hflocki/camper-mqtt/firmware/display/README.md

> [!WARNING]
> **IN ENTWICKLUNG – kein fertiges Projekt.** Am echten LIN-Bus (Truma) noch nicht getestet. Nutzung auf eigenes Risiko.

# Display Node – Guition 4" Wandpanel + Webseite per MQTT

Firmware für das **Guition ESP32-4848S040** (4", 480×480 Touch, ESP32-S3, 16 MB Flash, 8 MB PSRAM). Das Display hängt fest an der Wand und zeigt alle Camper-Werte gesammelt an; dieselben Seiten gibt es zusätzlich als **Webseite** direkt vom Display – z. B. auf Handy oder Tablet im Bett. Beide werden live über **MQTT** versorgt und können steuern. Reines **Arduino**, ohne ESPHome und ohne Home Assistant als Voraussetzung.

Passt zu den anderen Projekten:

| Gerät | Repo | Standard-Topic |
| --- | --- | --- |
| Frischwasser, Grauwasser, Gas | [tanklevel-node](../tanklevel) | `camper/tanklevel` |
| Ausrichtung (BNO085) | [level-node](../level) | `camper/level` ¹ |
| Truma Combi Heizung | [heater-node](../heater) oder CampMatic-Box, siehe [Heizung über CampMatic](#heizung-über-campmatic) | `camper/heater` ² |
| MaxxFan (VanTurtle) | [maxxfan-node](../maxxfan) | `camper/maxxfan` |
| Temperaturen (DS18B20) | [temp-node](../temp) | `camper/temp` |
| Batterien (Daly, Ective, BM2) | [battery-node](../battery) | `camper/battery` |
| Router (GPS, Mobilfunk) | Teltonika RUT956, siehe [Router-Daten](#router-daten-rut956) | frei |
| Zigbee2MQTT & alles andere | eigene Seiten und Kacheln | frei |

¹ Wer noch die Original-Firmware von klehnst nutzt (ab Werk `wowa/level`): dort den MQTT-Prefix auf `camper/level` stellen oder hier unter *Topics der Geräte* `wowa/level` eintragen.
² Bis heater-node 1.0 war der Standard `service/truma`. Ältere Geräte behalten ihre Einstellung; dann hier oder im Heizungs-Web-UI angleichen.

<p>
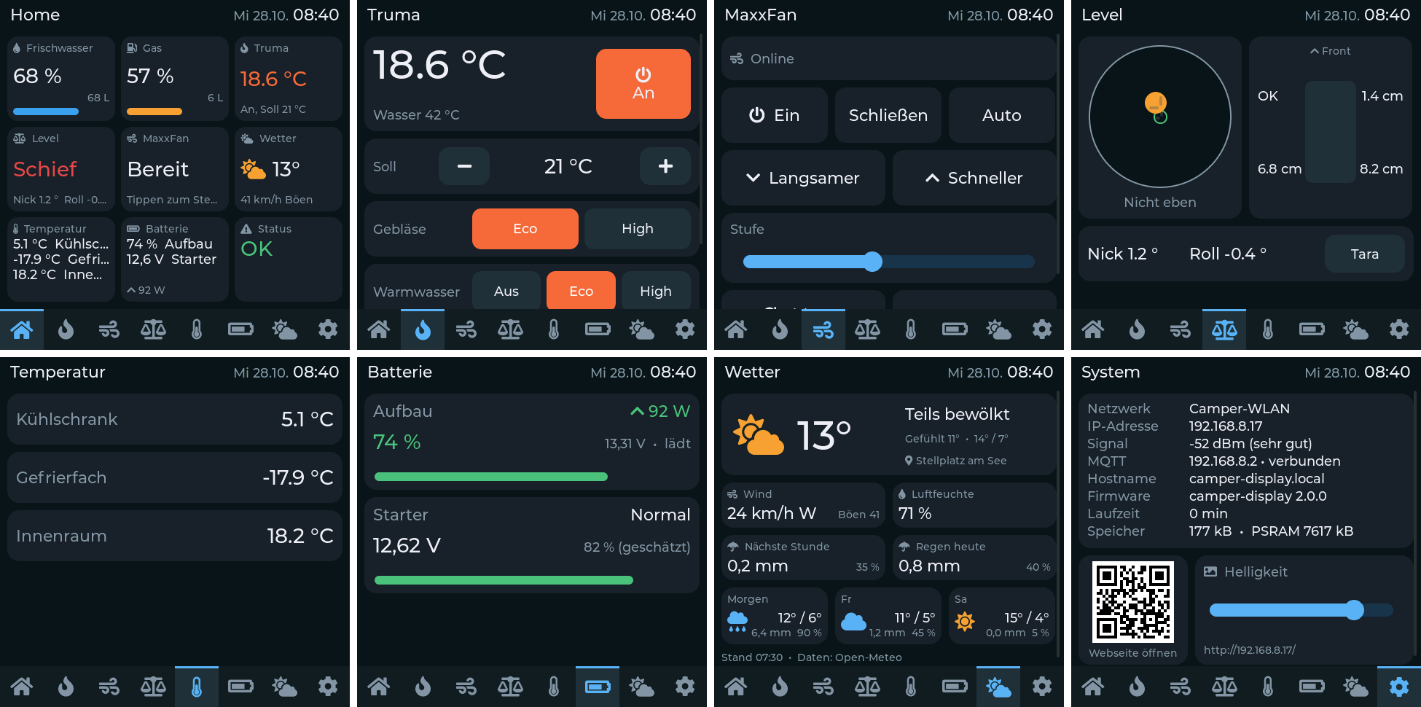
[picture p3: firmware/display/docs/display-seiten.png]

</p>
<p>

</p>
<p>
  
</p>

## Funktionen

- **Wandpanel** mit LVGL-Oberfläche: Icon-Leiste unten zum Wechseln der Seiten (oder wischen), deutsche Umlaute und Icons
- **Webseite** mit denselben Seiten, Werte in Echtzeit per WebSocket, für Handy optimiert, hell/dunkel automatisch. Unten eine Icon-Leiste wie am Display: Home und System immer, dazwischen so viele der gewählten Seiten, wie in die Breite passen (am Handy hochkant meist 3). Die Seite **System** zeigt Verbindung, Firmware, Helligkeit und alle **📡 Geräte im Netz** (aus `camper/+/status` und `camper/+/info`: online/offline, Version, Signal, Laufzeit; am Display ebenfalls auf der Systemseite, dort ganz oben; darunter QR-Code und Helligkeit, dann die Angaben zum Display selbst). Alte Einträge, die nach einem Topic-Wechsel am Broker liegen geblieben sind (offline oder „online“ ohne Info, gelber bzw. grauer Punkt), lassen sich auf der Webseite mit ✕ vom Broker löschen; tragen zwei Geräte denselben Namen, steht das Topic dahinter, z. B. „Heizung (truma)“ und führt zu ⚙ Einstellungen, ⚡ Automationen, 🔗 Geräte und allen Seiten, die keinen Knopf in der Leiste haben
- **📡 Eigene Sensoren:** Zigbee-Kontakte und -Klimasensoren direkt vom Gateway (Cluster-Topics, z. B. SMLIGHT) und Bluetooth-Thermometer über OpenMQTTGateway (Govee, Ruuvi, Xiaomi …), siehe [Sensoren](#sensoren-zigbee--bluetooth)
- **⚡ Automationen:** Regeln wie „Tür auf → Eingangslicht an, Tür zu → nach 10 s aus, nur wenn dunkel“, siehe [Automationen](#automationen)
- **Display aufwecken:** Ist der Bildschirm gedimmt oder aus, zeigt die Webseite oben den Knopf **💡 Display an**.
- **Feste IP abgesichert:** Eine feste IP, die nicht funktionieren kann (Gateway außerhalb des Netzes, falsches Subnetz), wird beim Speichern abgelehnt. Verbindet sich das Display mit fester IP zwar mit dem WLAN, erreicht aber 3 Minuten lang den MQTT-Broker nicht, schaltet es bis zum nächsten Neustart auf DHCP (Hinweis auf der Systemseite). Auf der Systemseite gibt es außerdem den Knopf *Feste IP aus (DHCP)* – lange drücken, das Display startet mit DHCP neu
- **Geräte-Links (nur Webseite):** Unter *Einstellungen → 🔗 Geräte-Links* Name und Adresse der anderen Geräte eintragen (oder „VanNode-Geräte vorschlagen“ für die `.local`-Namen). Die Seite **🔗 Geräte** (über *System*) zeigt sie als Buttons, die die jeweilige Konfigurationsseite in einem neuen Tab öffnen
- **Anzeigename:** Unter *Einstellungen → Display & Seiten* lässt sich ein Name eintragen (z. B. „Wohnraum“), der oben in der Mitte neben dem Seitentitel steht – am Display und auf der Webseite. Leer = kein Name
- **Übersicht ohne Scrollen:** 3 × 3 Kacheln, Standard: Frischwasser, Grauwasser, Gas, Truma, Level, MaxxFan, Temperatur (bis 3 Sensoren), Batterie (bis 3), jeweils mit Symbol statt Name (siehe *Symbole* unten) und Status (grün „OK“ oder die Warnungen auf dunklem Gelb). Antippen öffnet die jeweilige Seite. **Welche Kachel wo steht, ist frei wählbar** (*Einstellungen → Display & Seiten → Kacheln der Übersicht*): zusätzlich einzelne Batterien (Batterie 1–3 groß), **Dachhaube**, Uhr/Datum, eigene MQTT-Kacheln aus *Seiten & Kacheln* oder leer. Die Webseite übernimmt dieselbe Reihenfolge
- **Feste Seiten:** Home · Truma · MaxxFan · Level · Temperatur · Batterie · **Wetter** · **Sensoren** (Fenster, Türen und weitere Sensoren) · **Warnungen** · **Licht** · **Schalter** · **Energie** und **Extra** (zwei freie Seiten für später, ab Werk aus) · **Dachhaube** (Heki über die toolbox-node, ab Werk aus) – einzeln abschaltbar und **System** (Netzwerk, IP, Signal, MQTT, Firmware, Laufzeit, Speicher als Liste, dazu QR-Code und Helligkeit). **Name und Symbol** jeder festen Seite (auch System) lassen sich unter *Einstellungen → 🖥 Anzeige → Seiten & Symbolleiste* ändern; sie erscheinen in der Kopfzeile, auf den Kacheln der Übersicht und auf der Webseite
- **Kopfzeile:** Seitenname · Anzeigename · Datum · Uhr. Antippen springt zur Übersicht. Bei Verbindungsproblemen steht dort „WLAN“ bzw. „MQTT“
- **Icon-Leiste unten:** 8 Knöpfe: **Home** und **System** sind immer da, dazu bis zu 6 frei wählbare Seiten (*Einstellungen → Display & Seiten → Symbolleiste*, leer = die ersten 6). Seiten ohne Knopf erreicht man über ihre Kachel auf Home oder durch Wischen, auf der Webseite über *System → Weitere Seiten*. Die aktive Seite ist hervorgehoben. Die Webseite nutzt dieselbe Auswahl
- **Wetter** von [Open-Meteo](https://open-meteo.com) (kostenlos, ohne Konto): aktuelles Wetter, nächste Stunde, heute und 3 Tage Vorschau. Fester Ort oder GPS per MQTT (z. B. vom Router), siehe [Wetter](#wetter)
- **Warnungen:** Temperatur-Alarme von temp-node, Heizungsfehler, Batterie- (mit dem Fehler des BMS im Klartext) und Wetter-Warnungen erscheinen in der Status-Kachel der Übersicht (dunkelgelb) (antippen öffnet die Seite **Warnungen** mit dem vollen Text; auf der Webseite ebenso) und als **dunkelgelbes Band mit Lauftext** in der Kopfzeile. Wer möchte, dass eine neue Warnung das Display einschaltet, setzt unter *Einstellungen → Display & Seiten* den Haken **Neue Warnung schaltet das Display ein** (Standard aus); war es dunkel, springt es dann auf die Übersicht. Optional zusätzlich als **Push-Nachricht** per Pushover
- **Temperatur- und Batterie-Kachel frei belegbar:** unter *Einstellungen → Display & Seiten* für die Temperatur-Kachel bis zu 6 Sensoren (auch eigene Zigbee-/Bluetooth-Sensoren; mehr als 3 wechseln alle 4 s, unten steht „1 / 2“), für die Batterie-Kachel bis zu 3 Batterien aus einer Liste wählen und dahinter das Symbol (Batterie, Starterbatterie, Wohnraum, Sonne, Solarpanel, Fahrzeug, Landstrom, Strom, Thermometer, Kühlschrank, Gefrierfach, Innenraum, Außen, Schlafen, Wasser, Heizung, Bad, Stauraum). Die Kachel zeigt dann Symbol und Wert in dieser Reihenfolge. Leer = alle Temperatursensoren bzw. die ersten 3 Batterien, „Symbol automatisch“ wählt nach dem Namen (z. B. Kühlschrank 🧊, Gefrierfach ❄️, Außen 🌳, Aufbau 🏠, Solar ☀️, Starter 🚗). Meldet ein gewählter Sensor nichts, steht dort „--“
- **Eigene Seiten und Kacheln** für beliebige MQTT-Topics: *Wert*, *Schalter*, *Taster*, *Regler* – erscheinen automatisch auf Display **und** Webseite
- **Topic-Finder:** lauscht z. B. auf `zigbee2mqtt/#`, zeigt alle Geräte mit ihren JSON-Werten; ein Klick legt eine Kachel an (Temperatur, Luftfeuchte, Licht an/aus, Helligkeit …)
- **Setup-WLAN** wie bei den anderen Projekten: ohne WLAN-Daten oder nach 1 Minute ohne Verbindung öffnet sich `Display-Node-XXXXXX`, Captive Portal unter `http://192.168.4.1`. Das Display zeigt dazu einen QR-Code zum Verbinden.
- **Stromausfallsicher:** keine SD-Karte, kein Dateisystem. Webseite und Oberfläche stecken in der Firmware, Einstellungen im NVS. Strom an → nach ca. 1–2 s läuft alles wieder.
- Bildschirm dimmt bzw. schaltet nach einstellbarer Zeit ab (Helligkeit gedimmt 0 = ganz aus), Berühren weckt (die erste Berührung löst nichts aus). Sofort ausschalten: **Kopfzeile lange drücken**, Knopf **Aus** auf der Systemseite oder **💤** oben auf der Webseite
- Uhrzeit per NTP, Firmware-Update über die Webseite (`.bin`-Datei, mit Fortschrittsbalken) oder Arduino-IDE-Netzwerkport
- **Einstellungen sichern und wiederherstellen** als JSON-Datei (ohne Passwörter)
- **Verlauf der letzten 24 h** als Kurven auf der Webseite: Temperaturen, Ladestand bzw. Spannung der Batterien
- **Warnungen für eigene Kacheln**, z. B. Landstrom über eine Zigbee-Messzange: Wert unter/über einer Grenze oder keine Daten mehr
- Eigene MQTT-Topics für Helligkeit, Bildschirm an/aus und Seitenwechsel (z. B. aus Home Assistant)

## Ordner

```
camper_display/            Sketch für die Arduino IDE
lv_conf.h                  LVGL-Konfiguration (muss in den libraries-Ordner, siehe unten)
tools/embed_web.py         packt web/index.html in web_ui.h
tools/make_fonts.py        erzeugt die Schriften font_de_*.c neu
docs/                      Screenshots
```

| Datei | Inhalt |
| --- | --- |
| `config.h` | Pins, Panel-Variante, Drehung, Standardwerte, `FW_VERSION` |
| `display_hw.*` | ST7701-RGB-Panel, GT911-Touch (ohne Library), Hintergrundlicht, LVGL-Treiber |
| `ui.*` | Display-Oberfläche (alle Seiten) |
| `datastore.*` | zentrale Werte aller Geräte und Kacheln, Topic-Zuordnung |
| `mqtt_client.*` | MQTT, Befehle an die Geräte, Topic-Finder |
| `web.*`, `web_ui.h`, `web/index.html` | Webserver, WebSocket, Einstellungs-API, Firmware-Update |
| `wifi_manager.*` | WLAN, feste IP, Setup-AP, mDNS, NTP |
| `settings.*` | Einstellungen, Seiten und Kacheln im NVS |
| `notify.*` | Push-Nachrichten per Pushover (eigener Task, HTTPS mit Zertifikatsprüfung) |
| `otaprog.*` | Fortschritt des Firmware-Uploads für den Update-Bildschirm |
| `history.*` | 24-h-Verlauf der Temperaturen und Batterien im RAM |
| `rules.*` | Automationen (Regeln, eigener NVS-Bereich) |
| `sensors.*` | Eigene Zigbee- und Bluetooth-Sensoren (eigener NVS-Bereich) |
| `icons.*` | Symbole und Auswahl für die Temperatur- und Batterie-Kachel |
| `weather.*` | Wetter von Open-Meteo (eigener Task), GPS-Position per MQTT, Wetter-Warnungen |
| `depart.*` | Abfahrtscheck: Fahrt aus dem GPS des Routers, Tür, Markise, Kontakte |
| `font_de_*.c` | Montserrat mit Umlauten + Font-Awesome-Icons, erzeugt mit `tools/make_fonts.py` |
| `logo_img.c` | VanNode-Symbol für Kopfzeile und QR-Code, erzeugt mit `tools/logo/make_logo.py` im Repo |

## Hardware

**Guition ESP32-4848S040** (4"-86-Box-Panel, ST7701S über 16-Bit-RGB, GT911-Touch). Belegung wie in der Arduino_GFX-Vorlage `ESP32_4848S040_86BOX_GUITION`:

| Funktion | GPIO |
| --- | --- |
| Hintergrundlicht | 38 |
| ST7701 SPI (Init) | CS 39, SCK 48, MOSI 47 |
| RGB | DE 18, VSYNC 17, HSYNC 16, PCLK 21 |
| Touch GT911 (I2C) | SDA 19, SCL 45 |

- Bleibt das Bild schwarz oder sind die Farben falsch, in `config.h` `LCD_INIT_TYPE` von `9` auf `1` stellen (ältere Panel-Chargen).
- Hochkant/quer montiert: `LCD_ROTATION` (0–3). Touch dreht mit; falls Tipps trotzdem daneben liegen: `TOUCH_SWAP_XY` / `TOUCH_INVERT_X` / `TOUCH_INVERT_Y`.
- Versorgung im Camper über einen 12→5-V-Wandler auf den 5-V-Eingang des Boards (bzw. die 86-Box-Netzteilvariante nicht an 12 V hängen).

## Arduino IDE

> **Eigene Passwörter, WLAN und Broker:** `config_local.h.example` im Sketch-Ordner nach `config_local.h` kopieren und anpassen. Die Datei geht nicht nach GitHub. Details in der [Haupt-README](../../README.md#eigene-einstellungen-config_localh).

**Board-Paket:** esp32 von Espressif **3.3.x** (getestet mit 3.3.2)

| Einstellung | Wert |
| --- | --- |
| Board | ESP32S3 Dev Module |
| USB CDC On Boot | Enabled |
| Flash Size | 16MB (128Mb) |
| PSRAM | **OPI PSRAM** |
| Partition Scheme | 16M Flash (3MB APP/9.9MB FATFS) |
| Upload Speed | 921600 |

**Bibliotheken** (Bibliotheksverwalter):

| Bibliothek | Version |
| --- | --- |
| GFX Library for Arduino (moononournation) | 1.6.x |
| lvgl | **9.2.x** |
| ESP Async WebServer (ESP32Async) | 3.8.x |
| Async TCP (ESP32Async) | 3.4.x |
| PubSubClient (knolleary) | 2.8 |
| ArduinoJson (bblanchon) | 7.x |

**LVGL-Konfiguration:** `lv_conf.h` in den Arduino-Bibliotheksordner kopieren, **neben** den Ordner `lvgl` (nicht hinein):

```
~/Documents/Arduino/libraries/lv_conf.h
~/Documents/Arduino/libraries/lvgl/
```

Dann `camper_display/camper_display.ino` öffnen, kompilieren, hochladen. Die Firmware belegt ca. 1,9 MB von 3 MB.

Die Webseite liegt als lesbare Datei in `web/index.html`. Nach Änderungen daran `python3 tools/embed_web.py` ausführen (nur Python-Standardbibliothek, keine venv nötig) – das schreibt `web_ui.h` neu.

**Schriften:** Wer weitere Zeichen oder Icons braucht, trägt sie in `tools/make_fonts.py` ein und führt `python3 tools/make_fonts.py` aus. Das Skript braucht Node.js (`npx` lädt `lv_font_conv` 1.5.3) und die Schriftdateien aus `lvgl/scripts/built_in_font` der LVGL-Bibliothek; sonst nur die Python-Standardbibliothek.

## Einrichtung

1. Nach dem ersten Flashen zeigt das Display die Seite **System** mit einem QR-Code. Scannen (oder WLAN `Display-Node-XXXXXX`, Passwort `display1234` – in `config.h` ändern) → die Einstellungsseite öffnet sich.
2. **WLAN** eintragen (Suchen-Knopf listet Netze), **MQTT-Broker** = IP des RUT956 → *Einstellungen speichern*. Das Display startet neu und verbindet sich.
3. Danach ist die Webseite unter `http://display-node.local` bzw. der IP erreichbar; die System-Seite am Display zeigt die Adresse auch als QR-Code.
4. Unter **Topics der Geräte** prüfen, ob die Basis-Topics zu deinen Geräten passen (Standard: `camper/tanklevel`, `camper/level`, `camper/heater`, `camper/maxxfan`, `camper/temp`, `camper/battery`; MaxxFan-Port 0/1). Leeres Feld = Gerät nicht vorhanden.
5. Optional unter **System** ein Web-Passwort setzen – dann sind Einstellungen und Firmware-Update geschützt. Die Bedienseiten bleiben im eigenen WLAN offen.

## Seiten und Kacheln

Unter *Einstellungen → Seiten & Kacheln* beliebig viele eigene Seiten (max. 8) mit Kacheln (max. 40) anlegen. Jede Kachel erscheint auf dem Display und auf der Webseite.

| Typ | Anzeige | sendet |
| --- | --- | --- |
| Wert | Wert + Einheit | – |
| Schalter | An/Aus + Schalter | `Payload EIN` / `Payload AUS` an das Befehls-Topic |
| Taster | Knopf | `Payload` |
| Regler | Schieberegler (Min/Max/Schritt) | `Payload` mit `{v}` als Platzhalter, leer = nur die Zahl |

- **Status-Topic** ist das Topic, das gelesen wird; Wildcards sind hier nicht erlaubt.
- **JSON-Schlüssel** holt einen Wert aus JSON, auch verschachtelt (`update.state`). Leer = ganzer Payload.
- **Befehls-Topic** leer = Status-Topic + `/set` (Zigbee2MQTT-Konvention).

**Beispiel Zigbee2MQTT:**

| Kachel | Typ | Status-Topic | Schlüssel | Befehl |
| --- | --- | --- | --- | --- |
| Innentemperatur | Wert | `zigbee2mqtt/Sensor Wohnraum` | `temperature` | – |
| Licht Küche | Schalter | `zigbee2mqtt/Licht Küche` | `state` | `{"state":"ON"}` / `{"state":"OFF"}` |
| Dimmer | Regler 0–254 | `zigbee2mqtt/Licht Küche` | `brightness` | `{"brightness":{v}}` |

Am schnellsten geht es mit dem **Topic-Finder**: Filter `zigbee2mqtt/#` starten, kurz warten (retained Werte kommen sofort, andere bei der nächsten Änderung), dann beim gewünschten Gerät auf einen Schlüssel klicken. Für `state` und `brightness` werden Schalter bzw. Regler mit den passenden Befehlen vorbelegt. Danach *Seiten speichern*. Der Finder hört höchstens 15 Minuten mit und ignoriert `zigbee2mqtt/bridge/…`.

### Warnung an einer Kachel (z. B. Landstrom)

Kacheln vom Typ *Wert* und *Schalter* können eine Warnung auslösen. Sie erscheint wie die anderen Warnungen in der Status-Kachel, im gelben Band und per Pushover.

| Feld | Wirkung |
| --- | --- |
| Anzeige umbenennen | nur Typ *Wert*: empfangene Texte anders anzeigen, z. B. `close=Zu, open=Offen` (Groß-/Kleinschreibung egal) |
| Warnung | keine, *wenn Wert unter …* / *über …* den Grenzwert, oder *wenn Wert gleich …* einem Text (empfangen oder angezeigt, z. B. `open`) |
| Warnen, wenn keine Daten seit | Minuten ohne Nachricht auf dem Status-Topic, 0 = aus |
| Warntext | erscheint statt „<Name> zu niedrig/hoch“, z. B. „Landstrom weg“ |

**Türkontakt am RUT956** (Eingang als MQTT, z. B. Topic `camper/door` mit `{"Door":{"name":"din2","type":"Digital In","state":"close",…}}`): Kachel *Wert*, Status-Topic `camper/door`, Schlüssel `Door.state`, Anzeige umbenennen `close=Zu, open=Offen`, Warnung *wenn Wert gleich* `open`, Warntext `Tür offen`. Den genauen Text für „offen“ zeigt der Topic-Finder, sobald die Tür einmal offen war.

**Landstrom mit einer Tuya-Zigbee-Messzange** (über Zigbee2MQTT): Kachel *Wert* mit Status-Topic `zigbee2mqtt/<Name der Zange>`, Schlüssel `voltage`, Einheit `V`. Warnung *wenn Wert unter* `180`, Warntext `Landstrom weg`. Viele dieser Zangen hängen selbst am 230-V-Netz und schweigen, wenn der Landstrom fehlt. Deshalb zusätzlich *Warnen, wenn keine Daten seit* `10` Minuten eintragen; im Topic-Finder sieht man, wie oft die Zange sendet. Wer nur die Leistung hat, nimmt den Schlüssel `power` und warnt z. B. unter `1` W.

### Sensorseiten (Sensoren, Energie, Extra)

Lichter und Schalter stehen oben als große Karten zum Bedienen. Kontakte und Klimasensoren folgen als kleine Kacheln, 4 pro Reihe (16 ohne Scrollen): Symbol links oben in der Zustandsfarbe (grün zu, gelb offen, grau keine Daten), rechts oben „zu“/„offen“ bzw. die Temperatur, darunter der Name in bis zu zwei Zeilen. Ein offener Kontakt färbt die ganze Kachel dunkelgelb. 5 pro Reihe: `#define DEV_TILE_COLS 5` in `config_local.h` (Namen brechen dann früher um).

### Farben in der Übersicht

Panel, Webseite und Road Buddy nutzen dieselbe Palette (ab 2.12.0): dunkle Flächen, Grün = OK, Gelb = bitte ansehen, Rot = Fehler, Blau = Bedienung. Die Werte stehen als `C_*` in `ui.cpp`, in `firmware/_common/web/camper-theme.css` und als `COL_*` im Road Buddy.

Alle Kacheln folgen demselben Aufbau: oben ein farbiger Kreis mit Symbol und der Titel, links groß der Wert, unten eine Zeile mit Details, rechts eine Grafik – ein Farbkreis mit Symbol (Heizung, MaxxFan, Status), die Libelle (Level), ein großes Wettersymbol oder die Tank-/Gasflaschen-Zeichnung. Ist ein Gerät offline oder aus (Heizung), wird sein Kreis grau. Temperaturen auf Kacheln stehen kurz als „19,7°“.

**Home auf der Webseite:** Die Webseite hat eine eigene Kachel-Auswahl unter *Einstellungen → Home auf der Webseite*, unabhängig von den 3 × 3 Kacheln am Display. Feste Plätze je Gruppe: Tanks 4, Klima 4, Temperatur 2, Energie 2, Fahrzeug 4. Jeder Platz kann jede Kachel zeigen (auch MQTT-Kacheln); „(leer)“ lässt den Platz frei, eine Gruppe ohne Kacheln fällt weg. MQTT-Kacheln ohne Platz stehen darunter unter „Eigene Kacheln“. Am PC stehen 4 Kacheln nebeneinander, am Handy 2.

**Batterie- und Temperatur-Kachel:** Unter *Einstellungen → Home am Display* bestimmt die erste Zeile („groß“), welche Batterie bzw. welcher Sensor groß angezeigt wird; die weiteren erscheinen klein mit ihrem Symbol darunter (Batterie: 2, Temperatur: 4). Alle stehen auf den Seiten Batterie und Temperatur. Die Batterie zeigt eine Segmentanzeige aus 13 Feldern von Rot nach Grün – nach Ladezustand, bei Batterien ohne Ladezustand (z. B. BM2 an der Starterbatterie) nach Spannung von 11,8 V (leer) bis 12,8 V (voll). Die Segmentanzeige steht auch auf der Seite Batterie. Die Restlaufzeit steht mit Uhr-Symbol (statt „noch …“) auf Kachel und Batterieseite. Die Symbolfarbe richtet sich nach dem gewählten Symbol (z. B. Schneeflocke hellblau, Auto grau, Haus grün, Sonne gelb).

Gas wird als Gasflasche, Frisch- und Grauwasser als Tank mit Skala (25/50/75 %) gezeichnet, die sich von unten füllen. Die Füllung färbt sich nach Zustand: Frischwasser gelb unter 25 %, rot unter 10 %; Gas rot unter 15 %; Grauwasser gelb ab 70 %, rot ab 85 %. Die Prozentzahl wird nur im kritischen Bereich rot. Die Level-Kachel zeigt neben „Eben“/„Schief“ eine kleine Libelle, deren Punkt mit Nick und Roll wandert (Rand = 5°); darunter stehen P (Pitch/Nick) und R (Roll). Zahlen stehen überall mit Dezimalkomma. Ist ein Gerät offline, erscheinen seine Werte grau.

**Level-Seite** (Display und Webseite gleich, ebenso der Road Buddy): das Fahrzeug von oben, „vorne“ oben. An jedem Rad steht die Keilhöhe in cm vom Levelsensor (`wedge_fl/fr/rl/rr`). Räder, die einen Keil brauchen, und ihre Zahl sind orange. In der Mitte ein Zielring, der Punkt wandert zur tiefen Seite (Rand = 3°) und ist grün, wenn das Fahrzeug eben steht. Rechts „Eben“ / „Nicht eben“, darunter *Quer* („0,9° rechts tief“) und *Längs* („eben“, innerhalb der Toleranz). Unten der Satz zum Unterlegen, z. B. „Rechts vorne 3 cm, links hinten 1 cm, rechts hinten 4 cm unterlegen“. Tara am Display lange drücken.

## MQTT

Das Display abonniert `<Basis-Topic>/#` jedes Geräts und die Topics der Kacheln. Befehle werden nicht retained gesendet.

**Gelesene Werte**

| Seite | Topics |
| --- | --- |
| Tanks | `water/percent`, `water/liters`, `grey/percent`, `grey/liters`, `gas/level`, `gas/content`, `status` |
| Ausrichtung | `pitch`, `roll`, `is_level`, `tolerance`, `wedge_fl/fr/rl/rr`, `status` |
| Heizung | `control_status/current_temp_room`, `room_setpoint`, `hvac_mode`, `fan_mode`, `water_mode`, `current_temp_water`, `operating_status_text`, `error_code`, `heater_error`, `decoke`, `decoke_remaining`, `alive`; `status` |
| MaxxFan | `p<n>/auto_hold`, `p<n>/led`, `status` |
| Dachhaube (Toolbox) | `rvtech/cover`, `rvtech/cover_position`, `rvtech/reported` (102 = Lüften), `rvtech/connected`, `status` |
| Temperaturen | `sensors` (JSON-Liste aller Sensoren mit Name, Wert und Alarm), `alarm_text`, `status` |
| Batterien | `batteries` (JSON-Liste aller Batterien mit Ladestand, Spannung, Leistung, Restlaufzeit, BM2-Zustand), `status`. Seite *Batterien*: je Batterie eine Karte mit Ladestand-Balken, Leistung (▲ lädt / ▼ entlädt), Restlaufzeit; beim BM2 Spannung und Zustand |

**Gesendete Befehle**

| Bedienung | Topic | Payload |
| --- | --- | --- |
| Heizung an/aus | `<heizung>/set/hvac_mode` | `heat` / `off` |
| Solltemperatur | `<heizung>/set/room_setpoint` | `5` … `30` (1 s nach dem letzten Tippen) |
| Gebläse | `<heizung>/set/fan_mode` | `eco` / `high` |
| Warmwasser | `<heizung>/set/water_mode` | `off` / `eco` / `high` |
| Freibrennen | `<heizung>/set/decoke` | `ON` / `OFF` (am Display lange drücken) |
| Lüfter-Tasten | `<maxxfan>/cmd/p<n>/<taste>` | `PRESS` (`on_off`, `auto`, `faster`, `slower`, `direction`, `close` = Haube schließen, ab maxxfan-node 1.4.0) |
| Lüfter-Stufe | `<maxxfan>/cmd/p<n>/speed/set` | `1` … `10` |
| Sync AUS | `<maxxfan>/cmd/sync_off` | `PRESS` |
| Tara | `<level>/cmd/tare/set` | `PRESS` (am Display lange drücken) |
| Dachhaube Auf / Zu / Regen / Lüften | `<toolbox>/cmd/rvtech/<auf\|zu\|regen\|lueften>/set` | `PRESS` |
| Dachhaube Position | `<toolbox>/cmd/rvtech/cover_position/set` | `0` … `100` (beim Loslassen des Reglers) |

**Eigene Topics** (Basis `camper/display`)

| Topic | Inhalt |
| --- | --- |
| `camper/display/status` | `online` / `offline` (Last Will) |
| `camper/display/info` | Diagnose (retained, beim Verbinden und jede Minute): JSON mit `version`, `ip`, `mac`, `rssi`, `uptime` (s), `reset` (Grund des letzten Neustarts), `heap` |
| `camper/display/ip`, `/rssi`, `/brightness`, `/screen` | Zustand (retained) |
| `camper/display/cmd/brightness` | `5` … `100` |
| `camper/display/cmd/screen` | `ON` / `OFF` |
| `camper/display/cmd/page` | Seitenname (`Heizung`) oder Nummer (`0` = erste) |
| `camper/display/awning` | Markise `ON` (ausgefahren) / `OFF` / `unknown` (retained) |
| `camper/display/cmd/awning` | `ON` / `OFF` / `TOGGLE` (nur ohne Kontakt-Sensor) |
| `camper/display/driving` | Abfahrtscheck: `ON` während der Fahrt, sonst `OFF` (retained) |
| `camper/display/depart` | Abfahrtscheck: `OK` oder die offenen Teile, z. B. `Tür offen, Markise ausgefahren` (retained) |
| `camper/display/cmd/reboot` | beliebig |

Beispiel: `mosquitto_pub -h <broker> -t camper/display/cmd/screen -m OFF`

### Dachhaube (Heki über die toolbox-node)

Die Seite **Dachhaube** zeigt den Zustand („Zu“, „Offen 40 %“, „Regen“, „Lüften“, „Öffnet …“) und die Bluetooth-Verbindung der Toolbox zur Haube. Darunter die vier Voreinstellungen der Toolbox (**Auf** 100 %, **Zu**, **Regen** 12 %, **Lüften**), die aktive ist hervorgehoben, und ein Regler für die Position. Der Regler folgt der Haube, während sie fährt, aber nicht, solange man ihn anfasst.

Einschalten: *Einstellungen → 🖥 Anzeige → Seiten & Symbolleiste*, Haken bei **Dachhaube** (ab Werk aus). Die kleine Kachel für die Übersicht gibt es unter *Kacheln der Übersicht* → **Dachhaube**; sie zeigt den Zustand bzw. die Öffnung in %, gelb, solange die Haube offen ist. Antippen öffnet die Seite, das geht nur, wenn die Seite eingeschaltet ist. Basis-Topic unter *Topics der Geräte → Toolbox* (Standard `camper/toolbox`, leer = keine Toolbox). Eine zweite Haube (`rvtech2`) zeigt das Display noch nicht.

## Warnungen

Die Status-Kachel der Übersicht wird rot und zeigt die Warnungen, solange etwas nicht stimmt:

| Quelle | Wann |
| --- | --- |
| temp-node | `alarm_text` ist nicht leer (Grenzwert eines Sensors länger als die eingestellte Verzögerung verletzt) |
| heater-node | `control_status/heater_error` = `ON`, mit Fehlercode |
| Wetter | Böen ab dem eingestellten Wert (Standard 60 km/h) oder Gewitter, siehe [Wetter](#wetter) |
| tanklevel-node | Frischwasser unter 10 %, Gas unter 15 % (einstellbar) |
| Frost | Außentemperatur unter 3 °C (ab Werk aus): gewählter Außensensor, sonst das Wetter |
| Markise | Markise ausgefahren und Böen ab 40 km/h (einstellbar, eigene Grenze unter der normalen Wind-Warnung) |
| Abfahrtscheck | Während der Fahrt: Tür offen, Markise ausgefahren oder ein eigener Kontakt (Fenster, Dachhaube) offen – je Teil eine Warnung, siehe unten |
| Eigene Klimasensoren | Temperatur über „Warnung über °C“ des Sensors, z. B. Zigbee-Sensor im Kühlschrank |
| battery-node | Ladestand unter 20 % (einstellbar, Vorgabe `BAT_WARN_SOC` in `config.h`, mit Restlaufzeit), BM2-Zustand „Schwach“ oder „Kritisch“ (Starterbatterie), BMS meldet einen Fehler – ab battery-node 1.3.1 mit Text, z. B. „Bordbatterie BMS: Zellspannung zu hoch (Stufe 1)“, auch auf der Batterieseite. Batterien ohne Verbindung lösen keine Warnung aus |

Warnungen von Geräten, die `offline` sind, werden nicht gezeigt (alte retained Werte sollen keinen Fehlalarm auslösen). Grenzwerte und Verzögerung der temp-node-Sensoren stellt man direkt in temp-node ein, nicht am Display.

**Grenzwerte und Hysterese** stehen unter *Einstellungen → 🌦 Dienste → ⚠️ Warnungen*: Frischwasser, Gas, Batterie (0 = aus), Frost (an/aus, Grenze in °C), dazu die Hysterese für Füllstände/Batterie (Standard 3 %), Temperaturen (1,0 °C) und Böen (10 km/h). Eine Warnung endet erst, wenn der Wert die Grenze um die Hysterese überschritten hat – so kommt und geht sie nicht bei jedem Messwert knapp an der Grenze.

**Außentemperatur:** Im selben Abschnitt wählst du den Sensor für die Außentemperatur – einen eigenen Zigbee-/Bluetooth-Klimasensor oder einen Sensor von temp-node. Er gilt für die Wetter-Seite, die Wetter-Kachel und die Frostwarnung. „automatisch“ nimmt wie bisher den ersten eigenen Sensor mit dem Haken „Wetter“.

**Markise:** Ohne Kontakt an der Markise setzt du den Zustand von Hand – Knopf auf der Wetter-Seite (Display und Webseite) oder per MQTT `camper/display/cmd/awning` = `ON`/`OFF`/`TOGGLE`. Der Zustand bleibt über einen Neustart erhalten. Gibt es später einen Kontakt (Zigbee-Tür-/Fensterkontakt an der Markise, offen = ausgefahren), wählst du ihn unter „Zustand kommt von“, dann verschwindet der Knopf. Die Böen kommen von Open-Meteo, also so aktuell wie das eingestellte Abrufintervall des Wetters.

**Abfahrtscheck:** Das Display erkennt die Fahrt am GPS des Routers: Der RUT956 sendet per „Data to Server“ auf `camper/rut` ein JSON mit `GPS.speed` (km/h) und `GPS.fix_status`. Fährt der Camper länger als 10 s schneller als 5 km/h (beides einstellbar) mit GPS-Fix, gilt das als Fahrt. Sie endet nach 2 Minuten Stillstand oder wenn 3 Minuten keine GPS-Daten kommen. Geprüft werden:

- **Tür** vom Topic `camper/door` (Digitaleingang des RUT956 `{"Door":{"state":"open"|"close",…}}` oder einfach `open`/`closed`/`ON`/`OFF`/`1`/`0`); meldet der Eingang verkehrt herum, Haken „umkehren“ setzen
- **Markise** (Schalter oder Kontakt, siehe oben)
- **eigene Kontakte** aus 📡 Sensoren, die auf einer Geräteseite stehen (Fenster, Dachhauben), abschaltbar

Ist während der Fahrt etwas offen, kommt je Teil eine Warnung („Tür offen während der Fahrt“) – im Display, im gelben Band und per Pushover. Die Liste mit allen Punkten steht auf der Seite **Warnungen** (Display und Webseite), auch im Stand. Einstellungen unter *Einstellungen → 🌦 Dienste → ⚠️ Warnungen → Abfahrtscheck*. Die Einheit von `speed` beim RUT956 ist km/h; bitte bei der ersten Fahrt gegenprüfen (Seite Warnungen zeigt die Geschwindigkeit). Zum Testen ohne Fahrt: `python3 tools/mqtt/sim.py --host <broker> depart`.

### Push-Nachrichten (Pushover)

Das Display kann jede Warnung zusätzlich aufs Handy schicken, auch wenn niemand im Camper ist. Es läuft ohnehin immer und sieht alle Warnungen, deshalb sitzt das hier und nicht in den einzelnen Geräten.

1. Bei [pushover.net](https://pushover.net) anmelden, App aufs Handy. Der **User-Key** steht auf der Startseite.
2. Unter *Your Applications → Create an Application* eine Anwendung anlegen (Name z. B. „Camper“). Deren **API-Token** brauchst du.
3. Am Display unter *Einstellungen → 📲 Pushover*: Token und User-Key eintragen, **Warnungen senden** anhaken, *Einstellungen speichern*, dann **Testnachricht**.

| Einstellung | Wirkung |
| --- | --- |
| Warnungen senden | Eine Warnung wird gesendet, sobald sie 30 s ununterbrochen besteht (`PUSHOVER_STABLE_MS`) |
| Nachricht, wenn eine Warnung vorbei ist | „✅ Kühlschrank zu warm – Wieder in Ordnung“, leise (Priorität −1) |
| Priorität (Standard) | Leise, Normal, Hoch (klingelt auch in den Pushover-Ruhezeiten) oder Notfall – gilt für alle Arten auf „wie Standard“ |
| Dringlichkeit je Warnungsart | Eigene Priorität für Kühlschrank/Temperatur, Heizung, Batterie, Frischwasser, Gas, Frost, Wetter/Markise, Abfahrtscheck, eigene Kacheln, Regeln und Kontakte. Zusätzlich **Aus (nur Display)**: Die Warnung erscheint am Display, geht aber nicht aufs Handy |
| Notfall: wiederholen alle / höchstens für | Ein Notfall (Priorität 2) klingelt alle 300 s erneut, bis er in der App bestätigt ist, höchstens 3600 s lang (Grenzen von Pushover: ab 30 s, bis 3 h). Ist die Warnung vorbei, stoppt das Display die Wiederholung (`cancel_by_tag`) |
| Ruhezeit (unter ⚠️ Warnungen) | Kommt eine Warnung innerhalb dieser Zeit wieder (Standard 30 min), wird sie nicht noch einmal gesendet – auch kein „Erledigt“ |

**Aufbau einer Nachricht** (wie bei Home Assistant): Die Überschrift ist die Warnung selbst mit einem Symbol je Art (🌡️ Temperatur, 🔥 Heizung, 🔋 Batterie, 💧 Wasser, ⛽ Gas, ❄️ Frost, ⛈️ Wetter, 💨 Wind/Markise, 🚐 Abfahrtscheck, 🔔 eigene Kacheln, ⚙️ Regeln, 🚪 Kontakte), der Text der aktuelle Wert oder ein kurzer Hinweis. Beispiel: „💧 Frischwasser niedrig“ / „Aktuell 8 %“. Der Absender („Camper“) und das Symbol links kommen von der Pushover-Anwendung (Name und Icon unter *Your Applications*).

Eine Warnung wird pro Ereignis nur einmal gesendet. Ändert sich nur der Wert („9,2 °C“ → „9,8 °C“), kommt keine neue Nachricht. Geht ein Gerät offline, gilt seine Warnung nicht als erledigt. Ohne WLAN oder bei einem Serverfehler versucht das Display es bis zu 5-mal im Minutenabstand. Token und User-Key lassen sich auch in `config_local.h` vorbelegen (`DEFAULT_PUSHOVER_TOKEN`, `DEFAULT_PUSHOVER_USER`).

## Wetter

Die Wetterseite zeigt unter dem aktuellen Wetter Sonnenaufgang, Sonnenuntergang und die Tageslichtdauer für heute (aus derselben Open-Meteo-Abfrage).

Unter *Einstellungen → 🌦 Wetter*:

| Einstellung | Wirkung |
| --- | --- |
| Wetter abrufen | schaltet die Abfrage ein. Das Display braucht dafür Internet über den Router |
| Ort suchen | Ortsname eingeben, *Suchen*, Treffer antippen. Das füllt Breiten-, Längengrad und Ortsnamen aus (die Suche läuft im Browser über Open-Meteo) |
| Breitengrad / Längengrad | fester Standort, z. B. `47.66` / `9.175`. Komma statt Punkt geht auch |
| Ortsname | steht auf der Wetterseite, nur zur Anzeige |
| GPS per MQTT | optional ein Topic mit der aktuellen Position, z. B. vom Router. Dann folgt das Wetter dem Fahrzeug; ohne Position gilt der feste Ort |
| Warnung ab Böen | km/h, 0 = keine Wind-Warnung |
| Aktualisieren | alle 15/30/60/120 Minuten, Standard stündlich. Fährt das Fahrzeug mehr als 5 km weiter, wird sofort neu abgefragt |

Das GPS-Topic darf JSON mit `lat`/`lon` (auch `latitude`/`longitude`, `lng`, Groß- und Kleinschreibung egal, Zahl oder Text) oder einfach `52.52,13.40` enthalten. Die Werte dürfen auch verschachtelt sein, wie beim RUT956 (`{"TIME":{…},"GPS":{"latitude":…,"longitude":…,"fix_status":1}}`). Meldet der Router `fix_status` 0 (kein GPS-Empfang), wird die Position ignoriert und der feste Ort bzw. die letzte Position bleibt.

Gespeicherte Änderungen (Ort, Ein/Aus) lösen sofort eine neue Abfrage aus, nicht erst nach dem Intervall. Klappt die Abfrage nicht, steht der Grund unten auf der Wetterseite (z. B. „Wetter: Fehler -1“) und im seriellen Log mit `[wx]`. Die Abfrage läuft per HTTPS mit Zertifikatsprüfung.

Bei GPS-Position sucht das Display den Ortsnamen über [OpenStreetMap Nominatim](https://nominatim.org) (kostenlos, ohne Konto und ohne Schlüssel) und zeigt ihn mit „(GPS)“ an. Abgefragt wird nur beim ersten Empfang und nach mehr als 5 km Fahrt, damit die Nutzungsregeln von Nominatim (höchstens eine Anfrage pro Sekunde, Anwendungsname im User-Agent) sicher eingehalten werden. Ohne GPS gilt der eingetragene Ortsname. Die Webseite zeigt zusätzlich die Kachel **📍 Standort** mit Ortsname, Koordinaten (Link zur Karte) und Quelle (GPS oder fester Ort).

Die Wetterseite zeigt das aktuelle Wetter mit gefühlter Temperatur, Höchst- und Tiefstwert, Wind mit Richtung und Böen, Luftfeuchte, Regen in der nächsten Stunde und heute sowie die nächsten 3 Tage. Für die Übersicht gibt es die Kachel **Wetter**. Bei Böen über dem Grenzwert und bei Gewitter erscheint eine Warnung (Kopfzeile, Status-Kachel, Pushover). Daten älter als 3 Stunden lösen keine Warnung aus.

Vorbelegen in `config_local.h`: `DEFAULT_WX_LAT`, `DEFAULT_WX_LON`, `DEFAULT_WX_NAME`, `DEFAULT_WX_TOPIC`, `DEFAULT_WX_GUST`.

## Einstellungen (Webseite)

**Aussehen der Webseite (ab 2.11.0):** dunkel und ruhig, Farbe nur für Zustände (grün OK, gelb Hinweis, rot Fehler) und Blau für Bedienung, Symbole als SVG statt Emojis. Am Handy unten die Symbolleiste wie am Panel, ab 1000 px Breite links eine Seitenleiste mit allen Seiten. Home gruppiert die Kacheln der Übersicht nach Tanks, Klima, Energie, Fahrzeug und eigene Kacheln; Warnungen stehen als gelbes Band oben. Die Einstellungen haben links eine Liste aller Bereiche mit Suchfeld und unten eine Leiste „Änderungen nicht gespeichert · Speichern“.

Die Einstellungen sind in Gruppen geteilt, oben umschaltbar (die letzte Wahl merkt sich der Browser):

| Gruppe | Inhalt |
| --- | --- |
| 🖥 Anzeige | Display (Helligkeit, Dimmen, Anzeigename) · Seiten & Symbolleiste · Home am Display · Home auf der Webseite · eigene Seiten & MQTT-Kacheln |
| 📡 Sensoren & Geräte | Sensoren (Zigbee/Bluetooth) · Topics der Geräte (inkl. Heizung/CampMatic) · Geräte-Links · Topic-Finder |
| ⚡ Automationen | Regeln mit eigenem Speichern-Knopf, siehe [Automationen](#automationen) |
| 🔌 Verbindung | WLAN · MQTT-Broker |
| 🌦 Dienste | Wetter · Pushover |
| 🔧 System | Gerätename, Login, Zeit, Firmware-Update, Sichern/Wiederherstellen, Neustart (immer aufgeklappt) |

**Einstellungen speichern** steht immer unten am Bildschirmrand. Sensoren, eigene Seiten & Kacheln und Automationen haben jeweils einen eigenen Speichern-Knopf. In der Sensorliste ist jeder Sensor eine Zeile mit Typ, Name und aktuellem Wert; Antippen klappt ihn zum Bearbeiten auf.

Neue Geräte starten ohne Beispielseite. Die frühere Beispielseite „Zigbee“ (Kacheln auf `zigbee2mqtt/…`) bleibt bei bestehenden Geräten erhalten und kann unter *Eigene Seiten & MQTT-Kacheln* gelöscht werden.

## Sensoren (Zigbee & Bluetooth)

*Einstellungen → 📡 Sensoren & Geräte → Sensoren*. Jeder Sensor hat Name, Funk und Typ (Zigbee-Kontakt, Zigbee-Klima, Bluetooth-Klima) und die Adresse.

**Zigbee** (Gateway, das ZCL-Attribute einzeln sendet, Topic `<Basis>/<Adresse>/1/<Cluster>/<Attribut>`, Basis Standard `camper/zigbee/data`). Der SMLIGHT-Hub sendet `{"data":{"val":…,"type_sm":"report","status":"SUCCESS"}}`; Werte mit `"type_sm":"report"` hat der Hub schon umgerechnet (°C, %, kPa) und werden so übernommen. Nur Rohwerte (`report_raw` oder eine nackte Zahl) laufen über die Teiler:

| Cluster/Attribut | Wert | Anzeige |
| --- | --- | --- |
| `0006/0000` | 0 = zu, 1 = offen (mit „umgekehrt“ andersherum) | Kontakt: zu/offen |
| `0001/0021` | % (report) bzw. 0…200 roh | Batterie in % |
| `0402/0000` | °C (report) bzw. roh | roh ÷ 10 (einstellbar; der ZCL-Standard wäre ÷ 100) |
| `0405/0000` | % (report) bzw. roh | roh ÷ 1 (einstellbar) |
| `0403/0000` | kPa (report) bzw. roh in hPa | hPa |
| `0008/0000` | 1…254 | Licht: Helligkeit |

Textwerte wie `"ON"`/`"OFF"` (so meldet z. B. eine LED-Leiste ihren Zustand) gelten als 1/0.

**Schalter / Steckdosen** (Typ *Zigbee · Schalter / Steckdose*): nur An/Aus über `…/cmd/<IEEE>/1/0006`, Zustand aus `0006/0000`. Ebenfalls volle IEEE-Adresse eintragen.

**Lichter / LED-Leisten** (Typ *Zigbee · Licht*): Auf der Seite *Licht* (und überall, wo angehakt) gibt es je Licht eine Karte mit Schalter, Helligkeit und Farbknöpfen (Warmweiß, Kaltweiß, Rot, Orange, Grün, Blau, Lila), auf der Webseite zusätzlich einen freien Farbwähler. Geschaltet wird über die Befehls-Topics des SMLIGHT-Hubs, Basis = Zigbee-Basis ohne `/data` (also `camper/zigbee/cmd/<IEEE>/1/…`). Dafür muss beim Licht die **16-stellige IEEE-Adresse** eingetragen sein (Short-ID reicht hier nicht):

| Aktion | Topic | Payload |
| --- | --- | --- |
| An/Aus | `…/cmd/<IEEE>/1/0006` | `ON` / `OFF` |
| Helligkeit | `…/cmd/<IEEE>/1/0008/0000` | `1`…`254` |
| Farbe | `…/cmd/<IEEE>/1/0300/0007` | `#rrggbb` |
| Farbtemperatur | `…/cmd/<IEEE>/1/0300/000a` | Mired, z. B. `370` warm, `153` kalt |

Die Farbe meldet der Hub nicht zurück; angezeigt wird die zuletzt hier gewählte. **IN ENTWICKLUNG:** Helligkeit und Farbe sind nach der [SMLIGHT-MQTT-API](https://smlight.tech/support/manuals/books/slzb-os/page/mqtt-api) umgesetzt und noch nicht an der Leiste getestet; An/Aus-Rückmeldung ist aus dem Mitschnitt bestätigt.

Die Adresse darf die IEEE-Adresse (`0x00158d…`) oder die Short-ID (`9c68`) sein, mit oder ohne `0x`, Groß-/Kleinschreibung egal. Wer nicht weiß, welche das Gateway ins Topic schreibt, trägt beide ein (*Zweite Adresse*).

**Bluetooth** über [OpenMQTTGateway](../omg): Topic `<Basis>/<MAC>` (Standard `camper/OMG/BTtoMQTT`), ausgewertet werden `tempc`, `hum`, `pres`, `batt`. Das funktioniert mit allen Thermometern, die OMG entschlüsselt (Govee H5075/H5179, Ruuvi-Tag, Xiaomi LYWSD03MMC, Inkbird …).

- **Gefunden, aber noch nicht eingetragen:** Unten in der Liste stehen Adressen, die gesendet haben, aber unbekannt sind; *+ übernehmen* legt sie an.
- **device.json einlesen:** Liste im Format `{"zigbee_devices":[{"name":"Kueche","shortId":"9c68","ieeeAddr":"0x00158d…","isWeatherSensor":true}],"ble_devices":[{"name":"Govee Wohnen","mac":"A4C138…"}]}` übernimmt alle Geräte auf einmal (danach *Sensoren speichern*).
- **Anzeigen auf:** je Sensor Haken für die Seiten, auf denen er erscheint:
  - **🌡️ Temperatur** (Klima-Sensoren, Standard): Temperaturseite mit Luftfeuchte und Batterie, in der Temperatur-Kachel wählbar, 24-h-Verlauf
  - **💡 Licht** (Lichter, Standard): Seite *Licht* mit einer Karte je Licht, die Home-Kachel *Licht* zeigt, welche an sind
  - **🔌 Schalter** (Typ *Zigbee · Schalter / Steckdose*, Standard; Lichter auf Wunsch): Seite *Schalter* mit An/Aus je Gerät, Home-Kachel *Schalter*
  - **🚪 Sensoren** (Kontakte, Standard; Klima-Sensoren auf Wunsch): Seite *Sensoren* mit allen Fenstern und Türen (offen/zu, Batterie) bzw. Temperatur und Luftfeuchte. Die Home-Kachel *Offene Fenster/Türen* listet die offenen mit Namen, die Status-Kachel zählt sie, z. B. „2 🚪“
  - **🔋 Batterie:** der Ladestand des Sensors steht auf der Batterieseite unter *Sensor-Batterien*
  - **⚡ Energie / 📦 Extra:** die beiden freien Seiten; jeder Sensortyp kann dort erscheinen
  - **🌦 Wetter (Außen):** der Sensor ist das Außenthermometer (z. B. ein Ruuvi-Tag draußen). Die gemessene Temperatur und Luftfeuchte stehen auf der Wetterseite unter der Vorhersage-Temperatur und unten in der Wetter-Kachel
- Die Haken heißen so, wie du die Seiten benannt hast, und tragen ihr Symbol. Ist eine Seite ausgeschaltet, steht „(Seite aus)“ dahinter.
- Seiten wie Sensoren, Licht, Schalter, Energie und Extra sind gleich aufgebaut: Lichter und Schalter oben als Karten zum Bedienen, Kontakte und Klima-Sensoren darunter als Zeilen mit Wert.
- Kontakte, die auf keiner dieser Seiten stehen, erscheinen nur als Symbol in der Status-Kachel, solange sie offen sind.
- Für Automationen mit einem Zigbee-Kontakt (SMLIGHT): *Wenn* Topic `camper/zigbee/data/<Adresse>/1/0006/0000`, Schlüssel `data.val`, = `1`.
- Licht per Automation schalten (z. B. Eingangslicht): *Dann senden* an `camper/zigbee/cmd/<IEEE>/1/0006`, Payload `ON` bzw. `OFF`. Die Vorlage *Eingangslicht* trägt die IEEE des ersten angelegten Lichts schon ein, sofern die Sensorliste in dieser Sitzung geöffnet war.

## Heizung über CampMatic

Statt der eigenen Firmware ([heater-node](../heater)) kann das Display auch eine **CampMatic-Box** steuern: *Einstellungen → Topics der Geräte → Heizung: Steuerung über* auf **CampMatic-Box** stellen und als Basis-Topic `campmatic/<Gerätenummer>` eintragen (dreistellige Nummer aus der CampMatic-App, z. B. `campmatic/003`).

Die Box redet mit dem Broker von CampMatic (`campmatic.de:8883`). Damit ihre Werte beim Display ankommen, braucht der Broker, an dem das Display hängt, eine **MQTT-Bridge** dorthin – beim Mosquitto-Add-on von Home Assistant mit der Vorlage von CampMatic, sinngemäß:

```
connection campmatic-<GERAETE_ID>
address campmatic.de:8883
bridge_capath /etc/ssl/certs
remote_username <MQTT_USER>
remote_password <MQTT_PASSWORT>
remote_clientid display-bridge-<GERAETE_ID>
topic # both 0 campmatic/<GERAETE_ID>/ campmatic/<GERAETE_ID>/
```

Zugangsdaten stehen in der CampMatic-App auf der Status-Seite; sie gehören nur auf den Broker, nie ins Repo. Die Client-ID muss sich von der der Box und einer Home-Assistant-Bridge unterscheiden.

| Display | CampMatic-Topic (unter `campmatic/<Nr>/`) |
| --- | --- |
| online/offline | `status` |
| Heizung an/aus | `climate/truma_heizung/mode/state` · Befehl: aus = `mode/command` `off`, an = Solltemperatur senden |
| Solltemperatur | `climate/truma_heizung/target_temperature/state` / `…/command` (`nan` = aus) |
| Warmwasser Aus/Eco/High | `climate/truma_wasser/mode/state` + `target_temperature` (Eco = 40 °C, High = 60 °C) |
| Raumtemperatur, Wassertemperatur | `climate/truma_heizung/current_temperature/state`, `climate/truma_wasser/current_temperature/state` |
| Gebläse | `climate/truma_heizung/fan_mode/state` / `…/command` |

Einschalten schickt nur die Solltemperatur (die zuletzt gesehene, sonst 20 °C): ein zusätzlicher Einschaltbefehl würde den Sollwert der Box auf den Mindestwert zurücksetzen. Freibrennen und Timer gibt es über die Box nicht. **IN ENTWICKLUNG:** Die Topics für Modus, Solltemperatur und Warmwasser stammen aus dem Home-Assistant-Paket von CampMatic; Raum-/Wassertemperatur und Gebläse folgen dem üblichen ESPHome-Schema und sind noch nicht an einer echten Box geprüft.

## Automationen

Webseite → *Einstellungen* → **⚡ Automationen**. Jede Regel hat:

| Teil | Felder | Beispiel Eingangslicht |
| --- | --- | --- |
| Wenn | Topic, JSON-Schlüssel, Bedingung (= ≠ < >), Wert | `camper/door`, `Door.state`, =, `open` |
| Dann senden | Befehls-Topic und Payload, sofort | `camper/zigbee/led_eingang/set`, `{"state":"ON"}` |
| Wenn nicht mehr erfüllt | Payload und Verzögerung in Sekunden | `{"state":"OFF"}` nach 10 s |
| Zeitraum | immer, von–bis (auch über Mitternacht) oder nur wenn dunkel | nur wenn dunkel |
| Anzeige | Symbol in der Status-Kachel solange erfüllt, optional als Warnung (Pushover) | 🚪 |

- Eine Regel reagiert nur auf **Wechsel**. Der erste empfangene Wert nach dem Start (z. B. retained) löst nichts aus.
- **Von Hand schalten geht immer.** Mit *Nur ausschalten, was diese Regel eingeschaltet hat* (Standard) bleibt ein Licht, das schon an war, an. Das Display liest dazu den Zustand der Lampe auf dem Befehls-Topic ohne `/set` mit (Zigbee2MQTT: `state`).
- Der Zeitraum gilt nur fürs Einschalten; ausgeschaltet wird immer.
- „Nur wenn dunkel“ nutzt Sonnenauf- und -untergang aus dem Wetter (Open-Meteo); ohne Wetterdaten gilt 18 bis 7 Uhr.
- Mehrere Lampen: Regel mit ⧉ kopieren und nur das Befehls-Topic ändern (z. B. später die Markisenbeleuchtung).
- Bis zu 16 Regeln, gespeichert im Display (auch in der Sicherung enthalten). Der Kasten über jeder Regel zeigt live, ob sie erfüllt ist und was sie zuletzt getan hat.
- Nur ein Symbol ohne Aktion (z. B. 🚪 für einen Fensterkontakt): Befehls-Topic leer lassen.

## Router-Daten (RUT956)

Der RUT956 kann GPS und Mobilfunkwerte selbst per MQTT senden, ganz ohne zusätzliche Firmware. Im Router unter **Services → Data to Server**:

1. Neue Instanz, **Server type: MQTT**, Server `127.0.0.1` (der Broker läuft auf dem Router), Port `1883`, ggf. Benutzer/Passwort.
2. Topic `camper/rut`, Format **Json**, Timer **Period** z. B. 10–60 s (kürzer = Abfahrtscheck reagiert schneller).
3. Datensammlung **Type: GPS** (Breite, Länge, Höhe, Geschwindigkeit in km/h, Genauigkeit, Satelliten, `fix_status`). Der Router packt es als `{"TIME":…,"GPS":{…}}`. Eine zweite Instanz mit **Type: GSM** und Topic `camper/router/mobile` liefert Signal (RSSI, RSRP, SINR), Netzbetreiber und Modemtemperatur.
4. Für die Tür eine Instanz mit dem Digitaleingang (z. B. `din2`, eigener Name „Door“) und Topic `camper/door`: `{"Door":{"name":"din2","type":"Digital In","state":"open"|"close","custom_name":"Door"}}`.

`camper/rut` und `camper/door` nutzt der [Abfahrtscheck](#warnungen) ab Werk. Das GPS-Topic kann man zusätzlich unter *Einstellungen → 🌦 Wetter → GPS per MQTT* eintragen, dann folgt das Wetter dem Fahrzeug. Alle Topics: [docs/TOPICS.md](../../docs/TOPICS.md).

Das GSM-Topic ist am Display unter *Einstellungen → 🌦 Wetter → Mobilfunk-Signal per MQTT* eingetragen (Vorgabe `camper/router/mobile`). Daraus zeigt die Kopfzeile links neben dem Datum fünf Signalbalken mit dem Netz („LTE“, „5G“ …). Gezählt wird nach RSRP (≥ −80 dBm = 5 Balken, je 10 dB weniger einer weniger), ohne RSRP nach RSSI; die Schlüssel werden automatisch gesucht (`rsrp`, `rssi`, `signal`, `conntype`, `network_type` …). Kommt 5 Minuten nichts vom Router oder ist das Feld leer, zeigen die Balken die WLAN-Stärke des Displays mit WLAN-Symbol.

Am Display dann im **Topic-Finder** `camper/router/#` starten und die gewünschten Werte per Klick als Kacheln anlegen. Die genauen JSON-Schlüssel hängen von der Router-Firmware ab; der Finder zeigt sie an.

## Sichern, Update, Verlauf

**Einstellungen sichern:** *Einstellungen → 🔧 System → ⬇ Sichern* lädt eine JSON-Datei mit allen Einstellungen, Seiten und Kacheln herunter. Passwörter und Tokens (WLAN, MQTT, Web, Setup-WLAN, Pushover) sind nicht enthalten. *⬆ Einspielen* übernimmt die Datei; vorhandene Passwörter bleiben. WLAN, feste IP und Gerätename werden nur übernommen, wenn der Haken dafür gesetzt ist, damit ein zweites Display nicht dieselbe Adresse bekommt.

**Firmware-Update:** *🔧 System → Firmware-Update (.bin)*, Datei wählen, *Hochladen*. Die Webseite zeigt einen Fortschrittsbalken, das Display einen eigenen Update-Bildschirm mit Prozentanzeige. Während in den Flash geschrieben wird, kann das Bild flackern oder kurz verrutschen: Der Bildspeicher liegt im PSRAM, und der ist beim Schreiben in den Flash kurz blockiert. Das ist harmlos und nach dem Neustart vorbei.

**Sicheres Update, Ereignisse und Rückfall:** Seit 2.10.0 hat jede Firmware eine Kennung (`CAMPER-FW:display:<version>:<chip>;`) und dieselbe Absicherung wie alle VanNode-Geräte (`fwcheck.*`, `evlog.*`, `safeguard.*` aus `firmware/_common`):

- **Prüfung beim Update** (Webseite unter *Einstellungen → 🔧 System → Firmware-Update*): Die installierte Version steht dabei. Eine gewählte Datei wird schon im Browser und beim Hochladen im Gerät noch einmal geprüft, bevor etwas aktiviert wird. Abgelehnt werden eine `.merged.bin` (komplettes Flash-Abbild für USB), Firmware für ein anderes Gerät oder einen anderen Chip und zu große Dateien. Eine Datei ohne Kennung (Version vor 2.10.0) geht nur mit „Ohne Kennung hochladen“. Fehler stehen im Klartext da statt „Update failed“.
- **Ereignisse:** Die letzten Ereignisse (Start mit Grund, WLAN und MQTT verbunden/getrennt, Uploads mit Ergebnis, Rückfall, gespeicherte Einstellungen) stehen in der Web-Oberfläche. Sie bleiben bei Neustart, Absturz und Update erhalten, nach einem Stromausfall ist das Log leer.
- **Rückfall nach Update:** Hat eine neue Firmware nach 5 Minuten kein WLAN oder startet sie mehr als dreimal neu, startet wieder die vorherige. Kam das Update über den Setup-AP (ohne WLAN), wird nur auf Neustart-Schleifen geachtet.
- **WLAN-Änderung mit Rückweg:** Werden die WLAN-Daten geändert, während das Gerät verbunden ist, merkt es sich die funktionierenden. Klappt die Verbindung mit den neuen nach dem Neustart etwa 1 Minute lang nicht, kommen die alten zurück.
- Die Ereignisse stehen auf der Webseite unter *System* unter der Geräteliste.

**Verlauf:** Alle 5 Minuten merkt sich das Display jeden Temperatursensor und jede Batterie (Ladestand, beim BM2 die Spannung), 24 Stunden lang. Die Seiten *Temperatur* und *Batterie* der Webseite zeigen daraus Kurven. Der Verlauf liegt nur im Arbeitsspeicher: Nach einem Neustart oder Stromausfall beginnt er neu. Schrittweite und Länge: `HISTORY_STEP_S`, `HISTORY_POINTS` in `config.h`.

## Fertige Firmware

Wird im Haupt-Repo per GitHub Actions gebaut, siehe [Fertige Firmware](../../README.md#fertige-firmware).

## Hinweise

- **Speicher:** LVGL legt alle Bildschirm-Objekte im PSRAM an (`lv_mem_psram.cpp`, in `lv_conf.h` `LV_USE_STDLIB_MALLOC = LV_STDLIB_CUSTOM`). Der interne RAM bleibt so für WLAN und verschlüsselte Verbindungen (Wetter, Pushover) frei; diese brauchen rund 40–50 kB am Stück. Die Zeile *Speicher* auf der Systemseite zeigt den freien internen RAM zuerst – liegt er unter etwa 50 kB, schlagen Wetterabfragen mit „Fehler -1“ fehl.

- Der MaxxFan meldet keine Drehzahl zurück. Die Lüfterseite zeigt deshalb nur Online-Status und Auto-Hold; die Stufe wird gesetzt, nicht gelesen.
- PubSubClient verwirft Nachrichten über 4 KB (`MQTT_BUFFER_SIZE`). Große Zigbee-Geräte-JSONs bitte in Zigbee2MQTT nicht unnötig aufblähen.
- Bubble-Richtung: Neigt sich der Punkt falsch herum, im Levelsensor die Montagerichtung prüfen.
- Lizenz: MIT. Schriften: Montserrat (OFL) und Font Awesome 5 Free (OFL), wie in LVGL enthalten.
