hflocki/camper-mqtt/firmware/tanklevel/README.md

# Tanklevel Node – Frischwasser, Grauwasser + Gas auf einem ESP32

Eine Firmware für **einen** ESP32-C3 (oder klassischen ESP32), die zwei Projekte zusammenfasst und um Grauwasser erweitert:

- **Frischwasser** aus [camper-waterlevel](https://github.com/hflocki/camper-waterlevel): Votronic-Tankgeber am analogen Eingang, Volt-zu-Füllstand-Matrix, Glättungsfilter
- **Grauwasser** (optional): zweiter Votronic-Geber, wahlweise Tankelektrode (wie Frischwasser) oder kapazitiver Tank-Sensor FL, mit eigener Tankgröße, Matrix und Filter
- **Gas** aus [camper-gaslevel](https://github.com/hflocki/camper-gaslevel): BLE-Gassensor (Standard: Rotarex DIMES / SRG WAVE), passiv über Bluetooth-Advertising, Füllstopp-Berechnung. Alternativ **Mopeka Pro** (Pro Check, Pro Check Universal, Pro Plus …) oder **Mopeka Standard** (Std Check), umschaltbar im Tab Gas

Alle Werte gehen per **MQTT** (mit Home-Assistant-Discovery) raus und sind in einer gemeinsamen **Web-Oberfläche** zu sehen und einzustellen. Jeder Sensor lässt sich einzeln ein- und ausschalten.

## Web-Oberfläche

**Live**

| Wasser + Gas (Standard) | Wasser + Grau + Gas |
| --- | --- |
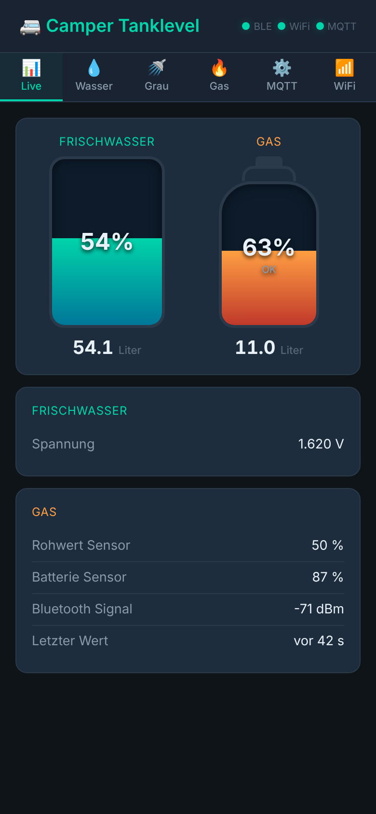
[picture p7: firmware/tanklevel/images/tab-live.png]
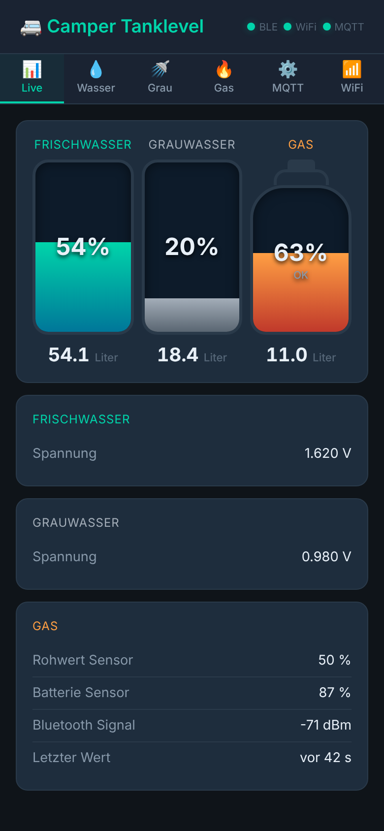
[picture p8: firmware/tanklevel/images/tab-live-all.png]
|  |  |

| Nur Wasser | Nur Gas |
| --- | --- |
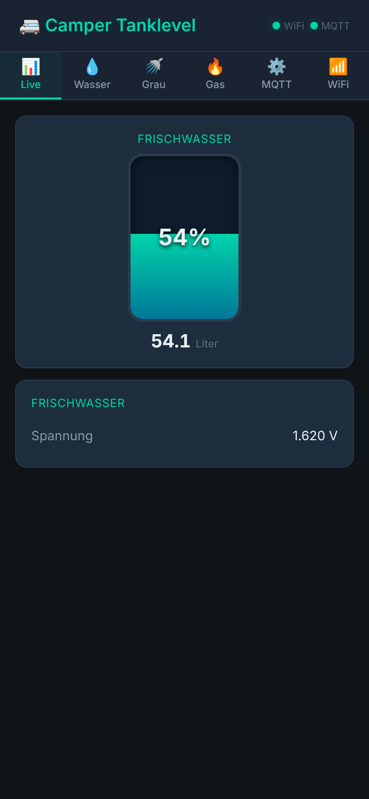
[picture p9: firmware/tanklevel/images/tab-live-water-only.png]
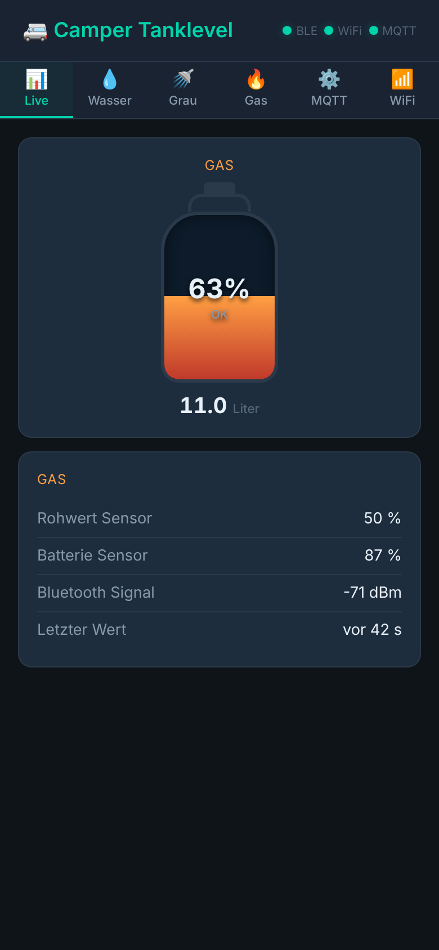
[picture p10: firmware/tanklevel/images/tab-live-gas-only.png]
|  |  |

**Einstellungen**

| Wasser | Gas |
| --- | --- |
|  |  |

| Grau: Tankelektrode | Grau: Tank-Sensor FL |
| --- | --- |
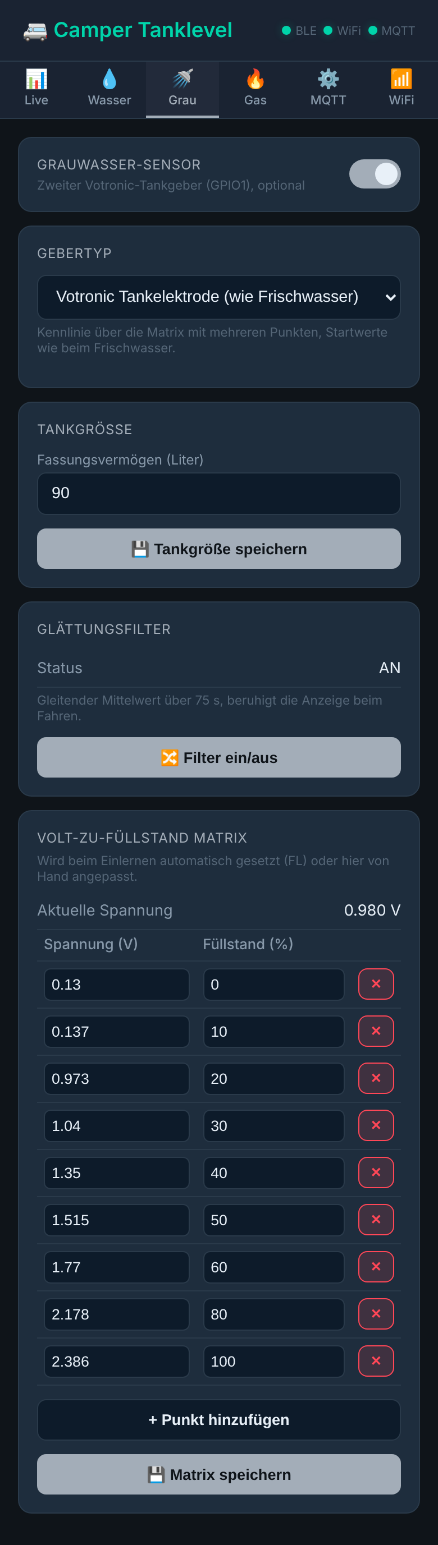
[picture p11: firmware/tanklevel/images/tab-grey.png]
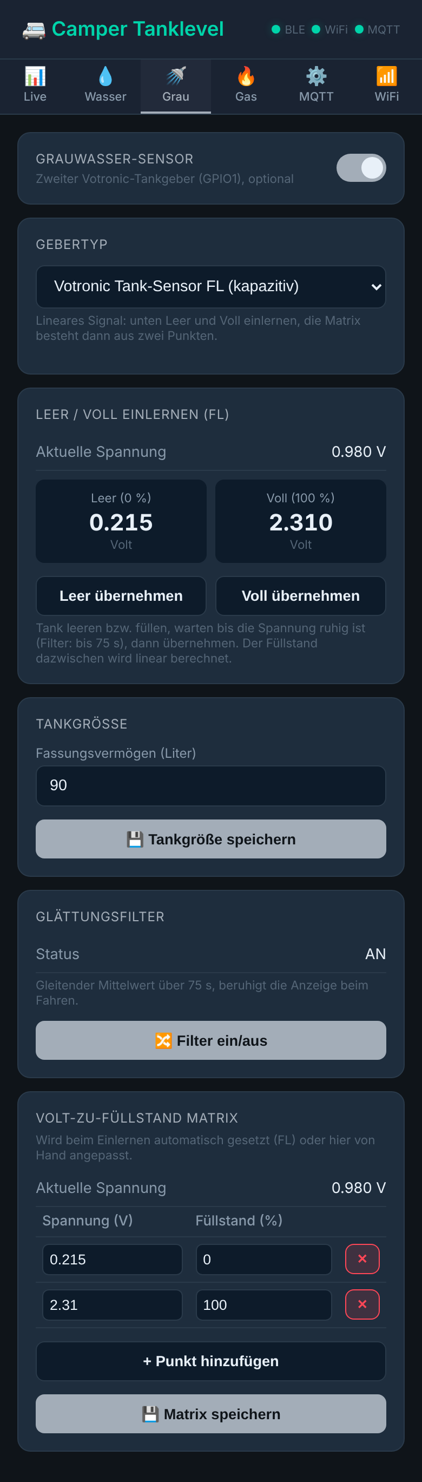
[picture p12: firmware/tanklevel/images/tab-grey-fl.png]
|  |  |

| MQTT | WiFi |
| --- | --- |
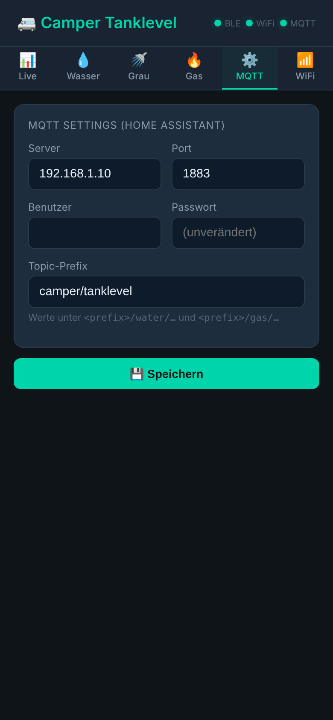
[picture p13: firmware/tanklevel/images/tab-mqtt.png]
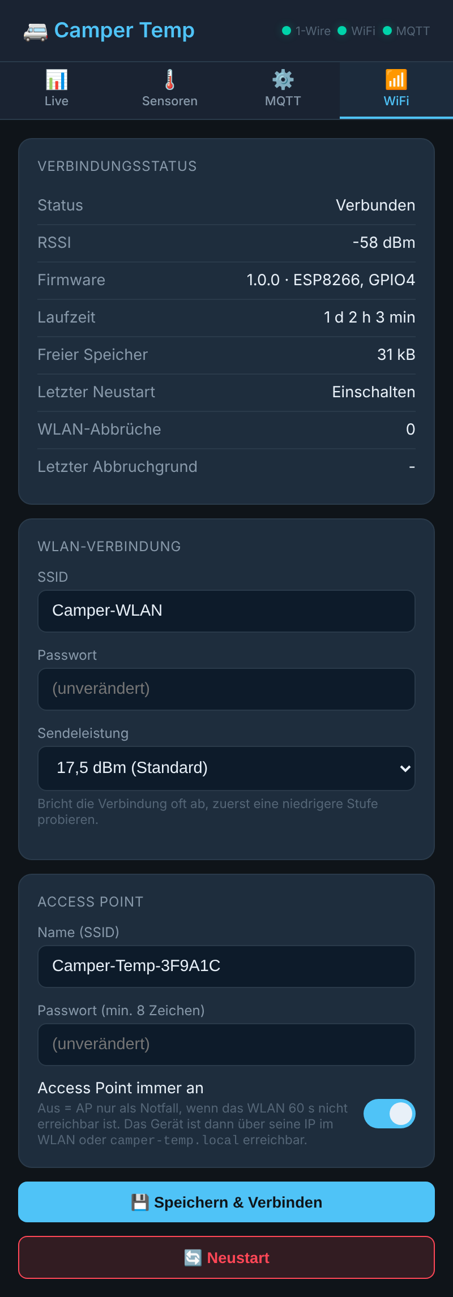
[picture p14: firmware/temp/images/tab-wifi.png]
|  |  |

Die Bilder zeigen Beispieldaten.

## Ordner

```
camper_tanklevel/        Sketch für die Arduino IDE (.ino + .cpp/.h)
camper_tanklevel/web/    Quelle der Web-Oberfläche (index.html)
camper_tanklevel/data/   LittleFS-Inhalt: index.html.gz (komprimiert, wird hochgeladen)
```

| Datei | Inhalt |
| --- | --- |
| `config.h` | Pins, Standardwerte, **GAS SENSOR DEFINITION** (Byte-Zuordnung) |
| `water_sensor.cpp` | ADC für Frisch- und Grauwasser, gleitender Mittelwert, Interpolation über die Matrix |
| `gas_sensor.cpp` | NimBLE-Scan, Dekodierung, Geräteliste, Füllstopp |
| `mqtt_ha.cpp` | MQTT, HA-Discovery, Filter-Schalter |
| `webserver.cpp` | Web-UI (gzip), REST-API, Konfiguration in LittleFS |
| `wifi_manager.cpp` | WLAN mit AP-Fallback (Modem-Sleep für WiFi/BLE-Koexistenz) |
| `fwcheck.*`, `evlog.*` | Prüfung beim Firmware-Upload, Ereignis-Log (Kopien aus `firmware/_common`) |
| `safeguard.*` | Rückfall nach Update, WLAN-Änderung mit Rückweg (Kopie aus `firmware/_common`) |

## Hardware

- ESP32-C3 Super Mini (Standard), ESP32-S3 oder klassischer ESP32 – die Pins werden je nach Chip automatisch gewählt

| Sensor | ESP32-C3 | ESP32-S3 | Klassischer ESP32 | `config.h` |
| --- | --- | --- | --- | --- |
| Frischwasser (Votronic-Tankgeber) | **GPIO0** | **GPIO1** | GPIO34 | `ADC_PIN` |
| Grauwasser (Votronic-Tankgeber, optional) | **GPIO1** | **GPIO2** | GPIO35 | `GREY_ADC_PIN` |
| Gas (BLE) | keine Verkabelung, eingebautes Bluetooth | | | |

Beide Tankeingänge müssen ADC1-Pins sein (ADC2 funktioniert nicht, solange WLAN aktiv ist). GPIO2 beim C3 nicht verwenden, das ist ein Boot-Pin. Beim S3 ist GPIO0 ein Boot-Pin ohne ADC, deshalb dort GPIO1/GPIO2. Verkabelung der Tankgeber wie im [camper-waterlevel](https://github.com/hflocki/camper-waterlevel#verkabelung) beschrieben, der Grauwasser-Geber bekommt eine eigene, gleich aufgebaute Messschaltung.

**Grauwasser-Geber** – im Tab **Grau** unter „Gebertyp“ wählbar (Werkseinstellung in `config.h`: `GREY_SENSOR_TYPE`):

| Gebertyp | Kalibrierung |
| --- | --- |
| Votronic Tankelektrode (wie Frischwasser) | Matrix mit mehreren Punkten, Startwerte wie beim Frischwasser |
| Votronic Tank-Sensor FL (kapazitiv) | Lineares Signal: bei leerem Tank „Leer übernehmen“, bei vollem Tank „Voll übernehmen“ |

Für Abwasser ist der kapazitive FL die robustere Wahl, weil sich Ablagerungen kaum auf den Messwert auswirken. Beim Wechsel des Gebertyps wird die Grauwasser-Matrix auf die Startwerte des Typs zurückgesetzt. Vor dem Anschluss mit dem Multimeter die Signalspannung bei leerem und vollem Tank prüfen: Liegt sie über ca. 2,5 V, ist ein Spannungsteiler nötig. Bei langer Leitung zum Tank hilft ein abgeschirmtes Kabel, der Glättungsfilter beruhigt den Wert zusätzlich.

## Arduino IDE

> **Eigene Passwörter, WLAN und Broker:** `config_local.h.example` im Sketch-Ordner nach `config_local.h` kopieren und anpassen. Die Datei geht nicht nach GitHub. Details in der [Haupt-README](../../README.md#eigene-einstellungen-config_localh).

**Board-Einstellungen**

| Einstellung | Wert |
| --- | --- |
| Board | ESP32C3 Dev Module |
| USB CDC On Boot | Enabled |
| Flash Size | 4MB |
| Partition Scheme | ⚠️ **Minimal SPIFFS (1.9MB APP with OTA/190KB SPIFFS)** |

WiFi + Bluetooth ergeben ca. 1,43 MB Firmware und passen nicht in die Standard-Partition (1,2 MB).

**ESP32-S3:** Board „ESP32S3 Dev Module“, Partition Scheme ebenfalls Minimal SPIFFS (oder eine größere Variante mit SPIFFS). **PSRAM** passend zum Board einstellen (z. B. N16R8 → „OPI PSRAM“), eine falsche Einstellung führt zu Abstürzen. „USB CDC On Boot“ nur aktivieren, wenn der Serial Monitor über den nativen USB-Port läuft.

**Libraries** (Bibliotheksverwalter)

| Library | Autor | getestet |
| --- | --- | --- |
| PubSubClient | Nick O'Leary | 2.8 |
| ArduinoJson | Benoit Blanchon | 7.4.2 |
| ESP Async WebServer | ESP32Async | 3.12.1 |
| Async TCP | ESP32Async | 3.5.0 |
| NimBLE-Arduino | h2zero | 2.5.1 |

Board-Paket: esp32 von Espressif, 3.x (getestet 3.3.9).

**LittleFS-Plugin installieren (einmalig)**

Die Arduino IDE 2.x kann von sich aus kein Dateisystem hochladen. Dafür braucht es das Plugin [arduino-littlefs-upload](https://github.com/earlephilhower/arduino-littlefs-upload) (Arduino IDE **2.2.1 oder neuer**, für die alte IDE 1.8 funktioniert es nicht).

1. Unter [Releases](https://github.com/earlephilhower/arduino-littlefs-upload/releases/tag/1.6.3) die Datei `arduino-littlefs-upload-x.y.z.vsix` herunterladen. **Nicht entpacken**, die `.vsix` bleibt so, wie sie ist.
2. In den Plugin-Ordner kopieren (Ordner vorher anlegen, falls es ihn nicht gibt):

   | System | Ordner |
   | --- | --- |
   | macOS / Linux | `~/.arduinoIDE/plugins/` |
   | Windows | `C:\Users\<Benutzername>\.arduinoIDE\plugins\` |

   Auf dem Mac im Terminal:
   ```bash
   mkdir -p ~/.arduinoIDE/plugins
   mv ~/Downloads/arduino-littlefs-upload-*.vsix ~/.arduinoIDE/plugins/
   ```
   Der Ordner beginnt mit einem Punkt und ist im Finder versteckt (`Cmd+Shift+.` blendet ihn ein).
3. Arduino IDE **komplett beenden** und neu starten. Danach taucht unter `Cmd+Shift+P` (Windows/Linux `Strg+Shift+P`) der Befehl **Upload LittleFS to Pico/ESP8266/ESP32** auf.

**Flashen**

1. In `config.h` `DEFAULT_OTA_PASSWORD` und `DEFAULT_AP_PASSWORD` ändern.
2. `camper_tanklevel.ino` öffnen. Der Ordner muss `camper_tanklevel` heißen, sonst will die IDE den Sketch verschieben.
3. Board-Einstellungen prüfen, vor allem **Partition Scheme: Minimal SPIFFS**. Port wählen.
4. Sketch hochladen.
5. **Serial Monitor schließen** (sonst ist der Port belegt).
6. `Cmd+Shift+P` → **Upload LittleFS to Pico/ESP8266/ESP32**.
7. ESP neu starten, Access Point `Tanklevel-Node-XXXXXX` erscheint.

Der LittleFS-Upload überschreibt die gespeicherte Konfiguration (WLAN, MQTT, Matrix). Nach einem reinen Firmware-Update ist er nicht nötig, nur wenn sich die Web-Oberfläche geändert hat.

**Web-Oberfläche ändern:** Die Quelle ist `web/index.html`. Hochgeladen wird die komprimierte `data/index.html.gz` (ca. ein Viertel der Größe, lädt auf dem Handy deutlich schneller). Nach einer Änderung neu packen, dann LittleFS hochladen:

```
python3 tools/web/pack_web.py tanklevel      # im Repo-Hauptordner
```

Ohne das Repo-Werkzeug geht es auch so (im Sketch-Ordner `camper_tanklevel`): `gzip -9 -n -c web/index.html > data/index.html.gz`. Die GitHub Action prüft bei jedem Push, ob die gepackte Seite zur `index.html` passt.

Spätere Firmware-Updates gehen auch per OTA (`tanklevel-node` unter Netzwerk-Ports) oder über die Web-Oberfläche.

## Erstbenutzung

1. Beim ersten Start läuft nur der Access Point **`Tanklevel-Node-XXXXXX`** (Passwort aus `config.h`). `XXXXXX` sind die letzten 6 Stellen der WLAN-MAC des ESP, so lassen sich mehrere Geräte auseinanderhalten. Der Name ist im Tab WiFi änderbar.
2. Verbinden und `http://192.168.4.1` öffnen.
3. Tab **WiFi**: WLAN eintragen → Neustart.
4. Tab **MQTT**: Broker eintragen → Neustart.
5. Tab **Gas**: Sensor aus der Liste „Bluetooth-Geräte in der Nähe“ übernehmen, Flaschengröße und Füllstopp einstellen.
6. Tab **Wasser**: Tankgröße und ggf. Matrix anpassen (Standard: Votronic-Referenzwerte).
7. Optional Tab **Grau**: Grauwasser-Sensor einschalten (Neustart), Gebertyp wählen, Tankgröße einstellen und kalibrieren (Matrix bzw. Leer/Voll einlernen).

## Probleme beim Hochladen

**Firmware-Upload**

| Problem | Lösung |
| --- | --- |
| `Failed to connect to ESP32-C3` / `No serial data received` | ESP in den Flash-Modus bringen: **BOOT** gedrückt halten, kurz **RESET** drücken, BOOT loslassen, nochmal hochladen. |
| Kein Port in der IDE | Anderes USB-Kabel probieren, viele Kabel laden nur und übertragen keine Daten. Der C3 Super Mini braucht keinen Treiber, er meldet sich direkt per USB (Mac: `/dev/cu.usbmodem…`). |
| Port verschwindet nach dem Upload / anderer Port | Normal beim C3: der ESP startet neu und meldet sich neu am USB an. Port unter *Werkzeuge → Port* neu wählen. |
| `Sketch too big` / `text section exceeds available space` | Partition Scheme steht noch auf Default. **Minimal SPIFFS (1.9MB APP with OTA/190KB SPIFFS)** wählen. |
| Keine Ausgabe im Serial Monitor | *USB CDC On Boot* auf **Enabled**, 115200 Baud. Nach dem Ändern neu hochladen. |
| Kompilierfehler in `AsyncWebServer`/`AsyncTCP` | Falsche Library. Es muss die Version von **ESP32Async** sein (nicht die alte von me-no-dev). Alte Version im Bibliotheksverwalter entfernen. |
| Kompilierfehler mit `NimBLE`, z. B. `setScanCallbacks` | NimBLE-Arduino **1.x** installiert, nötig ist **2.x**. |
| Kompilierfehler mit `JsonDocument` | ArduinoJson **6.x** installiert, nötig ist **7.x**. |
| Viele Fehler in WiFi/ESP-Funktionen | Board-Paket esp32 **2.x** installiert, nötig ist **3.x**. |

**LittleFS-Upload (Web-Oberfläche)**

| Problem | Lösung |
| --- | --- |
| Befehl „Upload LittleFS…“ fehlt | Plugin liegt im falschen Ordner, ist entpackt, oder die IDE wurde nicht komplett neu gestartet. Siehe Installation oben. Arduino IDE 1.8 wird nicht unterstützt. |
| `Could not open <port>, the port doesn't exist` | Serial Monitor ist noch offen, schließen. Oder der Port hat sich nach dem Sketch-Upload geändert, neu wählen. |
| Upload läuft, bricht aber ab / falsches Board | Bekannter Fehler der IDE beim zuerst geöffneten Sketch: Board einmal auf irgendetwas anderes umstellen und wieder zurück, dann erneut versuchen. |
| Web-Seite zeigt nur „Please upload the LittleFS image“ | LittleFS wurde nicht hochgeladen, oder das Partition Scheme wurde nach dem LittleFS-Upload geändert. Mit **Minimal SPIFFS** Sketch und LittleFS beide nochmal hochladen. |
| Alte Web-Oberfläche nach Änderung | `web/index.html` geändert, aber nicht neu gepackt. `gzip`-Befehl oben ausführen, dann LittleFS hochladen. |

**Ohne Plugin:** Im Plugin gibt es auch **Build LittleFS image in sketch directory**, das erzeugt `mklittlefs.bin`. Die Datei lässt sich mit [esptool](https://github.com/espressif/esptool) direkt schreiben (`pip install esptool`):

```bash
esptool --chip esp32c3 --port /dev/cu.usbmodemXXXX write-flash 0x3D0000 mklittlefs.bin
```

`0x3D0000` ist die Startadresse des Dateisystems im Partition Scheme *Minimal SPIFFS*.

**Update per WLAN (OTA)**

| Problem | Lösung |
| --- | --- |
| Netzwerk-Port `tanklevel-node` erscheint nicht | Rechner und ESP müssen im selben Netz sein. mDNS wird manchmal von Routern oder Gastnetzen blockiert. Unter macOS beim ersten Mal die Firewall-Abfrage für die Arduino IDE erlauben. |
| Passwortabfrage schlägt fehl | Es gilt `DEFAULT_OTA_PASSWORD` aus `config.h` in der Firmware, die **gerade auf dem ESP läuft**. |
| LittleFS per WLAN | Geht mit dem Arduino-Plugin nicht. Die Web-Oberfläche (`data/index.html.gz`) lässt sich aber im Web-UI unter **WiFi → Firmware- & Web-Update** hochladen. |

## MQTT / Home Assistant

Prefix (Web-UI) Standard `camper/tanklevel`:

| Topic | Wert |
| --- | --- |
| `<prefix>/status` | `online` / `offline` (Last Will) |
| `<prefix>/info` | Diagnose (retained, beim Verbinden und jede Minute): JSON mit `version`, `ip`, `mac`, `rssi`, `uptime` (s), `reset` (Grund des letzten Neustarts), `heap` |
| `<prefix>/rssi` | WLAN-Signal |
| `<prefix>/water/liters`, `percent`, `voltage` | Frischwasser |
| `<prefix>/water/filter_active` | `ON` / `OFF` |
| `<prefix>/cmd/water/filter/set` | `ON` / `OFF` / `TOGGLE` |
| `<prefix>/grey/liters`, `percent`, `voltage` | Grauwasser (nur wenn eingeschaltet) |
| `<prefix>/grey/filter_active` | `ON` / `OFF` |
| `<prefix>/cmd/grey/filter/set` | `ON` / `OFF` / `TOGGLE` |
| `<prefix>/gas/level`, `raw_level`, `content` | Gas (nur nach erstem gültigen Wert) |
| `<prefix>/gas/battery`, `ble_rssi`, `ble_state` | Gassensor |
| `<prefix>/gas/distance`, `temperature`, `quality` | nur Mopeka: Füllhöhe in mm, Sensortemperatur in °C, Messqualität 0–3 |

In Home Assistant erscheint **ein** Gerät „Tanklevel Node“ mit allen Entitäten.

**Umstieg von den Einzelprojekten:** Die alten Geräte „Camper Wasserlevel Sensor“ und „Camper Gaslevel Sensor“ bleiben in HA stehen, weil ihre Discovery-Nachrichten retained sind. Zum Entfernen in HA unter *Einstellungen → Geräte* löschen oder die Topics `homeassistant/sensor/camper_water/#`, `homeassistant/switch/camper_water/#` und `homeassistant/sensor/camper_gaslevel/#` mit leerer Nachricht (retained) überschreiben.

## WLAN-Probleme

Im Tab **WiFi** stehen Laufzeit, Grund des letzten Neustarts und die Zahl der WLAN-Abbrüche mit dem letzten Abbruchgrund. Damit lässt sich unterscheiden:

| Anzeige | Bedeutung | Abhilfe |
| --- | --- | --- |
| Laufzeit springt zurück, Neustart „Brownout“ | Spannung bricht beim Senden ein | Besseres Netzteil, kürzere Leitung, Kondensator an 3,3 V |
| Neustart „Absturz“ / „Watchdog“ | Firmware stürzt ab | Serial Monitor mitlaufen lassen; beim S3 PSRAM-Einstellung prüfen |
| Abbrüche mit `BEACON_TIMEOUT` | Signal zu schwach oder gestört | Sendeleistung senken (8,5 dBm), Abstand zum Router, AP nur als Notfall |
| Abbrüche mit `NO_AP_FOUND` | Router nicht sichtbar / Kanal gewechselt | Router-Kanal fest einstellen, Mesh/Band-Steering prüfen |
| Abbrüche mit `AUTH_EXPIRE`, `4WAY_HANDSHAKE_TIMEOUT` | Anmeldung scheitert | Passwort prüfen, WPA2 statt WPA3 |

**Sendeleistung** (Standard 17,5 dBm) und **Access Point immer an** (Standard an) sind im Tab WiFi einstellbar. Mit „AP nur als Notfall“ bleibt der eigene Access Point aus, solange das WLAN steht. Erst nach 60 s ohne WLAN geht er an. Das Gerät ist dann über seine IP oder `http://tanklevel-node.local` erreichbar.

## Sensoren ein- und ausschalten

Frischwasser und Gas sind standardmäßig an, Grauwasser ist aus. Jede Kombination ist möglich:

- **In `config.h`** (Werkseinstellung beim ersten Start):
  ```cpp
  #define WATER_ENABLED         1      // 1 = on, 0 = off
  #define GREY_ENABLED          0      // 1 = on, 0 = off
  #define GAS_ENABLED           1      // 1 = on, 0 = off
  ```
- **In der Web-UI:** oben im Tab **Wasser**, **Grau** bzw. **Gas** gibt es einen Schalter. Danach startet das Gerät neu.

Ein ausgeschalteter Sensor verschwindet von der Live-Seite und aus Home Assistant (die Entitäten werden per MQTT entfernt). Ist Gas aus, wird Bluetooth gar nicht gestartet.

## Mopeka-Sensoren

Im Tab **Gas** unter **Sensortyp** das passende Modell wählen und speichern:

| Sensortyp | Modelle | Hersteller-ID in der Geräteliste |
|---|---|---|
| Mopeka Pro | Pro Check (auch Lippert BottleCheck), Pro Check Universal, Pro Plus, Pro-200, TD40/TD200 | `0059` |
| Mopeka Standard | Std Check (älteres Modell, auch XL und baugleiche Varianten) | `000D` |

Beim **Standard** rechnet der ESP die Füllhöhe selbst aus den Ultraschall-Echos. Die Schallgeschwindigkeit hängt vom Gas ab, deshalb gibt es dort zusätzlich das Feld **Propan-Anteil**: Deutsche Flaschen sind reines Propan (100 %), Mischgas z. B. 60 %, der Rest wird als Butan gerechnet.

Mopeka misst per Ultraschall die **Füllhöhe in mm** von unten durch die Flaschenwand. Der Füllstand ergibt sich aus „Leer bei“ und „Voll bei“:

| Flaschentyp | Leer | Voll |
|---|---|---|
| Europa 6 kg | 38 mm | 336 mm |
| Europa 11 kg | 38 mm | 366 mm |
| Europa 14 kg | 38 mm | 467 mm |
| USA 20 lb | 38 mm | 254 mm |

Für andere Flaschen „Eigene Werte“ wählen und die angezeigte Füllhöhe einmal mit voller und einmal mit fast leerer Flasche ablesen. Messungen mit schlechter Qualität (z. B. Sensor verrutscht, Flasche fast leer) werden ignoriert, der letzte gute Wert bleibt stehen; die Qualität ist im Tab **Live** und per MQTT sichtbar. Der Inhalt in Litern wird aus Füllstand × Flaschenvolumen × Füllstopp berechnet.

Die Dekodierung der Pro-Sensoren folgt der MIT-lizenzierten Bibliothek [mopeka-iot-ble](https://github.com/Bluetooth-Devices/mopeka-iot-ble), die auch Home Assistant verwendet. Für den Standard ist die Dekodierung eine eigene Umsetzung; das Datenformat ist in der ESPHome-Komponente [mopeka_std_check](https://esphome.io/components/sensor/mopeka_std_check/) dokumentiert.

## Anderer Gassensor

Block **GAS SENSOR DEFINITION** in `config.h` anpassen (Datenquelle, Hersteller-ID/UUID, Byte-Offsets). Der Tab **Gas** zeigt die empfangenen Rohbytes mit Offsets, damit sich die Zuordnung leicht finden lässt.

## Batterie des Gassensors

Der ESP scannt **passiv**: Er hört nur die Advertising-Pakete mit, die der Sensor ohnehin regelmäßig sendet. Es gibt keine Scan-Anfragen, keine Verbindung und kein Pairing. Die Batterielaufzeit des Sensors ändert sich dadurch nicht.

## Web-Login

Im Tab **MQTT** unter „Web-Oberfläche Login“ Benutzer und Passwort setzen. Dann fragt der Browser beim Öffnen danach (HTTP Basic Auth, gilt auch für die Live-Daten). Leerer Benutzer = kein Login. Login vergessen: im seriellen Monitor `noauth` senden.

## Serieller Monitor

115200 Baud. Befehle: `read`, `scan` (BLE-Geräte), `filter` (Frischwasser-Filter umschalten), `noauth` (Web-Login entfernen), `help`.

## Updates ohne USB

| Was | Wie |
|---|---|
| Firmware | Arduino IDE → *Sketch → Kompilierte Binärdatei exportieren*, die `.bin` im Web-UI unter **WiFi → Firmware- & Web-Update** hochladen (Neustart), oder per Netzwerkport in der IDE (OTA-Passwort) |
| Web-Oberfläche | `data/index.html.gz` im Web-UI hochladen – ersetzt nur die Seite, ohne Neustart, Einstellungen bleiben |
| Komplettes LittleFS-Image | Nur per USB oder IDE-Netzwerkport; löscht dabei auch die Einstellungen (`config.json`) |

## Sicheres Firmware-Update und Ereignisse

Seit 1.8.0 trägt jede Firmware eine Kennung (`CAMPER-FW:tanklevel:<version>:<chip>;`, `fwcheck.*` aus `firmware/_common`). Im Web-UI unter **WiFi → Firmware- & Web-Update** steht die installierte Version. Eine gewählte Datei wird schon im Browser geprüft und beim Hochladen im Gerät noch einmal, bevor etwas aktiviert wird:

| Datei | Ergebnis |
| --- | --- |
| `.bin` dieses Geräts | Gerät, Version und Vergleich mit der installierten (neuer / gleich / älter, bei gleich oder älter mit Rückfrage) |
| `.merged.bin` aus der Arduino IDE | abgelehnt: das ist das komplette Flash-Abbild für USB, fürs Web-Update die `.bin` ohne „merged“ nehmen |
| `.bin` eines anderen Geräts oder Chips | abgelehnt, z. B. „Firmware für „tanklevel“, dieses Gerät ist „tanklevel““ |
| `.bin` ohne Kennung (ältere Firmware, fremde Datei) | gesperrt, mit „Ohne Kennung hochladen“ trotzdem möglich (für ein Downgrade auf eine Version vor 1.8.0) |
| `data/index.html.gz` | Web-Oberfläche, ohne Neustart |

Schlägt etwas fehl, nennt die Meldung den Grund statt nur „Update failed“. Die Karte **Ereignisse** darunter zeigt die letzten 24 Ereignisse: Start mit Grund (Einschalten, Absturz, Watchdog …), WLAN und MQTT verbunden/getrennt, Uploads mit Ergebnis, Rückfall und gespeicherte Einstellungen (`evlog.*`). Das Log bleibt bei Neustart, Absturz und Update erhalten, bei Stromausfall ist es leer. Updates über den Netzwerkport der Arduino IDE werden nicht geprüft, aber ebenfalls protokolliert.

## Absicherung gegen Aussperren

Damit das Gerät erreichbar bleibt, ohne dass jemand hinmuss (`safeguard.*` aus `firmware/_common`):

- **Rückfall nach Update:** Nach einem Firmware-Update über das Web-UI oder den IDE-Netzwerkport läuft die neue Version auf Probe. Hat sie nach 5 Minuten kein WLAN oder startet sie mehr als dreimal neu, startet der ESP wieder die vorherige Firmware (sie liegt noch im zweiten App-Bereich). Ab 1 Minute stabilem WLAN gilt die neue Version als gut. Flashen per USB wird nie zurückgerollt.
- **WLAN-Änderung mit Rückweg:** Werden SSID, Passwort geändert, während das Gerät verbunden ist, merkt es sich die funktionierenden Werte. Klappt die Verbindung mit den neuen nach dem Neustart nicht (etwa 1 Minute), setzt es die alten wieder ein und startet neu. Ist das Gerät beim Ändern gar nicht verbunden (Einrichtung über den Setup-AP), gelten die neuen Werte sofort.
- Was zuletzt passiert ist, steht im Web-UI unter **WiFi → Verbindungsstatus** in der Zeile **Absicherung**.

Der Schutz greift erst bei Updates, die von dieser Version **aus** gemacht werden. Das Update auf diese Version selbst ist noch nicht abgesichert.

## Versionen

Die laufende Version steht in der Web-UI im Tab **WiFi** und in Home Assistant in der Geräteinfo. Bei Änderungen `FW_VERSION` in `config.h` hochzählen.

| Version | Änderungen |
| --- | --- |
| 1.9.1 | VanNode-Symbol links neben der Überschrift der Webseite und als Favicon |
| 1.9.0 | Neue Namen: Hostname `tanklevel-node`, Setup-WLAN, Gerätename und Release-Datei `tanklevel-node-….bin`. Topics `camper/…` und Home-Assistant-IDs bleiben |
| 1.8.1 | Update-Prüfung vergleicht auch den Chip in der Kennung (gleich wie im Browser); ein Update über den Setup-AP löst keinen WLAN-Rückfall mehr aus |
| 1.8.0 | Sichere Updates: Firmware-Kennung, Prüfung der Datei im Browser und im Gerät (falsches Gerät, falscher Chip, .merged.bin, zu groß), Fehlergrund im Klartext, installierte Version und Ereignis-Log im Web-UI |
| 1.7.0 | Absicherung gegen Aussperren: Rückfall auf die vorherige Firmware, wenn ein Update kein WLAN bekommt; geänderte WLAN-Daten werden zurückgesetzt, wenn sie nicht funktionieren |
| 1.6.0 | Firmware (.bin) und Web-Oberfläche (index.html.gz) im Web-UI unter WiFi hochladbar, ohne USB; Arduino-OTA-Dateisystem-Upload hängt LittleFS vorher aus |
| 1.5.0 | Mopeka Standard (Std Check) als weiterer Sensortyp, Propan-Anteil einstellbar |
| 1.4.0 | Mopeka-Pro-Sensoren als Gassensor (Sensortyp im Tab Gas), Füllhöhe, Temperatur und Messqualität per MQTT |
| 1.3.0 | Optionaler Login für die Web-Oberfläche (Tab MQTT), Last Will mit QoS 1 |
| 1.2.2 | ESP32-S3-Unterstützung (Pins automatisch), Sendeleistung und „AP nur als Notfall“ im Tab WiFi, Neustartgrund, Laufzeit und WLAN-Abbruchgrund in der Web-UI |
| 1.2.1 | Web-UI gzip-komprimiert (Quelle jetzt in `web/`), kompakte Tab-Leiste (Symbol über Text, passt bis 320 px) |
| 1.2.0 | Optionaler Grauwasser-Sensor an GPIO1: Votronic Tankelektrode oder Tank-Sensor FL (mit Leer/Voll-Einlernen), eigene Tankgröße, Matrix und Filter |
| 1.1.0 | Sensoren einzeln abschaltbar (`config.h` und Web-UI), AP-Name mit MAC-Endung, Live-Seite nur mit Anzeigen, Filter im Tab Wasser |
| 1.0.0 | Erste kombinierte Version aus camper-waterlevel und camper-gaslevel |

## Fertige Firmware

Wird im Haupt-Repo per GitHub Actions gebaut, siehe [Fertige Firmware](../../README.md#fertige-firmware).

## Lizenz

MIT
