hflocki/camper-mqtt/firmware/temp/README.md

# Temp Node – DS18B20-Temperaturen per MQTT und Web-Oberfläche

Firmware für einen ESP8266 (ESP-12E, NodeMCU, Wemos D1 mini) oder ESP32-C3, die bis zu **8 DS18B20-Temperatursensoren** an einem 1-Wire-Bus ausliest – z. B. Kühlschrank, Gefrierfach, Innenraum und außen.

- Sensoren werden am Bus **automatisch gefunden** und in der Web-UI benannt, keine Adressen im Code
- Werte per **MQTT** mit Home-Assistant-Discovery
- Web-Oberfläche mit Live-Werten, Min/Max seit Start, Offset-Korrektur je Sensor
- **Alarm-Grenzwerte** je Sensor (z. B. „Kühlschrank über 8 °C seit 15 min“), per MQTT auch ohne Home Assistant nutzbar, das [display-node](../display) zeigt sie als Warnung
- Optionaler Login für die Web-Oberfläche
- Access Point beim ersten Start, WLAN/MQTT im Browser einstellen, OTA-Updates

## Web-Oberfläche

| Live | Sensoren |
|---|---|
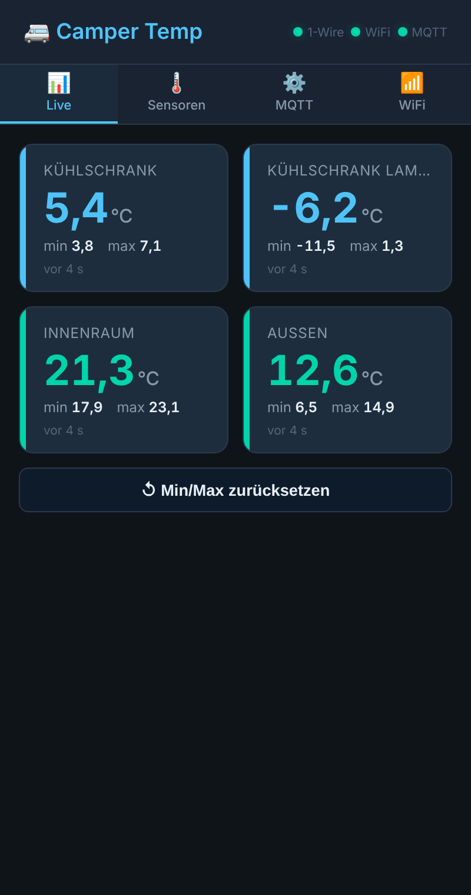
[picture p15: firmware/temp/images/tab-live.png]
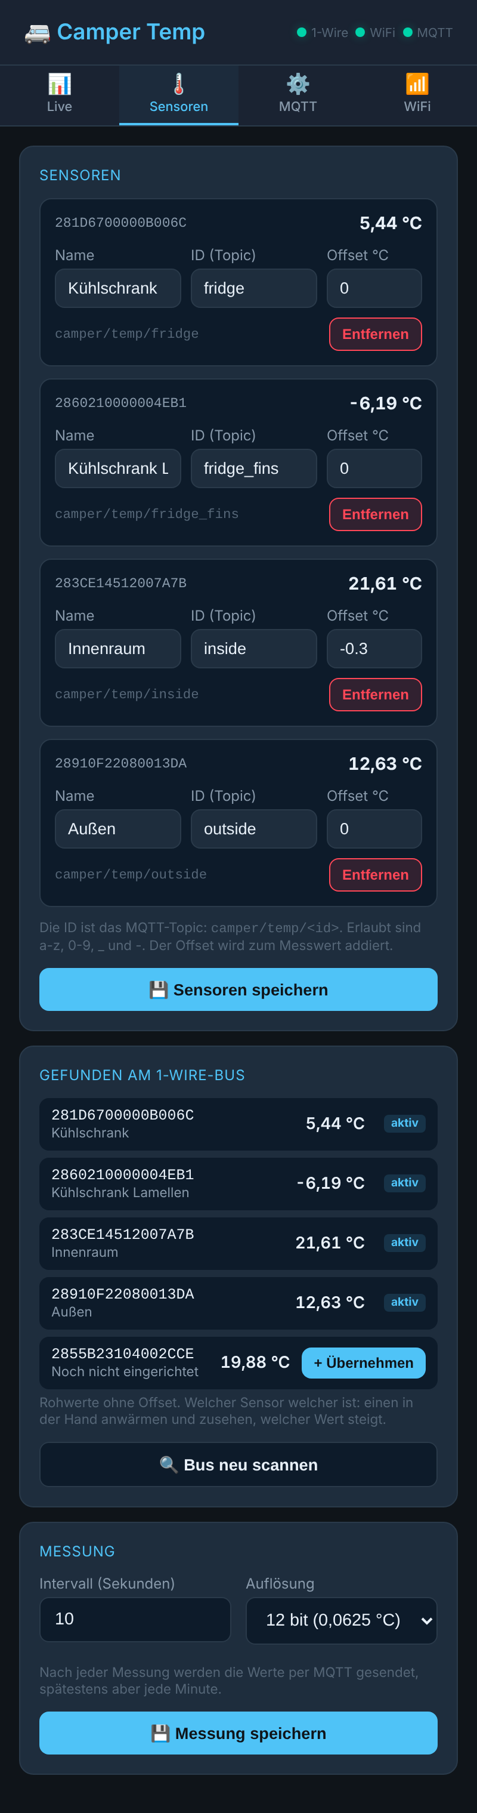
[picture p16: firmware/temp/images/tab-sensors.png]
|  |  |

| MQTT | WiFi |
|---|---|
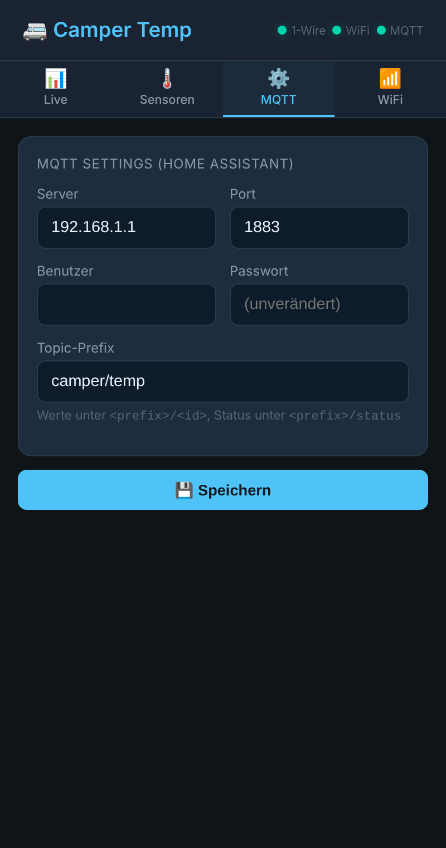
[picture p17: firmware/temp/images/tab-mqtt.png]
|  |  |

Die Bilder zeigen Beispieldaten.

## Ordner

```
camper_temp/        Sketch für die Arduino IDE (.ino + .cpp/.h)
camper_temp/web/    Quelle der Web-Oberfläche (index.html)
camper_temp/data/   LittleFS-Inhalt: index.html.gz (komprimiert, wird hochgeladen)
```

| Datei | Inhalt |
|---|---|
| `config.h` | Pin, Standardwerte, Anzahl Sensoren |
| `temp_sensor.cpp` | 1-Wire-Busscan, nicht blockierende Messung, Plausibilitätsprüfung, Min/Max |
| `mqtt_ha.cpp` | MQTT, HA-Discovery, Aufräumen gelöschter/umbenannter Sensoren |
| `webserver.cpp` | Web-UI (gzip), REST-API, Konfiguration in LittleFS |
| `wifi_manager.cpp` | WLAN mit AP-Fallback (ESP8266 und ESP32) |

## Hardware

| | ESP8266 (NodeMCU / D1 mini) | ESP32-C3 |
|---|---|---|
| DS18B20 DATA | **GPIO4** (D2) | GPIO4 |
| DS18B20 VDD | 3,3 V | 3,3 V |
| DS18B20 GND | GND | GND |

Zwischen DATA und 3,3 V gehört **ein 4,7-kΩ-Pull-up** (einmal pro Bus, nicht pro Sensor). Alle Sensoren hängen parallel an denselben drei Leitungen. Bei langen Leitungen (> 5 m) oder vielen Sensoren ggf. 2,2 kΩ verwenden. Beim ESP8266 GPIO0, GPIO2 und GPIO15 meiden (Boot-Pins). Anderer Pin: `ONEWIRE_PIN` in `config.h`.

## Arduino IDE

> **Eigene Passwörter, WLAN und Broker:** `config_local.h.example` im Sketch-Ordner nach `config_local.h` kopieren und anpassen. Die Datei geht nicht nach GitHub. Details in der [Haupt-README](../../README.md#eigene-einstellungen-config_localh).

**Board-Einstellungen (ESP8266)**

| Einstellung | Wert |
|---|---|
| Board | NodeMCU 1.0 (ESP-12E Module) bzw. LOLIN(WEMOS) D1 R2 & mini |
| Flash Size | **4MB (FS:1MB OTA:~1019KB)** |

Board-Paket: esp8266 von ESP8266 Community, 3.1.x (getestet 3.1.2).
Für ESP32-C3: Board „ESP32C3 Dev Module“, USB CDC On Boot „Enabled“, Standard-Partition reicht (ca. 1,2 MB Firmware).

**Libraries** (Bibliotheksverwalter)

| Library | Autor | getestet |
|---|---|---|
| OneWire | Paul Stoffregen | 2.3.8 |
| DallasTemperature | Miles Burton | 4.0.6 |
| PubSubClient | Nick O'Leary | 2.8 |
| ArduinoJson | Benoit Blanchon | 7.4.2 |
| ESP Async WebServer | ESP32Async | 3.12.1 |
| ESP Async TCP (nur ESP8266) | ESP32Async | 2.0.0 |
| Async TCP (nur ESP32) | ESP32Async | 3.5.0 |

**Flashen**

1. In `config.h` `DEFAULT_OTA_PASSWORD` und `DEFAULT_AP_PASSWORD` ändern.
2. `camper_temp.ino` öffnen, Flash Size prüfen, hochladen.
3. Serial Monitor schließen, `Cmd+Shift+P` → **Upload LittleFS to Pico/ESP8266/ESP32** (Plugin [arduino-littlefs-upload](https://github.com/earlephilhower/arduino-littlefs-upload)).

Der LittleFS-Upload überschreibt die gespeicherte Konfiguration.

**Web-Oberfläche ändern:** Quelle ist `web/index.html`, hochgeladen wird `data/index.html.gz`. Nach einer Änderung neu packen, dann LittleFS hochladen:

```
python3 tools/web/pack_web.py temp      # im Repo-Hauptordner
```

Ohne das Repo-Werkzeug geht es auch so (im Sketch-Ordner `camper_temp`): `gzip -9 -n -c web/index.html > data/index.html.gz`. Die GitHub Action prüft bei jedem Push, ob die gepackte Seite zur `index.html` passt.

Spätere Firmware-Updates gehen auch per OTA (`temp-node` unter Netzwerk-Ports) oder über die Web-Oberfläche.

## Erstbenutzung

1. Beim ersten Start läuft nur der Access Point **`Temp-Node-XXXXXX`** (Passwort aus `config.h`). `XXXXXX` sind die letzten 6 Stellen der WLAN-MAC.
2. Verbinden und `http://192.168.4.1` öffnen.
3. Tab **WiFi**: WLAN eintragen → Neustart.
4. Tab **MQTT**: Broker eintragen → Neustart.
5. Tab **Sensoren**: Unter „Gefunden am 1-Wire-Bus“ jeden Sensor mit **+ Übernehmen** hinzufügen, Name und ID vergeben, **Sensoren speichern**. Welcher Sensor welcher ist: einen in der Hand anwärmen und zusehen, welcher Wert steigt.

Eine feste IP vergibt man am einfachsten als DHCP-Reservierung im Router; im Netz ist das Gerät auch als `temp-node.local` erreichbar.

## MQTT / Home Assistant

Prefix (Web-UI) Standard `camper/temp`:

| Topic | Wert |
|---|---|
| `<prefix>/status` | `online` / `offline` (Last Will) |
| `<prefix>/info` | Diagnose (retained, beim Verbinden und jede Minute): JSON mit `version`, `ip`, `mac`, `rssi`, `uptime` (s), `reset` (Grund des letzten Neustarts), `heap` |
| `<prefix>/rssi` | WLAN-Signal |
| `<prefix>/<id>` | Temperatur in °C (2 Nachkommastellen), retained |
| `<prefix>/<id>/available` | `online` / `offline` – Sensor antwortet am Bus |
| `<prefix>/<id>/alarm` | `ON` / `OFF` – Grenzwert dieses Sensors verletzt |
| `<prefix>/alarm` | `ON`, solange irgendein Sensor im Alarm ist |
| `<prefix>/alarm_text` | Lesbarer Text aller Alarme, z. B. `Kühlschrank zu warm: 9,2 °C (Grenze 8,0 °C)`; leer = kein Alarm |
| `<prefix>/sensors` | Alle Sensoren als eine JSON-Liste für Displays: `[{"id":"fridge","name":"Kühlschrank","t":4.31,"alarm":0}, …]` (`t` = `null` ohne gültigen Wert, `alarm` 0 = keiner, 1 = zu kalt, 2 = zu warm) |

Gesendet wird nach jeder Messung (Intervall in der Web-UI, Standard 10 s), spätestens jede Minute. Liefert ein Sensor keinen gültigen Wert (abgezogen, Kabelbruch, 85-°C-Startwert), wird kein Wert gesendet und die Entität in HA als nicht verfügbar markiert.

In Home Assistant erscheint **ein** Gerät „Temp Node“ mit einer Temperatur-Entität pro Sensor, einem Alarm-Binärsensor pro Sensor mit Grenzwerten, dem Gesamtalarm „Temperatur-Alarm“ und dem Alarmtext. Die `unique_id` basiert auf der Sensoradresse: Umbenennen oder eine neue ID behält die Historie. Wird ein Sensor entfernt, verschwindet auch seine Entität.

**Umstieg von ESPHome:** Das alte ESPHome-Gerät in HA unter *Einstellungen → Geräte & Dienste → ESPHome* löschen. Die Sensoradressen aus dem ESPHome-Log tauchen in der Web-UI unter „Gefunden am 1-Wire-Bus“ wieder auf (ESPHome schreibt sie in umgekehrter Byte-Reihenfolge: `0x0b000000671daa28` entspricht `28AA1D670000000B`).

## Alarm-Grenzwerte

Im Tab **Sensoren** hat jeder Sensor drei Felder:

| Feld | Bedeutung |
|---|---|
| Alarm unter °C | Alarm, wenn der Wert darunter liegt (leer = aus) |
| Alarm über °C | Alarm, wenn der Wert darüber liegt (leer = aus) |
| Verzögerung min | So lange muss die Grenze ununterbrochen verletzt sein (0–240, 0 = sofort) |

Beispiele: Kühlschrank „über 8 °C, 15 min“ (Türöffnen löst nichts aus), Gefrierfach „über −12 °C, 30 min“, Innenraum „unter 5 °C, 0 min“ als Frostwarnung.

Der Alarm geht weg, sobald der Wert 0,5 °C zurück im erlaubten Bereich ist, ohne Verzögerung. So flackert er nicht, wenn der Wert genau an der Grenze liegt. Liefert ein Sensor keine Messung mehr, bleibt sein Alarmzustand stehen; der Ausfall selbst ist über `<id>/available` sichtbar. Nach dem Speichern der Sensorliste beginnt die Verzögerung neu.

Live-Seite: Kacheln im Alarm haben einen roten Rahmen, darüber steht der Alarmtext.

## Web-Login

Im Tab **MQTT** unter „Web-Oberfläche Login“ Benutzer und Passwort setzen. Dann fragt der Browser beim Öffnen danach (HTTP Basic Auth, gilt auch für die Live-Daten). Leerer Benutzer = kein Login. Login vergessen: im seriellen Monitor `noauth` senden.

## Serieller Monitor

115200 Baud. Befehle: `read` (Werte), `scan` (Bus neu durchsuchen), `bus` (gefundene Adressen), `noauth` (Web-Login entfernen), `help`.

## Updates ohne USB

| Was | Wie |
|---|---|
| Firmware | Arduino IDE → *Sketch → Kompilierte Binärdatei exportieren*, die `.bin` im Web-UI unter **WiFi → Firmware- & Web-Update** hochladen (Neustart), oder per Netzwerkport in der IDE (OTA-Passwort) |
| Web-Oberfläche | `data/index.html.gz` im Web-UI hochladen – ersetzt nur die Seite, ohne Neustart, Einstellungen bleiben |
| Komplettes LittleFS-Image | Nur per USB oder IDE-Netzwerkport; löscht dabei auch die Einstellungen (`config.json`) |

## Sicheres Update, Ereignisse und Rückfall

Seit 1.3.0 hat jede Firmware eine Kennung (`CAMPER-FW:temp:<version>:<chip>;`) und dieselbe Absicherung wie alle VanNode-Geräte (`fwcheck.*`, `evlog.*`, `safeguard.*` aus `firmware/_common`):

- **Prüfung beim Update** (Web-UI unter **WiFi → Firmware- & Web-Update**): Die installierte Version steht dabei. Eine gewählte Datei wird schon im Browser und beim Hochladen im Gerät noch einmal geprüft, bevor etwas aktiviert wird. Abgelehnt werden eine `.merged.bin` (komplettes Flash-Abbild für USB), Firmware für ein anderes Gerät oder einen anderen Chip und zu große Dateien. Eine Datei ohne Kennung (Version vor 1.3.0) geht nur mit „Ohne Kennung hochladen“. Fehler stehen im Klartext da statt „Update failed“.
- **Ereignisse:** Die letzten Ereignisse (Start mit Grund, WLAN und MQTT verbunden/getrennt, Uploads mit Ergebnis, Rückfall, gespeicherte Einstellungen) stehen in der Web-Oberfläche. Sie bleiben bei Neustart, Absturz und Update erhalten, nach einem Stromausfall ist das Log leer.
- **Rückfall nach Update:** Hat eine neue Firmware nach 5 Minuten kein WLAN oder startet sie mehr als dreimal neu, startet wieder die vorherige. Kam das Update über den Setup-AP (ohne WLAN), wird nur auf Neustart-Schleifen geachtet.
- **WLAN-Änderung mit Rückweg:** Werden die WLAN-Daten geändert, während das Gerät verbunden ist, merkt es sich die funktionierenden. Klappt die Verbindung mit den neuen nach dem Neustart etwa 1 Minute lang nicht, kommen die alten zurück.
- **ESP8266:** Prüfung über die Kennung (Gerät und Chip), das Log liegt nur im RAM (nach jedem Neustart leer), den Rückfall gibt es nur auf dem ESP32-C3 (der ESP8266 hat dafür keine zwei App-Bereiche mit Umschaltung wie der ESP32).

## Versionen

Die laufende Version steht in der Web-UI im Tab **WiFi** und in Home Assistant in der Geräteinfo. Bei Änderungen `FW_VERSION` in `config.h` hochzählen.

| Version | Änderungen |
|---|---|
| 1.4.1 | VanNode-Symbol links neben der Überschrift der Webseite und als Favicon |
| 1.4.0 | Neue Namen: Hostname `temp-node`, Setup-WLAN, Gerätename und Release-Datei `temp-node-….bin`. Topics `camper/…` und Home-Assistant-IDs bleiben |
| 1.3.0 | Sicheres Update (Kennung, Prüfung im Browser und im Gerät, Fehler im Klartext), Ereignis-Log, Rückfall auf die vorherige Firmware und WLAN-Änderung mit Rückweg; auf dem ESP8266 nur Prüfung und Log |
| 1.2.0 | Firmware (.bin) und Web-Oberfläche (index.html.gz) im Web-UI unter WiFi hochladbar, ohne USB (ESP32-C3 und ESP8266); Arduino-OTA-Dateisystem-Upload hängt LittleFS vorher aus |
| 1.0.0 | Erste Version: bis zu 8 DS18B20, automatische Erkennung, Web-UI, MQTT mit HA-Discovery |
| 1.1.0 | Alarm-Grenzwerte je Sensor mit Verzögerung (`<id>/alarm`, `alarm`, `alarm_text`, HA-Binärsensoren), JSON-Liste `<prefix>/sensors` für Displays, Web-Login, Last Will mit QoS 1 |

## Fertige Firmware

Wird im Haupt-Repo per GitHub Actions gebaut, siehe [Fertige Firmware](../../README.md#fertige-firmware).

## Lizenz

MIT
