hflocki/camper-mqtt/firmware/roadbuddy/README.md

# RoadBuddy – M5Stack Core2 Camper-Display

Kleines Touch-Display für das Wohnmobil auf Basis des **M5Stack Core2**. Es ist für den schnellen Blick beim Ankommen gedacht: Stehe ich gerade, reichen Wasser und Gas? Dazu zeigt es per MQTT Neigung (Wasserwaage), Frischwassertank, Gasflasche, Temperaturen und Batterien. Zum Akku-Sparen schaltet sich das Display automatisch aus, danach geht das Gerät in den Deep Sleep, WLAN und MQTT sind dann komplett aus.

Optik und Farben entsprechen dem großen Wandpanel [display-node](../display): dunkle Karten mit dünnem Rand, farbiger Kreis mit Symbol, Dezimalkomma, gleiche Zustandsfarben und dieselbe Segmentanzeige für Batterien.

---

## Flashen

Gebaut wird mit der Arduino IDE (1.x und 2.x). Der Quellcode liegt in `roadbuddy/`. Du brauchst eine eigene `roadbuddy/config.h` mit WLAN- und MQTT-Zugangsdaten. Als Vorlage liegt `config.example.h` bei, deine `config.h` ist per `.gitignore` vom Git ausgeschlossen.

### Voraussetzungen

1. **Board-Paket** „M5Stack“ von M5Stack über den Boardverwalter installieren (Board-Manager-URL: `https://static-cdn.m5stack.com/resource/arduino/package_m5stack_index.json`).
2. **Bibliotheken** über den Bibliotheksverwalter:
   - **M5Unified** (zieht **M5GFX** automatisch mit)
   - **PubSubClient** von Nick O'Leary
   - **ArduinoJson** von Benoit Blanchon (für die Temperaturliste)
3. Falls vorhanden, die alte Bibliothek **M5Core2** entfernen (Ordner `Documents/Arduino/libraries/M5Core2` löschen oder verschieben). Sie ist mit neuen ESP32-Cores nicht mehr kompatibel und führt zum Fehler `rom/miniz.h: No such file or directory`.

### Schritte

1. Den Ordner [`roadbuddy/`](roadbuddy/) in der Arduino IDE öffnen (`roadbuddy.ino`). Der Ordner muss genauso heißen wie die Hauptdatei, sonst findet die IDE den Sketch nicht.
2. In diesem Ordner `config.example.h` nach `config.h` kopieren und die eigenen Zugangsdaten eintragen:

   ```cpp
   const char* ssid = "YOUR_WIFI_SSID";
   const char* password = "YOUR_WIFI_PASSWORD";

   const char* mqtt_server = "192.168.1.10";
   const int mqtt_port = 1883;
   const char* mqtt_user = "YOUR_MQTT_USER";
   const char* mqtt_pass = "YOUR_MQTT_PASSWORD";

   const char* mqtt_topic = "camper/level/#";
   ```

3. Unter *Werkzeuge → Board* **M5Core2** wählen (Eintrag unter „M5Stack“).
4. Den Core2 per USB-C verbinden, unter *Werkzeuge → Port* den Anschluss wählen (auf dem Mac z. B. `/dev/cu.usbserial-…`).
5. Hochladen.

Der Serial Monitor (115200 Baud) gibt jedes eingehende MQTT-Topic mit Wert aus, das hilft bei der Fehlersuche.

### Fehlersuche

- **`rom/miniz.h: No such file or directory`:** Die alte `M5Core2`-Bibliothek ist noch installiert, siehe Voraussetzungen Punkt 3.
- **`config.h: No such file or directory`:** `config.example.h` wurde noch nicht nach `config.h` kopiert.
- **„Multiple libraries were found for WiFi.h“:** Nur eine Warnung. Die WiFi-Bibliothek aus dem ESP32-Core wird verwendet. Eine zusätzliche `WiFi`-Bibliothek in `Documents/Arduino/libraries` kann gelöscht werden.
- **Display zeigt falsche Pitch-/Roll-Werte:** Im Serial Monitor prüfen, welche Topics wirklich ankommen.
- **Upload bricht ab oder Port fehlt:** Anderes USB-Kabel (Datenkabel) testen, bei Bedarf den Treiber für den USB-Seriell-Chip installieren.
- **Gerät wacht nicht auf:** Display kurz antippen. Hilft das nicht, den Power-Knopf links am Gehäuse drücken, um das Gerät neu zu starten.
- **Seite zeigt `--`:** Es wurde noch kein Wert empfangen. Prüfen, ob der Sensor mit `retain` sendet, sonst erscheint der Wert erst bei der nächsten Meldung.

---

## Seiten

Die Seiten werden mit den beiden äußeren Touch-Tasten (links/rechts) umgeschaltet. Die mittlere Taste schaltet das Display aus.

| Seite | Inhalt |
| ----- | --- |
| Start | VanNode-Logo (Symbol über dem Schriftzug). Erste Seite nach dem Einschalten, rechts davon folgen Level und die übrigen Seiten |
| Level | Fahrzeug von oben mit „vorne“ oben: an jedem Rad die Keilhöhe in cm, Räder mit Keil orange. In der Mitte ein Zielring, der Punkt wandert zur tiefen Seite (grün, wenn eben). Rechts „Eben“ oder „Nicht eben“, darunter Li/Re („0,9° rechts tief“) und Vo/Hi („eben“) und der größte Keil. Gleiche Darstellung wie am Wandpanel |
| Wassertank | Füllstand groß in %, Liter darunter, Sensor-Status; rechts ein Tank mit animierter Oberfläche. Unter 25 % gelb, unter 10 % rot (Tank und Zahl) |
| Gas | Füllstand groß in %, Restmenge darunter, Status und Akku des Gassensors; rechts die Gasflasche. Unter 15 % rot |
| Temperaturen | Sensoren von temp-node mit Namen und Wert. 1–2 Sensoren als große Zeilen, 3–4 als 2×2-Kacheln. Bei 5–8 Sensoren kommt automatisch eine zweite Temperaturseite dazu. Alarm (zu warm/zu kalt) = roter Rahmen. Farbe: blau unter 10 °C, grün bis 28 °C, gelb bis 45 °C, rot darüber |
| Batterien | Bis zu 3 Batterien von battery-node: Name, Ladestand (rot unter 20 %, gelb unter 40 %), Spannung, Leistung (+ = lädt, z. B. Solar), Restlaufzeit beim Entladen mit Uhr-Symbol („3,2 Tage“, „5 h 20 min“). Darunter eine Segmentanzeige mit 13 Feldern von Rot nach Grün nach dem Ladezustand, ohne Ladezustand (z. B. BM2) nach der Spannung von 11,8 bis 12,8 V. Der BM2 an der Starterbatterie zeigt statt Leistung seinen Zustand (Normal, Schwach, Kritisch, Lädt, Erhaltungsladung). Fehler oder schwache Starterbatterie = roter Rahmen |
| System | WLAN, Mobilfunk des Routers, MQTT-Broker, Akku, Firmware-Version und Laufzeit, IP-Adresse für die Update-Seite. Solange diese Seite offen ist, bleibt der RoadBuddy bis zu 15 Minuten wach (Update-Modus) |

Welche Seiten es gibt, steht in `config.h` (`USE_LEVEL`, `USE_WATER`, `USE_GAS`, `USE_TEMP`, `USE_BATTERY`). Start- und System-Seite gibt es immer. Das Logo kommt aus `logo_img.h`, erzeugt mit `tools/logo/make_logo.py`.

In der Kopfzeile stehen links Signalbalken: mit Router-Daten die Mobilfunkstärke (5 Balken nach RSRP bzw. RSSI, dazu das Netz, z. B. „LTE“), sonst die WLAN-Stärke des RoadBuddy (4 Balken). Grün = WLAN und MQTT ok, gelb = MQTT fehlt, rotes Kreuz = kein WLAN. In der Mitte die Seitenanzeige (aktive Seite als Pille), rechts der Akku des Core2 (blau mit „+“ beim Laden).

Level-Werte, die länger als 30 Sekunden nicht aktualisiert wurden, behalten ihre Farben; rechts unten steht dann „Werte alt“. Meldet ein Sensor `offline`, wird seine Seite ausgegraut.

---

## Stromsparen

| Zeit ohne Berührung | Verhalten |
| --- | --- |
| 60 s | Display aus (WLAN und MQTT laufen weiter, ein Antippen zeigt sofort aktuelle Werte) |
| 5 min nach Display-aus | Deep Sleep: WLAN und MQTT aus, minimaler Verbrauch |

- **Aufwecken:** Berührung irgendwo auf dem Display. Das Gerät startet neu, verbindet WLAN und MQTT und zeigt die zuletzt geöffnete Seite. Die weckende Berührung löst keinen Seitenwechsel aus.
- Das Display kann auch manuell mit der mittleren Taste ausgeschaltet werden, der Schlaf-Timer läuft dann ab diesem Moment.
- Zusätzlich weckt ein Timer das Gerät alle 24 Stunden, es schläft sofort wieder ein (Sicherheitsnetz, kostet praktisch keinen Strom).

---

## MQTT-Topics

Das Display ist reiner Empfänger und fragt nichts ab, die Aktualisierungsrate bestimmen die Sensoren. Bei `retain`-Meldungen erscheinen die Werte direkt nach dem Aufwachen.

| Topic | Bedeutung |
| ----- | --- |
| `camper/level/pitch` | Neigung vorne/hinten in Grad |
| `camper/level/roll` | Neigung links/rechts in Grad |
| `camper/level/wedge_fl`, `_fr`, `_rl`, `_rr` | Keilhöhe in cm unter jedem Rad (vorne links, vorne rechts, hinten links, hinten rechts) |
| `camper/level/is_level` | `ON` / `OFF`: steht das Fahrzeug innerhalb der Toleranz |
| `camper/level/tolerance` | Toleranz in Grad (Größe des Zielrings) |
| `camper/level/status` | `online` / `offline` von level-node |
| `camper/tanklevel/water/percent` | Füllstand Frischwasser in % |
| `camper/tanklevel/water/liters` | Tankinhalt in Litern |
| `camper/tanklevel/gas/level` | Füllstand Gasflasche in % |
| `camper/tanklevel/gas/content` | Restmenge der Gasflasche (kg) |
| `camper/tanklevel/gas/battery` | Akku des Gassensors in % |
| `camper/tanklevel/gas/ble_state` | `OK`, sonst wird „BLE“ als Warnung gezeigt |
| `camper/tanklevel/status` | `online` / `offline` (Last Will, gilt für Wasser und Gas) |
| `camper/temp/sensors` | Alle Temperatursensoren als JSON-Liste: `[{"id":"fridge","name":"Kühlschrank","t":4.31,"alarm":0}, …]` |
| `camper/temp/status` | `online` / `offline` von temp-node |
| `camper/battery/batteries` | Alle Batterien als JSON-Liste: `[{"name":"Bordbatterie","ok":true,"soc":78,"v":13.31,"w":-56,"rt":2830}, …]` (ab battery-node 1.2.2 mit Restlaufzeit) |
| `camper/battery/status` | `online` / `offline` von battery-node |
| `camper/router/mobile` | Mobilfunkdaten des Routers als JSON (`rsrp`, `rssi`, Netztyp), für die Signalbalken. Einstellbar mit `ROUTER_TOPIC` in `config.h`, `""` schaltet es ab |

Eigene Topics (sendet der Road Buddy selbst, Präfix änderbar mit `#define SELF_TOPIC` in `config.h`):

| Topic | Bedeutung |
| ----- | --- |
| `camper/roadbuddy/status` | `online` / `offline` (Last Will) |
| `camper/roadbuddy/info` | Diagnose (retained, beim Verbinden und jede Minute): JSON mit `version`, `ip`, `mac`, `rssi`, `uptime` (s), `reset`, `heap` |

Weitere Topics unter diesen Präfixen (z. B. `rssi`, `voltage`, `raw_level`, `tare_*`, Grauwasser) werden ignoriert. Die Topics für Wasser und Gas stehen als Konstanten am Anfang des Sketches, das Level-Topic in `config.h`. Die früheren getrennten Geräte (`camper/waterlevel`, `camper/gaslevel`) werden nicht mehr unterstützt.

Die Sensoren dazu:

- Level: [level-node](../level) (ESP32 + Adafruit BNO085, Fork des Levelsensors von klehnst)
- Wasser und Gas: [tanklevel-node](../tanklevel) (ein ESP32-C3 für Frischwasser, Grauwasser und Gas)
- Temperaturen: [temp-node](../temp) (bis zu 8 DS18B20 mit Alarm-Grenzwerten)
- Batterien: [battery-node](../battery) (Daly, Ective BM X, BM2 über Bluetooth)

Mehr zeigt der RoadBuddy bewusst nicht: Heizung, Lüfter und Warnungen laufen auf dem großen Wandpanel [display-node](../display).

---

## Update über WLAN

Der RoadBuddy hat eine kleine Webseite für Firmware-Updates. Sie ist nur erreichbar, solange er wach ist.

1. Display antippen und zur **System-Seite** blättern. Dort stehen IP-Adresse und Version. Solange die Seite offen ist, bleibt der RoadBuddy bis zu 15 Minuten wach.
2. Im Browser `http://roadbuddy.local` oder die angezeigte IP öffnen.
3. Die `.bin` aus den GitHub Actions bzw. dem Release (`roadbuddy-node-core2.bin`) auswählen und hochladen.
4. Während des Uploads zeigt das Display den Fortschritt, danach startet er neu.

### Sicheres Update, Ereignisse und Rückfall

Seit 1.3.0 hat jede Firmware eine Kennung (`CAMPER-FW:roadbuddy:<version>:<chip>;`) und dieselbe Absicherung wie alle VanNode-Geräte (`fwcheck.*`, `evlog.*`, `safeguard.*` aus `firmware/_common`):

- **Prüfung beim Update** (Update-Webseite): Die installierte Version steht dabei. Eine gewählte Datei wird schon im Browser und beim Hochladen im Gerät noch einmal geprüft, bevor etwas aktiviert wird. Abgelehnt werden eine `.merged.bin` (komplettes Flash-Abbild für USB), Firmware für ein anderes Gerät oder einen anderen Chip und zu große Dateien. Eine Datei ohne Kennung (Version vor 1.3.0) geht nur mit „Ohne Kennung hochladen“. Fehler stehen im Klartext da statt „Update failed“.
- **Ereignisse:** Die letzten Ereignisse (Start mit Grund, WLAN und MQTT verbunden/getrennt, Uploads mit Ergebnis, Rückfall, gespeicherte Einstellungen) stehen in der Web-Oberfläche. Sie bleiben bei Neustart, Absturz und Update erhalten, nach einem Stromausfall ist das Log leer.
- **Rückfall nach Update:** Hat eine neue Firmware nach 5 Minuten kein WLAN oder startet sie mehr als dreimal neu, startet wieder die vorherige. Kam das Update über den Setup-AP (ohne WLAN), wird nur auf Neustart-Schleifen geachtet.
- Aufwachen aus dem Deep Sleep zählt nicht als Neustart und wird nicht eingetragen. Eine neue Firmware gilt nach 15 s mit WLAN als gut. WLAN-Daten kommen nur über USB (`config.h`), deshalb gibt es keinen WLAN-Rückweg.

**Einmal per USB mit eigener `config.h` flashen:** Der Build aus GitHub Actions enthält keine Zugangsdaten (er nutzt `config.example.h`). Ab Version 1.1.0 speichert eine Firmware mit echter `config.h` WLAN, MQTT und den Web-Login im Flash, die Actions-Firmware liest sie von dort. Deshalb das erste Mal (und nach einem Löschen des Flash) per USB mit eigener `config.h` flashen, danach reichen die Updates über die Webseite.

Ein Login für die Seite lässt sich mit `WEB_USER` / `WEB_PASS` in `config.h` setzen (leer = ohne Login).

---

## Anpassungen

Alle Einstellungen stehen am Anfang von `roadbuddy.ino`:

| Konstante | Wirkung |
| --- | --- |
| `DISPLAY_TIMEOUT_MS` | Zeit bis das Display ausgeht (Standard 60 s) |
| `SLEEP_DELAY_MS` | Zeit von Display-aus bis Deep Sleep (Standard 5 min) |
| `STALE_MS` | Ab wann Level-Werte als veraltet gelten (Standard 30 s) |
| `BUBBLE_SIGN_X` / `BUBBLE_SIGN_Y` | Auf `-1.0f` setzen, wenn der Punkt nicht zur tiefen Seite wandert |
| `BUBBLE_FULL_SCALE_DEG` | Neigung, bei der der Punkt den Rand des Fahrzeugs erreicht (Standard 3°) |
| `TOPIC_TANK_*` | MQTT-Topics für Wasser und Gas |
| `TOPIC_TEMP_*` | MQTT-Topics von temp-node |
| `UPDATE_AWAKE_MS` | Wie lange die System-Seite den RoadBuddy wach hält (Standard 15 min) |
| Farben `COL_*`, `SEG_COL` | Palette wie am Wandpanel (`firmware/display/.../ui.cpp`), beim Ändern dort mitziehen |

WLAN-Hostname und MQTT-Client-ID beginnen mit `roadbuddy`.

---

## Projektstruktur

```
m5core2-roadbuddy/
├── README.md                    – diese Übersicht
├── .gitignore
└── roadbuddy/
    ├── roadbuddy.ino            – Sketch (Seiten, MQTT, Stromsparen)
    ├── logo_img.h               – Logo der Startseite (erzeugt, nicht von Hand ändern)
    ├── webota.cpp / .h          – Update-Webseite
    └── config.example.h         – Vorlage für WLAN- und MQTT-Daten
```

---

## Hinweise

- Zugangsdaten gehören nur in `config.h`, diese Datei ist in `.gitignore` eingetragen und darf nie committet werden.
- Der Prozentwert des Core2-Akkus ist nur eine Schätzung aus der Spannung.

---

## Fertige Firmware

Wird im Haupt-Repo per GitHub Actions gebaut, siehe [Fertige Firmware](../../README.md#fertige-firmware). Der CI-Build nutzt `config.example.h` als `config.h`, die `.bin` enthält also keine Zugangsdaten. Sie übernimmt die Zugangsdaten, die eine eigene Firmware vorher im Flash gespeichert hat (siehe [Update über WLAN](#update-über-wlan)).
