hflocki/camper-mqtt/firmware/heater/README.md

> [!WARNING]
> **IN ENTWICKLUNG – kein fertiges Projekt.** Am echten LIN-Bus noch nicht getestet. Nutzung auf eigenes Risiko.

# heater-node

Truma-Heizung (Combi / Combi D, Vario Heat) per **MQTT** steuern – mit einem ESP32 am LIN-Bus, reines **Arduino**, ohne ESPHome.

- Der ESP ist **LIN-Slave** und meldet sich am CP Plus als **iNet Box** (T23.70.0) an.
- Das **CP Plus bleibt LIN-Master** und voll bedienbar. Änderungen am CP Plus erscheinen in MQTT, MQTT-Befehle erscheinen am CP Plus.
- Topics unter `camper/heater/...` wie bei den anderen VanNode-Geräten, dazu Home-Assistant-Auto-Discovery (Klima-Entität zum Bedienen). Die Unterstruktur `control_status/...` und `set/...` folgt [mc0110/inetbox2mqtt](https://github.com/mc0110/inetbox2mqtt); wer dessen Topics braucht, stellt das Basis-Topic auf `service/truma`.
- Web-Oberfläche für Bedienung, Einstellungen, Log und Firmware-Update.

Protokoll-Logik portiert aus [skrebber/esphome-truma_inetbox](https://github.com/skrebber/esphome-truma_inetbox) (Fork von Fabian-Schmidt), basierend auf der Vorarbeit von [danielfett/inetbox.py](https://github.com/danielfett/inetbox.py) und [WomoLIN](https://github.com/muccc/WomoLIN).

## Voraussetzungen

- CP Plus **ab Version C4.xx** (ältere C3 können nur lesen, nicht schalten)
- **Keine echte iNet Box** am Bus, **kein iNet X** Bedienteil
- ESP32 mit LIN-Transceiver (TJA1020/TJA1021 o. ä.)

## Unterstützte Boards

In `truma_heater/config.h` ganz oben genau ein Board aktivieren. Ist keins aktiv, nimmt die Firmware das Standard-Board des Chips, für den gebaut wird. Die fertigen Releases gibt es deshalb für beide: `heater-node-esp32c3.bin` (Super Mini) und `heater-node-esp32.bin` (ESP32 DevKit, TX 16 / RX 17).

| Profil | Board | LIN TX / RX | Arduino-Board |
|---|---|---|---|
| `BOARD_ESP32C3_SUPERMINI` (Standard beim C3) | ESP32-C3 Super Mini + LIN-Modul (Lochraster-Aufbau, siehe HARDWARE.md) | 4 / 3 | ESP32C3 Dev Module |
| `BOARD_ESP32_DEVKIT` (Standard beim ESP32) | ESP32 DevKit V4 (WROOM-32) + LIN-Modul (z. B. FST T151), 5 V vom Step-down | 16 / 17 | ESP32 Dev Module |
| `BOARD_SMARTAVAN` | smartavan heater controller | 16 / 17 | ESP32 Dev Module |
| `BOARD_ESP32_GENERIC` | ESP32 DevKit + LIN-Modul (Verdrahtung wie inetbox2mqtt, LEDs 4/15) | 17 / 16 | ESP32 Dev Module |
| `BOARD_ESP32S3_GENERIC` | ESP32-S3 + LIN-Modul | 17 / 18 | ESP32S3 Dev Module |
| `BOARD_ESP32C3_GENERIC` | ESP32-C3 + LIN-Modul | 21 / 20 | ESP32C3 Dev Module |

Pins lassen sich im jeweiligen Block in `config.h` anpassen. Optional: `LIN_CS_PIN` (Enable/SLP des Transceivers), `LIN_FAULT_PIN`, `MQTT_LED_PIN`, `LIN_LED_PIN`.

**Verdrahtung, Bus-Anschluss, Pins und Fallstricke: siehe [HARDWARE.md](HARDWARE.md).**

## Arduino IDE einrichten

> **Eigene Passwörter, WLAN und Broker:** `config_local.h.example` im Sketch-Ordner nach `config_local.h` kopieren und anpassen. Die Datei geht nicht nach GitHub. Details in der [Haupt-README](../../README.md#eigene-einstellungen-config_localh).

1. Boardverwalter: **esp32 von Espressif, Version 3.x** (kompiliert mit 3.3).
2. Bibliotheken über den Bibliotheksverwalter installieren:
   - **PubSubClient** (Nick O'Leary)
   - **ArduinoJson** (Benoit Blanchon), Version 7.x
   - **ESP Async WebServer** (ESP32Async)
   - **Async TCP** (ESP32Async)
3. Ordner `truma_heater` öffnen (`truma_heater.ino`).
4. Board wählen (siehe Tabelle), **Partition Scheme: „Minimal SPIFFS (1.9MB APP with OTA)“** – lässt Platz für künftige Updates über die Weboberfläche.
5. Hochladen. Serieller Monitor: 115200 Baud.

Spätere Updates gehen ohne USB: In der Arduino IDE *Sketch → Kompilierte Binärdatei exportieren*, dann die `.bin` in der Weboberfläche unter **System → Firmware-Update** hochladen.

## Inbetriebnahme

1. Nach dem ersten Start öffnet der ESP den Access Point **`heater-node-XXXX`** (Passwort `truma1234`). Verbinden, die Seite öffnet sich automatisch (sonst `http://192.168.4.1`).
2. Im Reiter **WiFi** WLAN (optional feste IP) eintragen → **Speichern & Verbinden**, danach im Reiter **MQTT** den Broker → **Speichern**. Der ESP32 kann nur **2,4-GHz-WLAN**.
   - Der Access Point läuft nur, solange kein WLAN eingerichtet ist oder das WLAN 60 s nicht erreichbar ist (Reiter **WiFi**: Name, Passwort und „Access Point immer an“ einstellbar). Im Notfall-Modus versucht der ESP alle 30 s für 10 s das WLAN, aber nie, solange ein Handy am Access Point hängt.
   - Bricht das WLAN oft ab: im Reiter **WiFi** die Sendeleistung auf 8,5 dBm stellen. Dort stehen auch Abbrüche, letzter Abbruchgrund und der Grund des letzten Neustarts.
3. ESP am LIN-Bus anschließen (RJ12-Verteiler zwischen CP Plus und Heizung, siehe [HARDWARE.md](HARDWARE.md)).
4. **Am CP Plus anmelden** (einmalig): Einstellungen → **RESET** → **PR SET** bestätigen. Das Display zeigt „INIT…“ und startet neu. Unter **INDEX** steht danach ein dritter Eintrag **T23.70.0**.
   - War vorher eine echte iNet Box angemeldet: zuerst ohne iNet Box einmal INIT ausführen, dann mit diesem Gerät.
5. Im Reiter **System** unter **Heizung** das Modell wählen (siehe [Heizungsmodell](#heizungsmodell)).
6. In der Weboberfläche muss **„CP Plus verbunden“** grün sein. Nach ca. 30 s kommt der erste Heizungsstatus; die Uhrzeit wird dann automatisch per NTP ans CP Plus übertragen (und einmal täglich).

## Weboberfläche

Aufbau und Optik wie bei [tanklevel-node](../tanklevel): Heizung, Timer, MQTT, WiFi, System.

| Heizung | Timer | WiFi |
| --- | --- | --- |
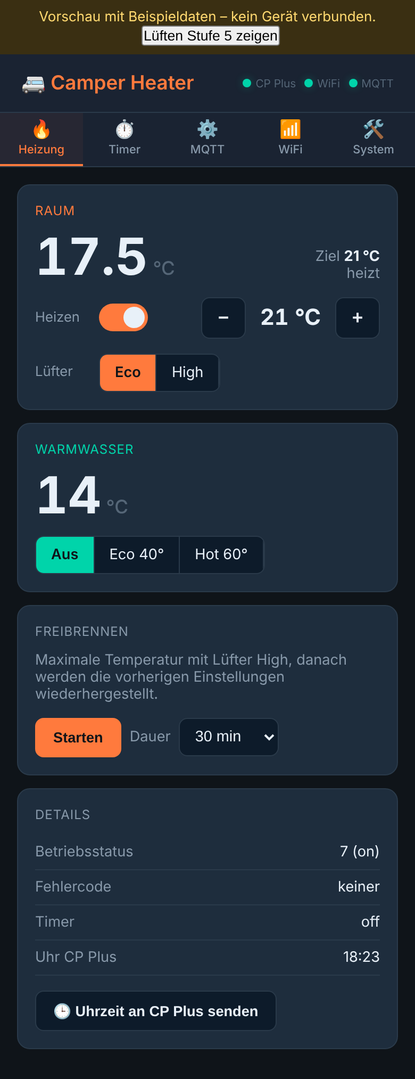
[picture p18: firmware/heater/docs/mockup/ui-heat.png]
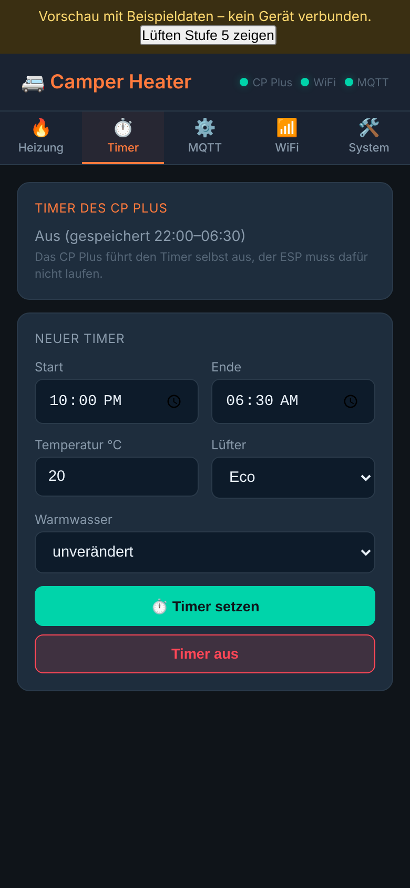
[picture p19: firmware/heater/docs/mockup/ui-timer.png]
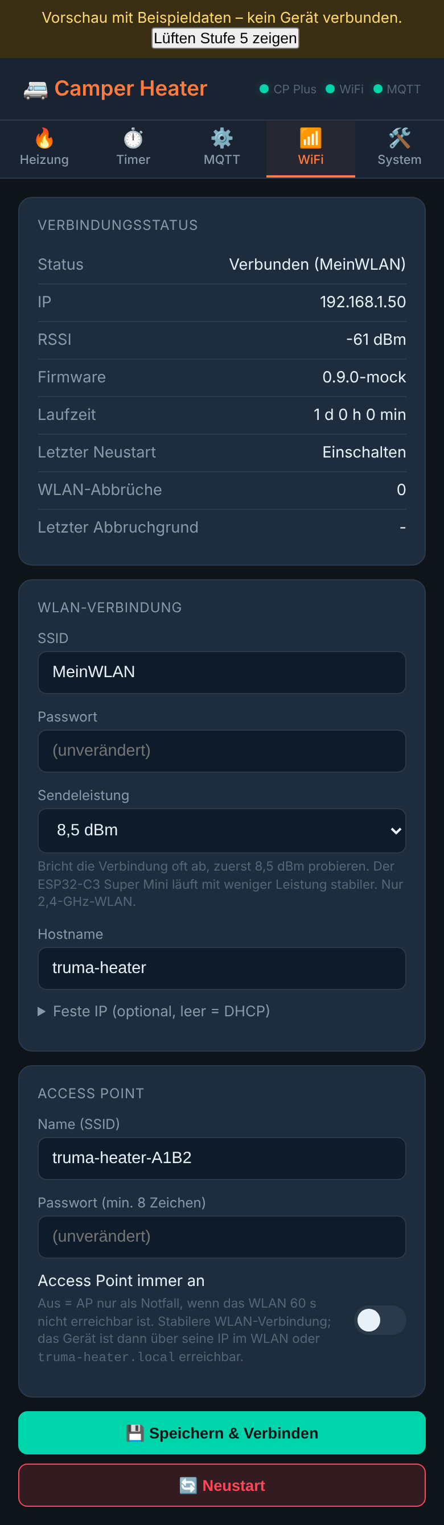
[picture p20: firmware/heater/docs/mockup/ui-wifi.png]
|  |  |  |

| MQTT | System |
| --- | --- |
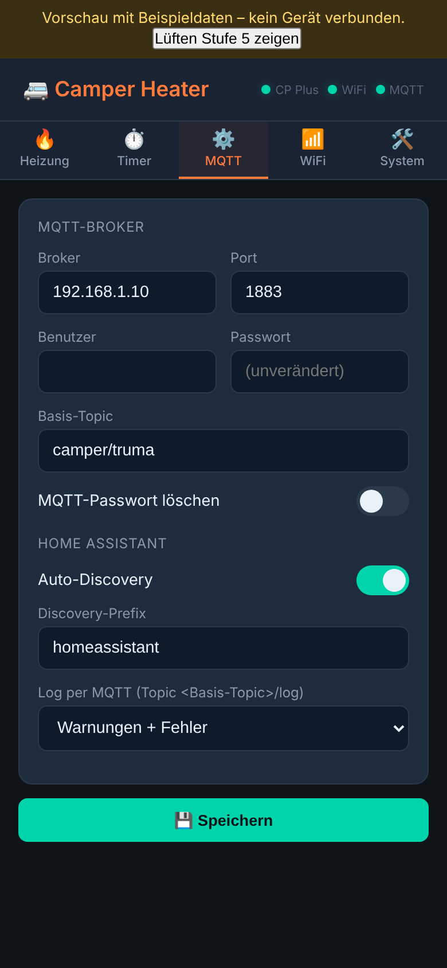
[picture p21: firmware/heater/docs/mockup/ui-mqtt.png]
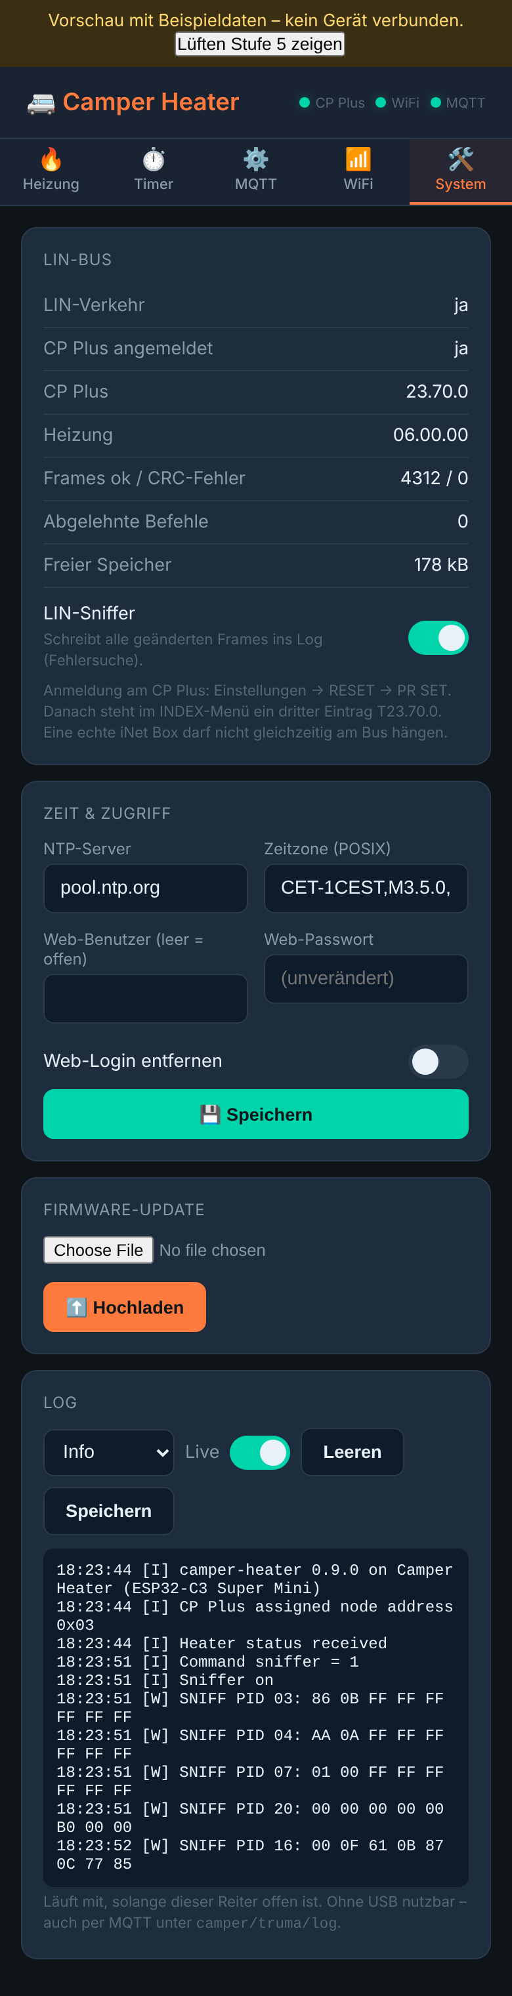
[picture p22: firmware/heater/docs/mockup/ui-sys.png]
|  |  |

Jeder Reiter speichert nur seine eigenen Felder, danach startet das Gerät neu. Leere Passwortfelder behalten den gespeicherten Wert.

Zum Ausprobieren ohne Gerät: [`docs/mockup/truma-heater-mockup.html`](docs/mockup/truma-heater-mockup.html) herunterladen und im Browser öffnen. Das ist die echte Oberfläche aus der Firmware mit simulierten Daten; Knöpfe, Timer, Freibrennen und Sniffer reagieren. Nach Änderungen an `web_ui.h` neu erzeugen mit `python3 docs/gen_mockup.py` (nur Standardbibliothek). Dieselbe Seite steht zusammen mit allen anderen Geräten unter [`docs/mockups/`](../../docs/mockups/index.html).

## MQTT

Basis-Topic standardmäßig `camper/heater` (in den Einstellungen änderbar; bis Version 1.0 war es `service/truma`, bestehende Geräte behalten ihre Einstellung). Zustände werden **retained** veröffentlicht, Änderungen innerhalb einer Sekunde, alles einmal pro Minute.

### Status `camper/heater/control_status/<key>`

| Key | Werte | Bedeutung |
|---|---|---|
| `alive` | ON / OFF | CP Plus fragt dieses Gerät ab |
| `current_temp_room` | °C | Raumtemperatur |
| `target_temp_room` | 0, 5–30 | Raum-Zieltemperatur (0 = aus) |
| `heating_mode` | off / eco / high | Lüfterstufe |
| `current_temp_water` | °C | Wassertemperatur |
| `target_temp_water` | 0 / 40 / 60 / 200 | Warmwasser aus / eco / hot / boost |
| `water_mode` | off / eco / high | wie oben als Text |
| `energy_mix` | gas / mix / electricity | Energiequelle (Diesel = gas) |
| `el_power_level` | 0 / 900 / 1800 | Elektroleistung |
| `operating_status` | 0–9 | 0/1 aus, 4 Start/Nachlauf, ≥5 läuft |
| `operating_status_text` | Text | |
| `error_code` | Zahl | Fehlercode wie am CP Plus, ohne E/W und H (z. B. `212` für E212), 0 = keiner. Berechnung wie in inetbox.py, inetbox2mqtt und ESPHome. Kurz nach dem Start des CP Plus kommt `255` (im WomoLIN-Mitschnitt zu sehen). Bedeutung siehe Anleitung der Heizung |
| `heater_error` | ON / OFF | Fehler oder Warnung aktiv (jeder Code ≠ 0) |
| `clock` | hh:mm | Uhrzeit des CP Plus |
| `vent_level` | 0–10 | Lüftungsstufe (0 = kein Lüften). Nur bei Heizungen, die den LIN-Frame 0x20 nutzen, sonst nicht gesendet |
| `vent_mode` | off / 1–10 / eco / high | Rohwert dazu (eco/high = Lüfter beim Heizen) |
| `timer`, `timer_active` | hh:mm-hh:mm / off, ON/OFF | Timer des CP Plus |
| `timer_times`, `timer_temp_room`, `timer_heating_mode`, `timer_water_mode` | hh:mm-hh:mm, °C, eco/high, off/eco/high | Gespeicherte Timer-Einstellungen (auch bei Timer aus) |
| `hvac_mode`, `hvac_action`, `room_setpoint`, `fan_mode` | | für den HA-Thermostat; `hvac_action` = `fan`, wenn die Heizung ohne Raum- und Wasserheizung läuft (Lüften am CP Plus oder Nachlauf) |
| `decoke`, `decoke_remaining`, `decoke_minutes` | ON/OFF, min, min | Freibrennen |
| `heater_model` | combi / combi_e / combi_d / combi_d_e / vario | gewähltes Heizungsmodell |
| `energy_select` | gas / mix_900 / mix_1800 / electricity_900 / electricity_1800 | Energie als ein Wert (nur E-Modelle) |
| `cpplus_version`, `heater_version`, `release`, `rssi`, `lin_traffic` | | Diagnose |

Verfügbarkeit: `camper/heater/status` = `online` / `offline` (Last Will).
Diagnose: `camper/heater/info` (retained, beim Verbinden und jede Minute) – JSON mit `version`, `ip`, `mac`, `rssi`, `uptime` (s), `reset` (Grund des letzten Neustarts), `heap`.

### Befehle `camper/heater/set/<key>`

| Key | Payload | Wirkung |
|---|---|---|
| `target_temp_room` | 0, 5–30 | 0 = Raumheizung aus, sonst einschalten mit dieser Temperatur |
| `heating_mode` | off / eco / high | Lüfterstufe; schaltet bei Bedarf ein (letzte Temperatur) |
| `target_temp_water` | 0 / 40 / 60 | Warmwasser |
| `water_mode` | off / eco / high | Warmwasser |
| `hvac_mode` | heat / off | Raumheizung an/aus mit letzter Temperatur + Lüfterstufe |
| `room_setpoint` | 5–30 | Solltemperatur; bei ausgeschalteter Heizung nur gemerkt |
| `fan_mode` | eco / high (Gas-Combi auch boost, VarioHeat night / auto / boost) | Lüfterstufe; bei ausgeschalteter Heizung nur gemerkt |
| `energy_mix` / `el_power_level` | gas / mix / electricity, 0 / 900 / 1800 | nur bei E-Modellen |
| `energy_select` | gas / mix_900 / … / electricity_1800 | Energie und Leistung in einem Befehl (nur E-Modelle) |
| `heater_model` | combi / combi_e / combi_d / combi_d_e / vario | Heizungsmodell umstellen (sofort wirksam) |
| `decoke` | ON / OFF | Freibrennen starten / beenden |
| `decoke_minutes` | 5–120 | Dauer des Freibrennens |
| `sync_clock` | 1 | Uhrzeit sofort ans CP Plus senden |
| `timer` | `22:00-06:30[,temp[,eco/high[,off/eco/high]]]`, `on`, `off` | Timer setzen. Fehlende Werte: bisherige Timer-Werte, sonst gemerkte Solltemperatur und Lüfterstufe. Warmwasser ohne Angabe bleibt unverändert |
| `timer_active` | ON/OFF | Timer mit den gespeicherten Zeiten ein- oder ausschalten |
| `sniffer` | ON / OFF | LIN-Sniffer (Diagnose, siehe unten), nach Neustart aus |
| `reboot` | 1 | Neustart |

Anders als bei inetbox2mqtt muss Temperatur und Lüfterstufe nicht gemeinsam gesendet werden – fehlende Werte werden sinnvoll ergänzt.

Beispiel:
```
mosquitto_pub -h <broker> -t camper/heater/set/target_temp_room -m 21
mosquitto_pub -h <broker> -t camper/heater/set/heating_mode -m high
mosquitto_sub -h <broker> -t 'camper/heater/control_status/#' -v
```

### Home Assistant

Mit aktivierter Auto-Discovery erscheint ein Gerät **„Truma Heater“** mit Thermostat (Aus/Heizen, Solltemperatur, Lüfterstufen je nach Modell), Warmwasser-Auswahl, Energie-Auswahl (E-Modelle), Modellauswahl, Timer (Textfeld `22:00-06:30,20,eco` plus Ein/Aus-Schalter), Freibrennen-Schalter, Sensoren und Diagnose. Die Heizungs-Entitäten sind nur verfügbar, wenn der ESP online ist **und** das CP Plus ihn abfragt.

## Timer

Der Timer des CP Plus lässt sich per MQTT (`set/timer`), in Home Assistant und in der Weboberfläche setzen: Start, Ende, Raumtemperatur, Lüfterstufe und optional Warmwasser. Das CP Plus führt den Timer selbst aus, der ESP muss dafür nicht laufen. Das Frame (Typ 0x3C, 18 Byte) ist gegen Community-Mitschnitte einer Original-iNet-Box (Timer per Truma-App setzen, ändern, ausschalten) geprüft und byte-gleich; esphome-truma_inetbox schickt 17 Byte, inetbox.py 24 Byte. Mit einer Diesel-Heizung noch nicht am Bus getestet.

## Freibrennen (Diesel)

Setzt 30 °C mit Lüfter **high** (Boost gibt es beim Diesel nicht) für die eingestellte Dauer und stellt danach die vorherigen Einstellungen wieder her. Wird während des Freibrennens am CP Plus oder per MQTT etwas geändert, endet es ohne Wiederherstellung.

## Heizungsmodell

Nicht jede Truma kann alles. Das gewählte Modell bestimmt, was Weboberfläche und Home Assistant anbieten:

| Modell (`key`) | Lüfter | Warmwasser | Energie | Freibrennen |
|---|---|---|---|---|
| Combi 4/6, Gas (`combi`) | Eco / High / Boost | Aus / Eco / Hot / Boost | – | – |
| Combi 4/6 E, Gas + 230 V (`combi_e`) | Eco / High / Boost | Aus / Eco / Hot / Boost | Gas / Mix 900·1800 / Elektro 900·1800 | – |
| Combi D 4/6, Diesel (`combi_d`, Standard) | Eco / High | Aus / Eco / Hot | – | ja |
| Combi D 6 E, Diesel + 230 V (`combi_d_e`) | Eco / High | Aus / Eco / Hot | Diesel / Mix / Elektro | ja |
| VarioHeat (`vario`) | Nacht / Auto / Boost | keins | – | – |

- **Einstellen:** Weboberfläche → **System** → **Heizung**, in Home Assistant die Auswahl „Heater model“ (Konfiguration) oder per MQTT `set/heater_model`. Die Änderung wirkt sofort, ohne Neustart: Knöpfe, Timer-Auswahl und die Home-Assistant-Entitäten passen sich an, nicht mehr passende Entitäten werden in HA entfernt.
- **Vorgabe ab Werk:** `DEFAULT_HEATER_MODEL` in `config.h` oder besser in `config_local.h`, z. B. `#define DEFAULT_HEATER_MODEL "combi_e"`. Gilt, solange im Gerät noch kein Modell gespeichert ist (erster Start, „Erase All Flash“).
- **Plausibilität:** Das CP Plus meldet beim Anmelden die Heizungsfamilie (Combi 4, Combi 6 / D 6, VarioHeat). Passt die Auswahl offensichtlich nicht (VarioHeat ↔ Combi), erscheint ein Hinweis auf der Startseite. Gas oder Diesel und die E-Variante meldet das CP Plus nicht, die muss man selbst wählen.
- Die früheren Schalter `HEATER_SUPPORTS_BOOST`, `WATER_SUPPORTS_BOOST` und `HEATER_HAS_ELECTRIC` gibt es nicht mehr. Stehen sie noch in einer alten `config_local.h`, wird daraus das passende Standardmodell.

## Geräteoptionen

In `config.h`:

- `DEFAULT_HEATER_MODEL` – Heizungsmodell ab Werk (siehe oben), Standard `combi_d`
- `LIN_OBSERVER_MODE` – nur mithören, nie antworten (Fehlersuche)

**Eigene Werte ohne `config.h` zu ändern:** `truma_heater/config_local.h.example` nach `truma_heater/config_local.h` kopieren und dort z. B. ein eigenes AP-Passwort (`DEFAULT_AP_PASSWORD`) oder die Board-Auswahl eintragen. Die Datei wird automatisch eingebunden, von Git ignoriert und von Patches nie angefasst. Auch WLAN, Broker und Web-Login ab Werk lassen sich dort eintragen; sie gelten, solange im Gerät noch nichts gespeichert ist (erster Start, Werkseinstellungen, „Erase All Flash“).

## Fehlersuche

Weboberfläche → **System**:

- **LIN-Verkehr: nein** → Verkabelung, TX/RX vertauscht, 12 V am Transceiver, gemeinsame Masse.
- **LIN-Verkehr ja, CP Plus angemeldet: nein** → am CP Plus RESET → PR SET ausführen.
- **CRC-Fehler steigen ständig** → Störungen oder falsche Baudrate; Masse prüfen.
- **Abgelehnte Befehle** → das CP Plus hat eine Änderung abgelehnt (z. B. nicht unterstützter Modus).
- **smartavan-Board läuft an USB, aber nicht an 12–14 V** → das ist ein Hardware-Problem (Spannungsregler / Versorgung), keine Firmware-Frage. 3,3 V am ESP bei 12-V-Betrieb messen, auch während WLAN sendet.

## LIN-Diagnose

Wird die Heizung nicht erkannt, sagt das Log alle 10 Sekunden, woran es liegt. Dieselbe Zeile steht im Web-UI unter *LIN-Bus*:

| Meldung | Bedeutung | Was tun |
| --- | --- | --- |
| Kein Signal am RX-Pin | In 10 s kam kein einziges Byte an | LIN-Ader und Masse messen, 12 V an der 12V-Klemme des LIN-Moduls, SLP/EN auf HIGH (3,3 V oder `LIN_CS_PIN`), RX-Pin im Board-Profil |
| Bytes, aber keine LIN-Frames | Es kommt etwas an, aber nichts, was nach LIN aussieht | TX/RX vertauscht, falscher Pin, Störung. Die ersten Bytes stehen in der Meldung |
| LIN-Frames, aber keine Anfrage an eine iNet Box | CP Plus und Heizung reden, das CP Plus kennt die iNet Box aber nicht | Am CP Plus *Einstellungen → RESET → PR SET* |
| CP Plus fragt, Anmeldung noch nicht fertig | Die Anmeldung läuft | Warten, ggf. PR SET wiederholen |
| LIN ok | Alles in Ordnung | – (diese Meldung kommt nur alle 5 Minuten) |

Problem-Meldungen sind Warnungen und landen ohne Umstellen im Web-Log und im MQTT-Log. Mit dem Schalter **LIN-Rohdaten (60 s)** im Web-UI schreibt die Firmware zusätzlich jedes empfangene Byte als Hex ins Log (`RAW 00 55 20 …`), danach schaltet sie das selbst wieder ab.

## LIN-Sniffer

Zum Erforschen des Busses: Der Sniffer schreibt jeden Frame der übrigen PIDs (alles außer dem iNet-Box-Verkehr 0x18/0x3C/0x3D) ins Log, aber nur, wenn sich sein Inhalt ändert. Nach dem Einschalten kommt jeder PID einmal. Die Zeilen sind Warnungen (`SNIFF PID 07: 01 00 FF FF FF FF FF FF`), damit sie ohne Umstellen im Web-Log und im MQTT-Log landen.

Einschalten: Weboberfläche → **System → LIN-Sniffer** oder MQTT `set/sniffer` = `ON`. Nach einem Neustart ist er aus.

Bekannt aus den WomoLIN-Mitschnitten (CP Plus + Combi D6 E): PID 0x03 Soll-Raumtemperatur, 0x04 Soll-Wassertemperatur, 0x07 Lüfter (`01` eco, `02` high), 0x16 Ist-Werte (ändert sich ständig).

**Lüftungsstufe suchen:** Sniffer an, am CP Plus Lüften Stufe 1 → 5 → 10 → aus schalten, jeweils ~20 s warten und die Uhrzeit notieren. Danach das Log speichern (System → Log → Speichern).

## Logs ohne USB

- **Weboberfläche → System → Log:** läuft live mit (alle 2 s), solange der Reiter offen ist. Log-Level wählbar, Ausgabe lässt sich leeren und als Textdatei speichern.
- **MQTT:** Logzeilen gehen auf `camper/heater/log` (nicht retained). Standard: Warnungen und Fehler. Einstellbar im Reiter **MQTT → Log per MQTT** (Aus / Fehler / Warnungen / Info / Debug). In Home Assistant erscheint die letzte Meldung als Diagnose-Sensor.
- **Seriell (115200 Baud):** nur am Schreibtisch, siehe Hinweis zu USB in [HARDWARE.md](HARDWARE.md).

Zeitstempel sind Uhrzeit (sobald NTP synchronisiert ist), davor Sekunden seit Start (`+12s`).

## Web-Oberfläche

Die Seite liegt lesbar in `truma_heater/web/index.html` und wird in die Firmware eingebettet (keine Datei-Upload nötig). Nach Änderungen:

```bash
python3 tools/common/sync_common.py          # gemeinsames Design (camper-theme.css) einfügen
python3 firmware/heater/tools/embed_web.py   # web/index.html -> web_ui.h
python3 firmware/heater/docs/gen_mockup.py   # Mockup aktualisieren
```

CI prüft mit `embed_web.py --check`, dass `web_ui.h` zur Seite passt. Seit 1.5.1 im gemeinsamen Design aller VanNode-Geräte.

## Aufbau des Codes

```
truma_heater/
├── truma_heater.ino     Setup und Hauptschleife
├── config.h             Board-Auswahl, Pins, Geräteoptionen
├── truma_protocol.h     Truma-Frames, Enums, Hilfsfunktionen
├── inetbox.h / .cpp     LIN-Slave + iNet-Box-Protokoll (eigener FreeRTOS-Task)
├── heater_control.*     Sollwert-/Lüfter-Speicher, Freibrennen, Befehlslogik, Modellauswahl
├── heater_model.h       Tabelle der Heizungsmodelle (was welches Modell kann)
├── mqtt_ha.*            MQTT-Topics + Home-Assistant-Discovery
├── webserver.*          Weboberfläche, REST-API, OTA
├── web_ui.h             HTML der Weboberfläche
├── wifi_manager.*       WLAN, feste IP, Setup-AP
├── settings.*           Einstellungen im NVS
└── logger.*             Log über Serial + Puffer für die Weboberfläche
docs/
├── schaltplan*, lochraster*, wiring_*   Schaltpläne und Lochraster-Layouts (+ Generator-Skripte)
├── mockup/              klickbares Mockup der Weboberfläche + Screenshots
└── gen_mockup.py        erzeugt das Mockup aus web_ui.h
tests/                   Host-Tests und Replay der LIN-Mitschnitte (siehe tests/README.md)
```

Der LIN-Teil läuft in einem eigenen Task mit hoher Priorität, damit Antworten an das CP Plus rechtzeitig (wenige Millisekunden) rausgehen – unabhängig von WLAN, MQTT und Weboberfläche.

## Sicheres Update, Ereignisse und Rückfall

Seit 1.4.0 hat jede Firmware eine Kennung (`CAMPER-FW:heater:<version>:<chip>;`) und dieselbe Absicherung wie alle VanNode-Geräte (`fwcheck.*`, `evlog.*`, `safeguard.*` aus `firmware/_common`):

- **Prüfung beim Update** (Web-UI unter **System → Firmware-Update**): Die installierte Version steht dabei. Eine gewählte Datei wird schon im Browser und beim Hochladen im Gerät noch einmal geprüft, bevor etwas aktiviert wird. Abgelehnt werden eine `.merged.bin` (komplettes Flash-Abbild für USB), Firmware für ein anderes Gerät oder einen anderen Chip und zu große Dateien. Eine Datei ohne Kennung (Version vor 1.4.0) geht nur mit „Ohne Kennung hochladen“. Fehler stehen im Klartext da statt „Update failed“.
- **Ereignisse:** Die letzten Ereignisse (Start mit Grund, WLAN und MQTT verbunden/getrennt, Uploads mit Ergebnis, Rückfall, gespeicherte Einstellungen) stehen in der Web-Oberfläche. Sie bleiben bei Neustart, Absturz und Update erhalten, nach einem Stromausfall ist das Log leer.
- **Rückfall nach Update:** Hat eine neue Firmware nach 5 Minuten kein WLAN oder startet sie mehr als dreimal neu, startet wieder die vorherige. Kam das Update über den Setup-AP (ohne WLAN), wird nur auf Neustart-Schleifen geachtet.
- **WLAN-Änderung mit Rückweg:** Werden die WLAN-Daten geändert, während das Gerät verbunden ist, merkt es sich die funktionierenden. Klappt die Verbindung mit den neuen nach dem Neustart etwa 1 Minute lang nicht, kommen die alten zurück.
- Der ausführliche Laufzeit-Log (LIN-Verkehr usw.) bleibt unter „Log“; die Ereignisse sind die kurze Liste darüber, die einen Neustart übersteht.

## Status

- Kompiliert mit Arduino-ESP32 3.x für ESP32, ESP32-S3 und ESP32-C3.
- LIN/iNet-Box-Protokoll am PC gegen echte Beispiel-Frames simuliert (Anmeldung, INIT, Status, Befehl).
- Gegen **echte Mitschnitte** eines CP Plus mit Combi D6 E und Original-iNet-Box geprüft (WomoLIN-Captures): 29 Mitschnitte, rund 6.900 Frames, alle fehlerfrei gelesen. Für alle 14 Befehle aus der Truma-App (13–22 °C, Lüfter eco/high, Heizung ein/aus) ist unser Heizungsbefehl im Inhalt byte-gleich mit dem der Original-iNet-Box. Siehe [tests/](tests/README.md).
- Zusätzlich 15 Community-Mitschnitte (ESPHome-Observer: Lüften Stufe 1–10, Klima AUTO, Timer Heizung/Klima per App und CP Plus, Uhrzeit) fehlerfrei gelesen.
- **Reines Lüften** (am CP Plus, Stufe 1–10) ist über die iNet-Box-Schnittstelle nicht steuerbar. Die Stufe steht nicht in den iNet-Box-Frames (dort nur „Heizung läuft“ → `hvac_action = fan`), aber bei manchen Heizungen im Frame CP Plus → Heizung (PID 0x20). Daraus liest die Firmware `vent_level` mit – in der Community an einer Combi (Gas) mit dem ESPHome-Sensor VENT_MODE für Stufe 1–10 bestätigt. Die Combi D6 E aus den WomoLIN-Mitschnitten nutzt PID 0x20 nicht; ob die eigene Heizung ihn schickt, zeigt der Sniffer.
- Timer setzen: unser Frame ist für Setzen (mit/ohne Warmwasser) und Ausschalten byte-gleich mit dem der Original-iNet-Box (Community-Mitschnitt, Truma-App).
- Uhrzeit: Die Original-iNet-Box stellt die Uhr nie selbst; das CP Plus meldet Änderungen sofort. Unser NTP-Uhrzeit-Setzen (Frame 0x14) ist nur gegen ESPHome geprüft.
- **Am echten LIN-Bus noch nicht getestet.**

## Fertige Firmware

Wird im Haupt-Repo per GitHub Actions gebaut, siehe [Fertige Firmware](../../README.md#fertige-firmware).

## Lizenz

GPL-3.0, siehe [LICENSE](LICENSE). Die Protokoll-Logik ist aus [skrebber/esphome-truma_inetbox](https://github.com/skrebber/esphome-truma_inetbox) (GPL-3.0, Fork von Fabian-Schmidt/esphome-truma_inetbox) portiert, das Setzen des Timers aus [havanti/esphome-truma](https://github.com/havanti/esphome-truma).
