hflocki/camper-mqtt/docs/mockups/design/home-desktop.html

# Übersicht

MQTT 9 von 10 Geräten 13:45

Aufbau BMS: Ladezustand zu hoch (Stufe 1) seit 14:02 · per Pushover gemeldet

Alle Warnungen

## Tanks

Frischwasser

68 %

68 L von 100 L

Grauwasser

31 %

25 L von 80 L

Gas

57 %

6,3 L · Flasche 11 kg

## Klima

Heizung

18,7 °C Heizt · Soll 21 °C

MaxxFan

Stufe 3 Auto-Hold aus

Dachhaube

Offen 40 % Bluetooth verbunden

Wetter

14 °C Bewölkt · Böen 32 km/h

Temperaturen

5,1° Kühlschrank

−17,9° Gefrierfach

18,3° Innen

19,4° Außen

4 Sensoren · Alarm bei Kühlschrank über 8 °C

## Energie

Aufbaubatterie

74 %

▲ 90 W · lädt · voll in 2,5 h

Starterbatterie

12,6 V Ruhespannung OK

## Fahrzeug

Level

Eben Längs 0,2° · Quer 0,4°

Türen & Fenster

2 offen Tür, Fenster Küche

Licht

1 an LED Eingang

Schalter

1 an Steckdose Kühlbox
