hflocki/camper-mqtt/docs/mockups/design/settings-desktop.html

# Einstellungen

Anzeige Helligkeit, Dimmen, Name Home & Seiten Kacheln, Seiten, Symbolleiste Geräte & Topics Basis-Topics, Links, Topic-Finder Sensoren Zigbee & Bluetooth Automationen Regeln: wenn … dann … Benachrichtigungen Pushover, Dringlichkeit Warnungen Grenzwerte, Abfahrtscheck Wetter Ort, Böen, Aktualisierung Netzwerk WLAN, MQTT-Broker System Update, Sichern, Neustart

## Benachrichtigungen

Warnungen per Pushover aufs Handy. Eine Warnung wird gesendet, wenn sie 30 s besteht.

Warnungen senden

Nachricht, wenn eine Warnung vorbei ist „✓ Erledigt: …“, leise

API-Token

User-Key

Standard-Priorität gilt für alle Arten auf „Standard“

Leise Normal Hoch Notfall

### Dringlichkeit je Warnungsart

Notfall klingelt, bis du ihn in der App bestätigst · Aus = nur am Display

Kühlschrank / Temperatur Notfall

Heizung Hoch

Batterie Hoch

Frischwasser Standard

Gas Hoch

Frost Hoch

Wetter / Markise Hoch

Abfahrtscheck Hoch

Eigene Kacheln Standard

Regeln Standard

Kontakte Aus

Notfall wiederholen

alle300s

höchstens60min

Testnachricht senden Zuletzt OK um 14:02

2 Änderungen nicht gespeichert Verwerfen Speichern
