hflocki/camper-mqtt/docs/mockups/design/device-phone.html

# Tanklevel Node

tanklevel-node · 1.9.0

WLAN −58 dBm MQTT Bluetooth

Live Einstellungen System

Frischwasser

68 %

68,0 L von 100 L

Grauwasser

31 %

24,8 L von 80 L

Gas

57 %

6,3 L · Sensor-Batterie 88 %

## Messwerte

Frischwasser · Spannung 1,764 V

Grauwasser · Spannung 0,813 V

Gas · Rohwert 57 %

Gas · Bluetooth −71 dBm

Gas · letzter Wert vor 4 s

Laufzeit 3 T 4 h

## Ereignisse

Update auf 1.8.1, Prüfung bestanden 02.11. 18:40

MQTT neu verbunden 02.11. 18:41

Gas-Sensor 2 min nicht erreichbar 03.11. 07:12

Gleiche Kacheln, Chips, Listen und Tabs wie am Display – jedes Gerät sieht so aus.
