hflocki/camper-mqtt/docs/mockups/design/home-phone.html

# Übersicht

Camper · 9 von 10 Geräten online

13:45

Aufbau BMS: Ladezustand zu hoch seit 14:02 · Tippen für Details

## Tanks

Frischwasser

68 %

68 L von 100 L

Gas

57 %

6,3 L

Grauwasser

31 %

25 L von 80 L

Aufbaubatterie

74 %

▲ 90 W · lädt

## Klima

Temperaturen

5,1° Kühlschr.

−17,9° Gefrierf.

18,3° Innen

19,4° Außen

Alarm bei Kühlschrank über 8 °C

Heizung

18,7 °C Heizt · Soll 21 °C

Wetter

14 °C Bewölkt · Böen 32

MaxxFan

Stufe 3 Auto-Hold aus

Dachhaube

40 % offen

## Fahrzeug

Level

Eben Längs 0,2° · Quer 0,4°

Türen & Fenster

2 offen Tür, Fenster Küche

Licht

1 an LED Eingang

Schalter

1 an Steckdose Kühlbox
