hflocki/camper-mqtt/docs/mockups/design/system.html

VanNode · Designsystem · Entwurf 1

# Ruhig, technisch, überall gleich

Werte zuerst. Groß, ruhig, mit festen Ziffernbreiten. Alles andere tritt zurück.

Farbe heißt Zustand. Grün, Gelb, Rot nur für OK, Hinweis, Fehler. Blau nur für Bedienung.

Ein Baukasten. Display, Handy und jedes Gerät nutzen dieselben Bausteine.

## Flächen und Text

Grund

#0D1115 · Seite

Fläche

#151B21 · Karten

Fläche hoch

#1C242C · Kacheln

Linie

#26303A · Trenner

Text

#E7ECF0 · Werte

Text leise

#8B98A5 · Nebenzeilen

## Zustand und Bedienung

OK

#46B97C

Hinweis

#E5A23B

Fehler

#E5534B

Bedienung

#4DA3F0

Bereichsfarben (Wasser, Gas, Heizung …) gibt es nur noch im Symbol und im Füllbalken, nie im Text. Ein Wert wird nur farbig, wenn er einen Zustand meldet.

Wasser

Grauwasser

Gas

Heizung

Energie

Klima

## Schrift

Systemschrift des Geräts – läuft ohne Internet, nichts zu laden

68 % Wert groß · 40 / 600

18,7 °C Wert · 28 / 600

Einstellungen Seitentitel · 20 / 600

Tanks Abschnitt · 15 / 600

Neue Warnung schaltet das Display ein Text · 15 / 400

An, Soll 21 °C Nebenzeile · 13 / 400

camper/toolbox/rvtech/cover Topic · Mono 13

## Symbole

Ein Strich-Set als SVG für alle Geräte statt Emojis – sieht auf jedem Handy gleich aus

Wasser

Gas

Temperatur

Batterie

Lüfter

Dachhaube

Level

Licht

Schalter

Tür

Wetter

Warnung

Home

Einstellen

Netz

Ein/Aus

System

Update

## Bausteine

Kachel · immer gleich aufgebaut

Frischwasser

68 %

68 L von 100 L

Symbol + Name + Statuspunkt · Wert · optional Balken · eine Nebenzeile

Status in der Kopfzeile

MQTT 9 von 10 Geräten 1 Warnung

Umschalter

Aus Eco Hoch

Einstellungszeile · Beschriftung links, Bedienung rechts

Warnungen senden

Ruhezeit

min

Schalter statt Häkchen, Einheit im Feld statt in der Beschriftung

Knöpfe

Speichern Testnachricht Werkseinstellungen

Mindestens 44 px hoch · ein Hauptknopf pro Ansicht

Abstände im 4er-Raster: 4 · 8 · 12 · 16 · 24 · 32. Kacheln 12 px Abstand, Abschnitte 32.

Ecken: Kacheln 14 px, Eingaben und Knöpfe 10 px, Chips rund.

Umsetzung: eine gemeinsame camper.css + Symbol-Sprite in firmware/_common, von sync_common in alle Geräte kopiert.
