hflocki/camper-mqtt/display-2.0-warnung.png

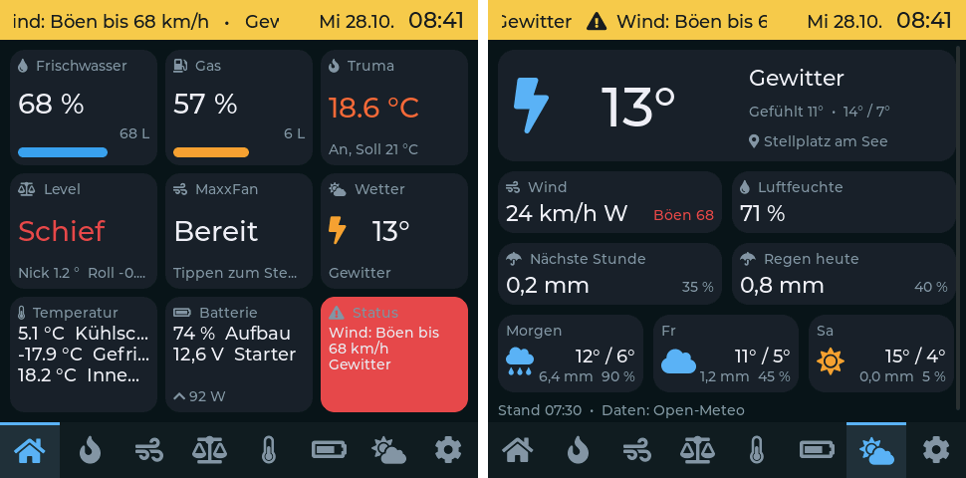
display-2.0-warnung.png
