hflocki/camper-mqtt/firmware/display/docs/web-einstellungen.png

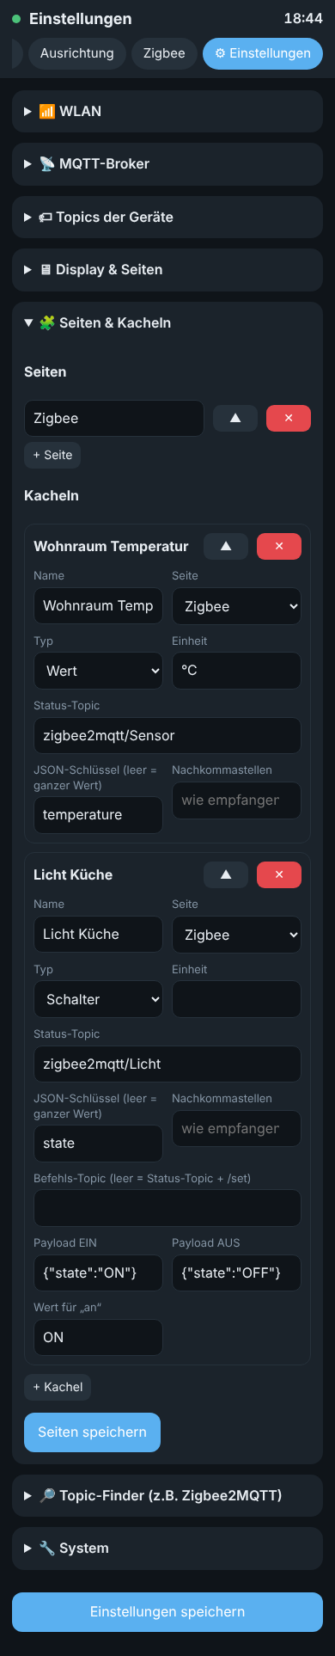
firmware/display/docs/web-einstellungen.png
