hflocki/camper-mqtt/firmware/heater/docs/lochraster.png

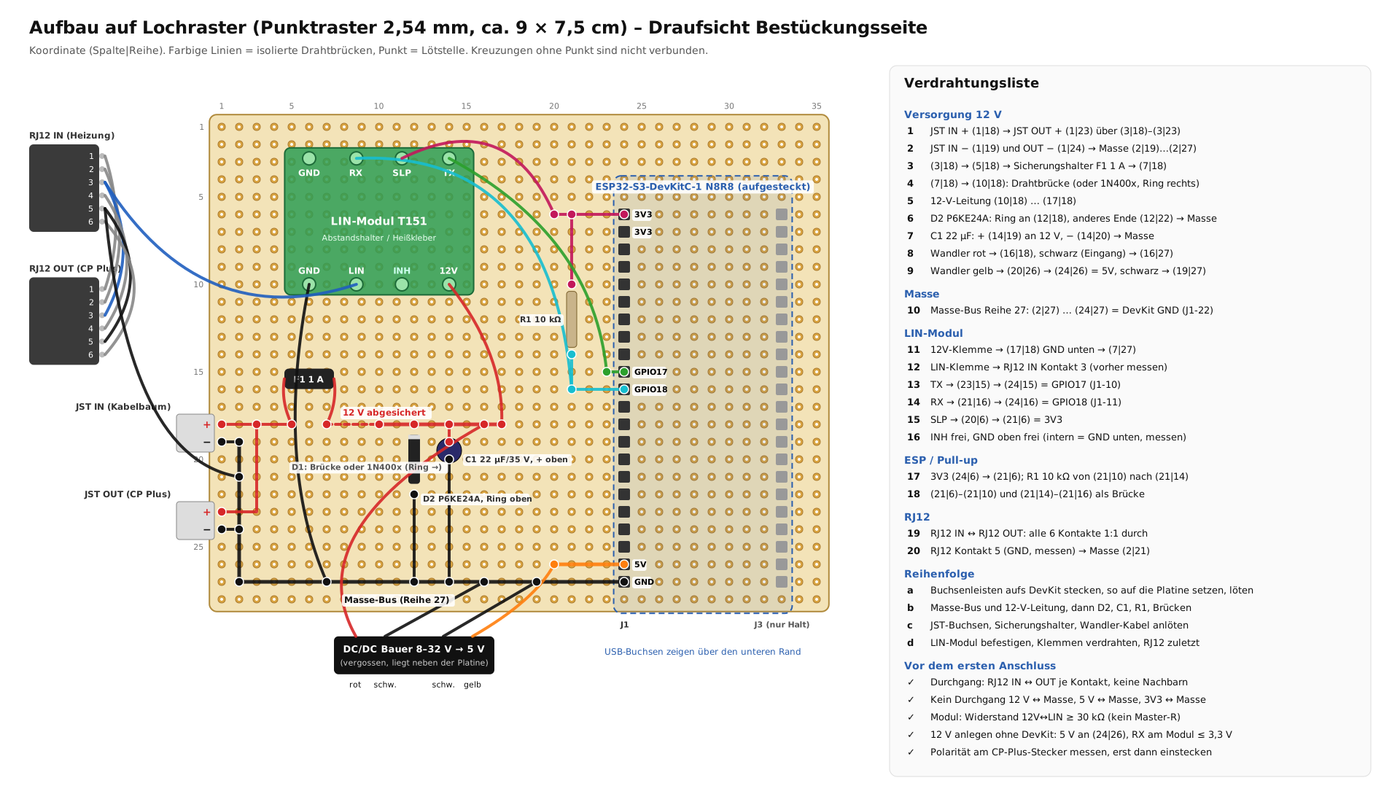
firmware/heater/docs/lochraster.png
