hflocki/camper-mqtt/firmware/heater/docs/lochraster_c3.png

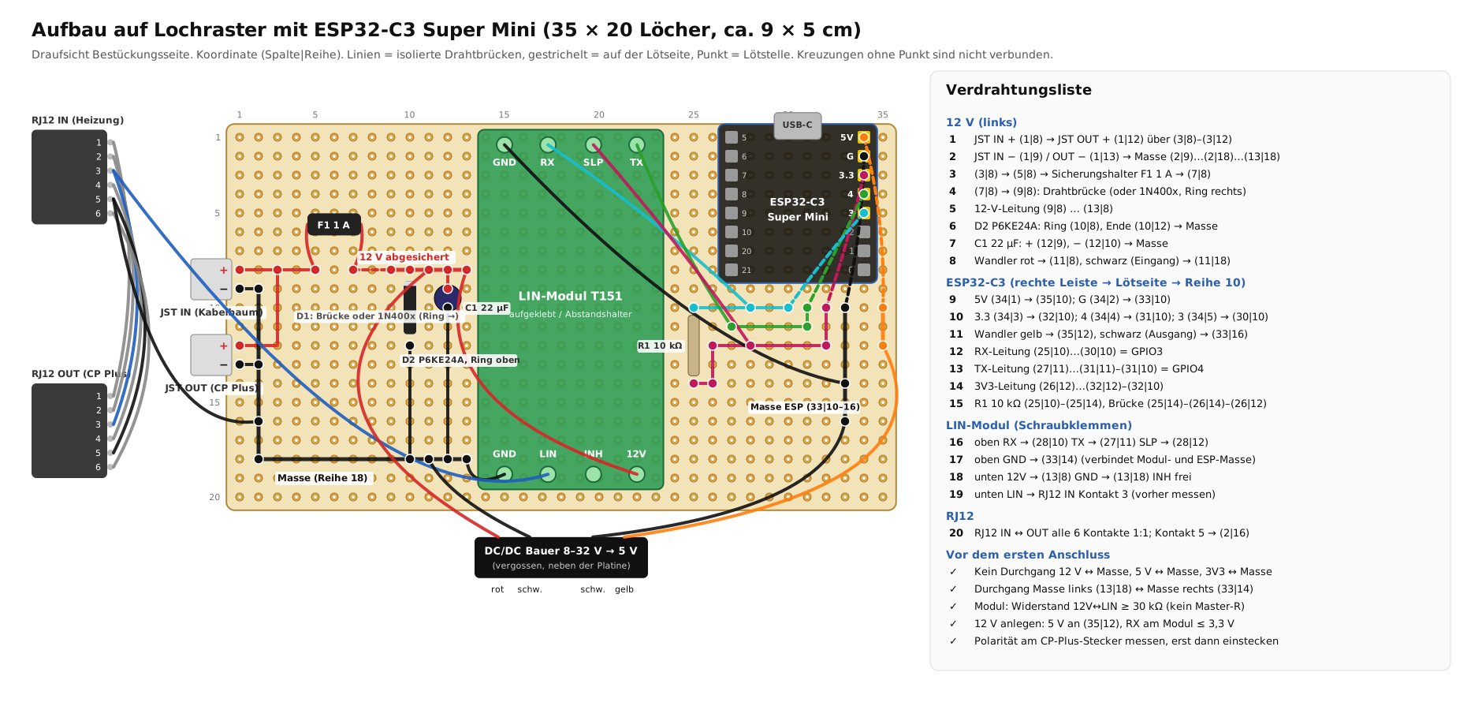
firmware/heater/docs/lochraster_c3.png
