hflocki/camper-mqtt/firmware/heater/docs/schaltplan.png

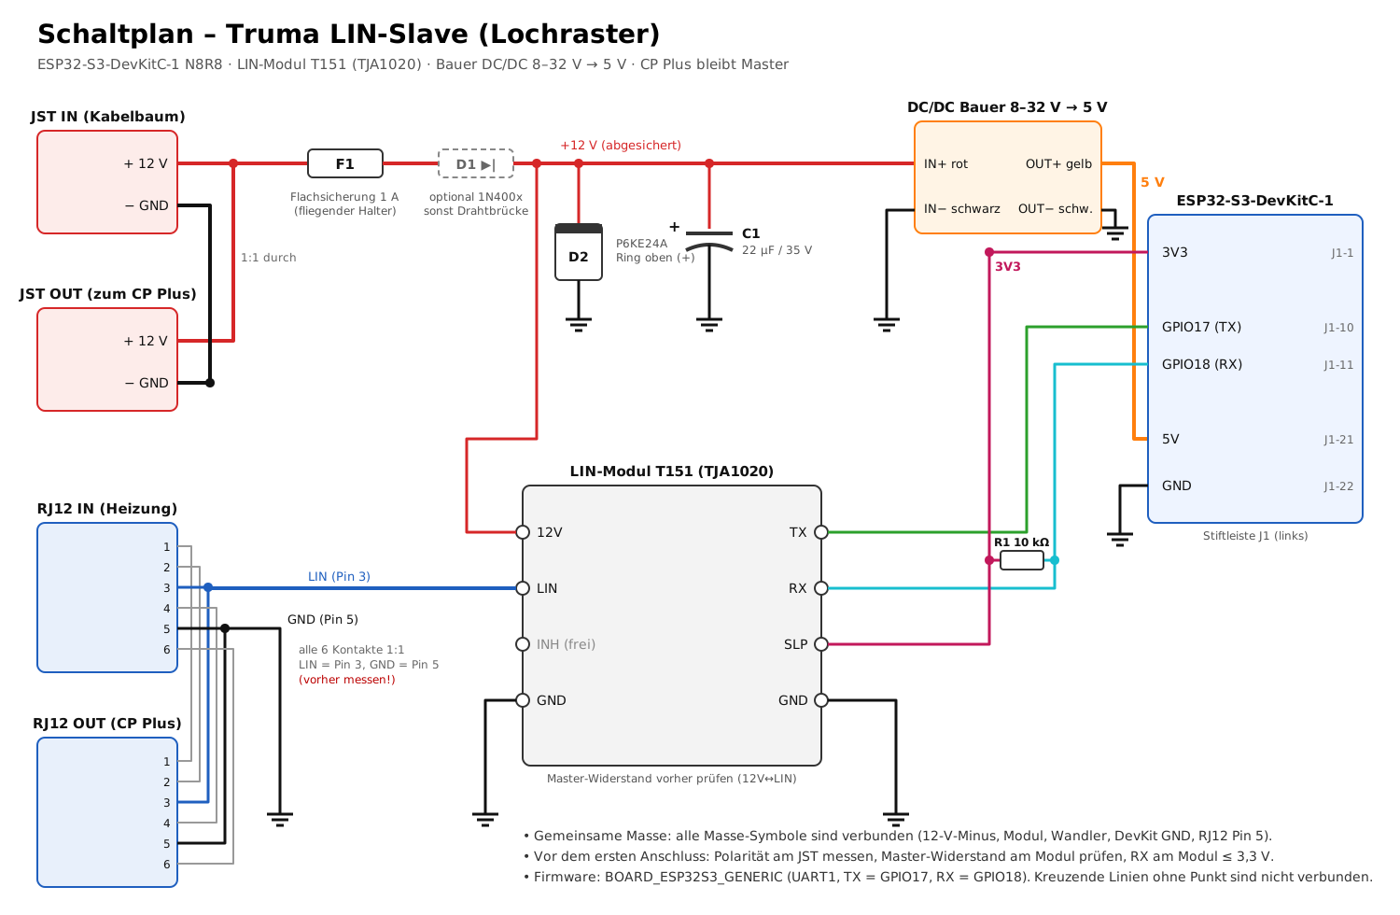
firmware/heater/docs/schaltplan.png
