hflocki/camper-mqtt/firmware/heater/pcb/docs/ansicht-gerber.png

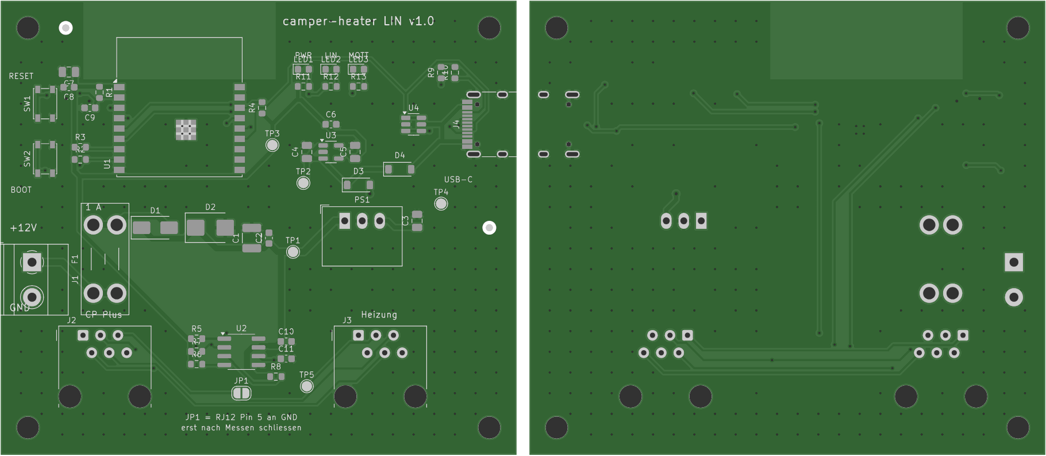
firmware/heater/pcb/docs/ansicht-gerber.png
