hflocki/camper-mqtt/firmware/heater/pcb/docs/schaltplan.png

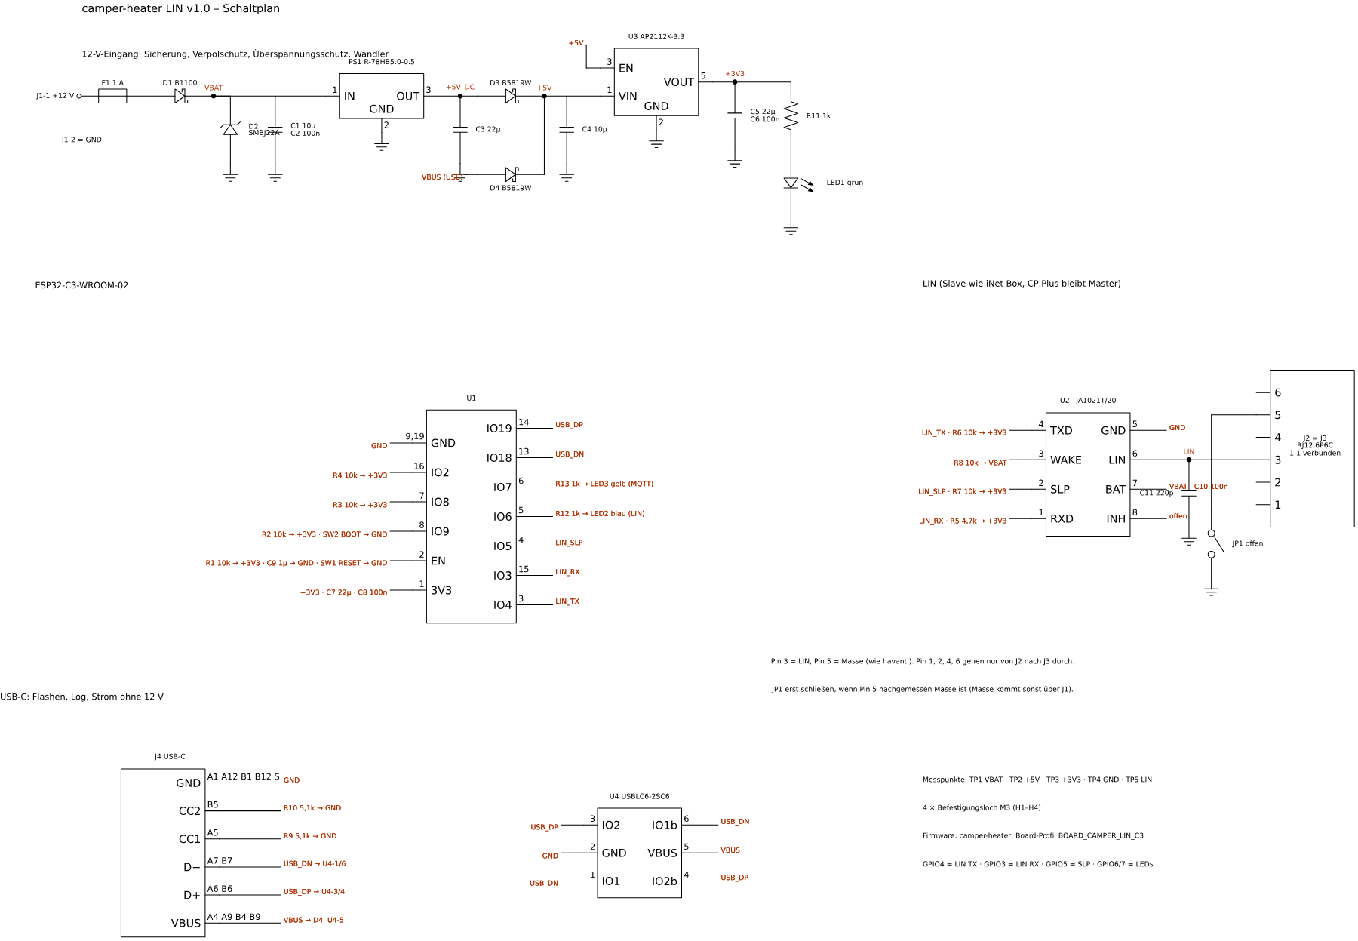
firmware/heater/pcb/docs/schaltplan.png
