hflocki/camper-mqtt/firmware/level/ha-card/img/heckansicht.png

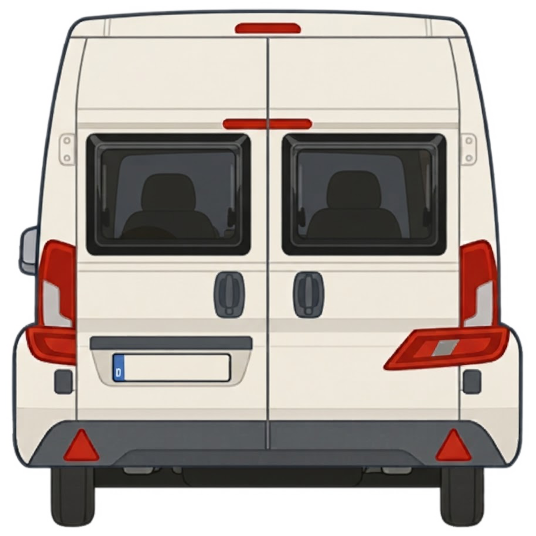
firmware/level/ha-card/img/heckansicht.png
