hflocki/camper-mqtt/firmware/level/ha-card/img/seitenansichtkleiner.png

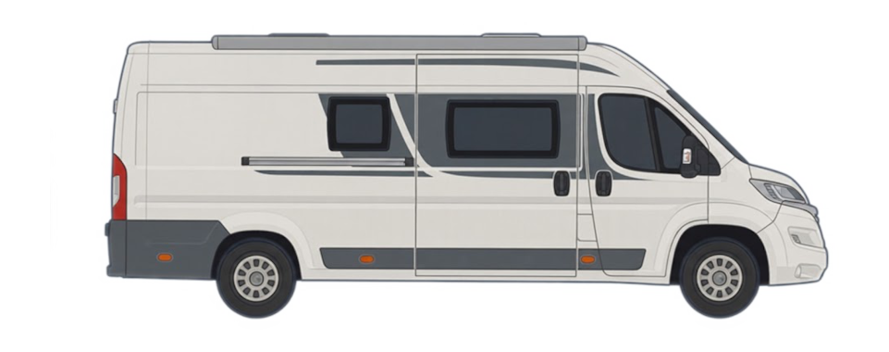
firmware/level/ha-card/img/seitenansichtkleiner.png
