hflocki/camper-mqtt/firmware/heater/pcb/fertigung/camper-heater-lin-bom.csv

Item # | Designator | Qty | Manufacturer | Mfg Part # | Description / Value | Package / Footprint | Type | Hinweis
1 | C1 | 1 | Murata | GRM32ER71H106KA12L | 10uF 50V – Keramikkondensator | C_1210_3225Metric | SMD
2 | C2,C6,C8,C10 | 4 | Murata | GRM188R71H104KA93D | 100nF 50V – Keramikkondensator | C_0603_1608Metric | SMD
3 | C3,C5,C7 | 3 | Murata | GRM21BR61A226ME44L | 22uF 10V – Keramikkondensator | C_0805_2012Metric | SMD
4 | C4 | 1 | Murata | GRM21BR61A106KE19L | 10uF 10V – Keramikkondensator | C_0805_2012Metric | SMD
5 | C9 | 1 | Murata | GRM188R71C105KA12D | 1uF – Keramikkondensator | C_0603_1608Metric | SMD
6 | C11 | 1 | Murata | GRM1885C1H221JA01D | 220pF 50V – Keramikkondensator | C_0603_1608Metric | SMD
7 | D1 | 1 | Diodes Inc. | B1100-13-F | B1100 – Schottky 100 V 1 A, Verpolschutz | D_SMA | SMD
8 | D2 | 1 | Littelfuse | SMBJ22A | SMBJ22A – TVS 22 V, Schutz gegen Spannungsspitzen | D_SMB | SMD
9 | D3,D4 | 2 | Diodes Inc. | B5819W | B5819W – Schottky 40 V 1 A (Wandler -> 5 V) | D_SOD-123 | SMD
10 | F1 | 1 | Keystone | 3568 | Mini-Flachsicherung 1 A – Sicherungshalter Mini-Flachsicherung (ATM), Sicherung 1 A lose dazu | Fuseholder_Blade_Mini_Keystone_3568 | THT | Nur der Halter wird bestückt. Sicherung 1 A (Mini-Flachsicherung ATM, z. B. Littelfuse 0297001.WXNV) lose beilegen oder selbst einstecken.
11 | J1 | 1 | Phoenix Contact | 1715734 | 12V IN – Schraubklemme 2-pol. 5,08 mm (1 = +12 V, 2 = Masse) | TerminalBlock_Phoenix_MKDS-1,5-2-5.08_1x02_P5.08mm_Horizontal | THT
12 | J2 | 1 | Amphenol | 54601-906WPLF | RJ12 (CP Plus) – RJ12 6P6C Buchse | RJ12_Amphenol_54601-x06_Horizontal | THT
13 | J3 | 1 | Amphenol | 54601-906WPLF | RJ12 (Heizung) – RJ12 6P6C Buchse | RJ12_Amphenol_54601-x06_Horizontal | THT
14 | J4 | 1 | Korean Hroparts | TYPE-C-31-M-12 | USB-C – USB-C Buchse 16-pol. | USB_C_Receptacle_HRO_TYPE-C-31-M-12 | SMD
15 | LED1 | 1 | Würth | 150060VS75000 | grün (Power) – LED grün | LED_0603_1608Metric | SMD
16 | LED2 | 1 | Würth | 150060BS75000 | blau (LIN) – LED blau | LED_0603_1608Metric | SMD
17 | LED3 | 1 | Würth | 150060YS75000 | gelb (MQTT) – LED gelb | LED_0603_1608Metric | SMD
18 | PS1 | 1 | RECOM | R-78HB5.0-0.5 | R-78HB5.0-0.5 – Schaltregler-Modul 9-72 V -> 5 V 0,5 A | Converter_DCDC_RECOM_R-78HB-0.5_THT | THT
19 | R1,R2,R3,R4,R6,R7,R8 | 7 | Yageo | RC0603FR-0710KL | 10k – Widerstand 1 %, 0603 | R_0603_1608Metric | SMD
20 | R5 | 1 | Yageo | RC0603FR-074K7L | 4.7k – Widerstand 1 %, 0603 | R_0603_1608Metric | SMD
21 | R9,R10 | 2 | Yageo | RC0603FR-075K1L | 5.1k – Widerstand 1 %, 0603 | R_0603_1608Metric | SMD
22 | R11,R12,R13 | 3 | Yageo | RC0603FR-071KL | 1k – Widerstand 1 %, 0603 | R_0603_1608Metric | SMD
23 | SW1 | 1 | C&K | PTS810 SJM 250 SMTR LFS | RESET – Taster Neustart | SW_SPST_PTS810 | SMD
24 | SW2 | 1 | C&K | PTS810 SJM 250 SMTR LFS | BOOT – Taster Boot (Flash-Modus) | SW_SPST_PTS810 | SMD
25 | U1 | 1 | Espressif | ESP32-C3-WROOM-02-N4 | ESP32-C3-WROOM-02-N4 – WLAN-Modul ESP32-C3, 4 MB Flash | ESP32-C3-WROOM-02 | SMD | Antenne zeigt zum Platinenrand, unter der Antenne kein Kupfer.
26 | U2 | 1 | NXP | TJA1021T/20/C,118 | TJA1021T/20 – LIN-Transceiver | SOIC-8_3.9x4.9mm_P1.27mm | SMD | Gleichwertig: TJA1021T/20/C,118 oder TJA1021T/10 (LIN 2.x Slave).
27 | U3 | 1 | Diodes Inc. | AP2112K-3.3TRG1 | AP2112K-3.3 – LDO 3,3 V 600 mA | SOT-23-5 | SMD
28 | U4 | 1 | STMicroelectronics | USBLC6-2SC6 | USBLC6-2SC6 – ESD-Schutz USB | SOT-23-6 | SMD
