hflocki/camper-mqtt/firmware/level/3d-print/Pfeil ESP32-S3.stl

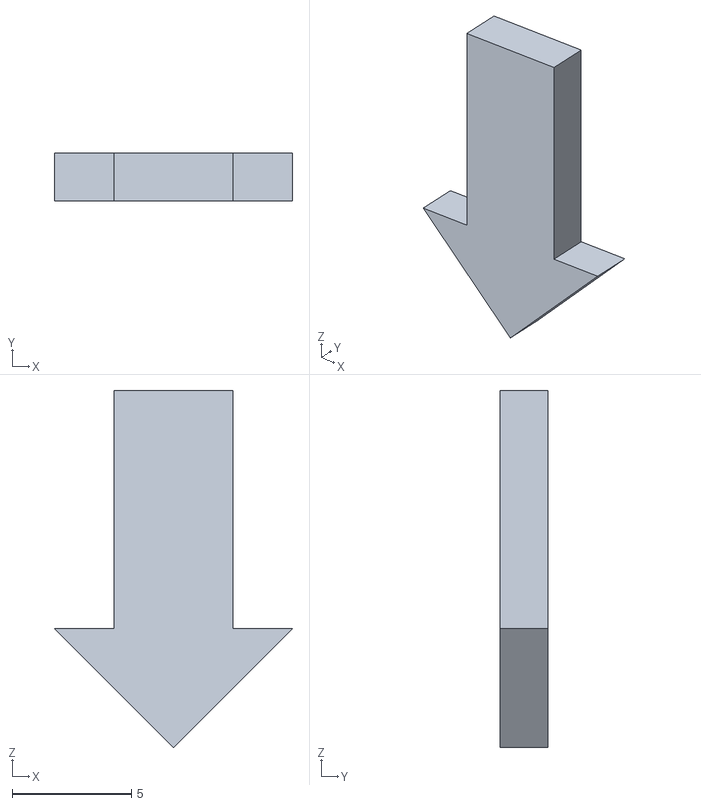
[picture p35: CAD file, 2026-10-24]
firmware/level/3d-print/Pfeil ESP32-S3.stl
10.0 x 2.00 x 15.0
