hflocki/camper-mqtt/firmware/level/3d-print/Deckel ESP32-S3.stl

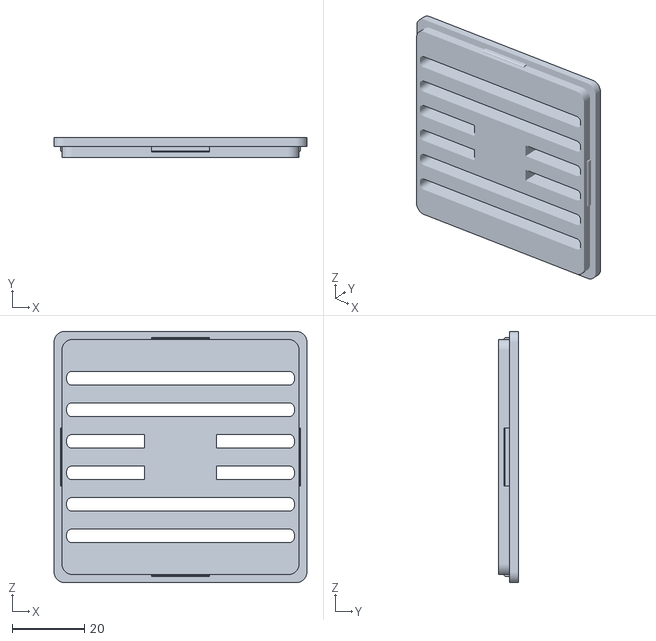
[picture p36: CAD file, 2026-10-24]
firmware/level/3d-print/Deckel ESP32-S3.stl
70.0 x 5.50 x 69.5
