hflocki/camper-mqtt/firmware/level/3d-print/Gehäuse ESP32-S3.stl

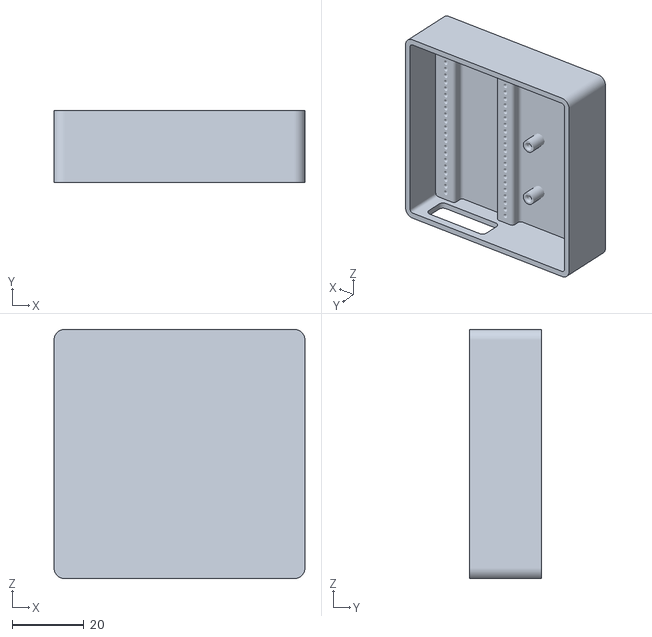
[picture p37: CAD file, 2026-10-24]
firmware/level/3d-print/Gehäuse ESP32-S3.stl
70.0 x 20.0 x 69.5
