hflocki/camper-mqtt/firmware/level/3d-print/Deckel.stl

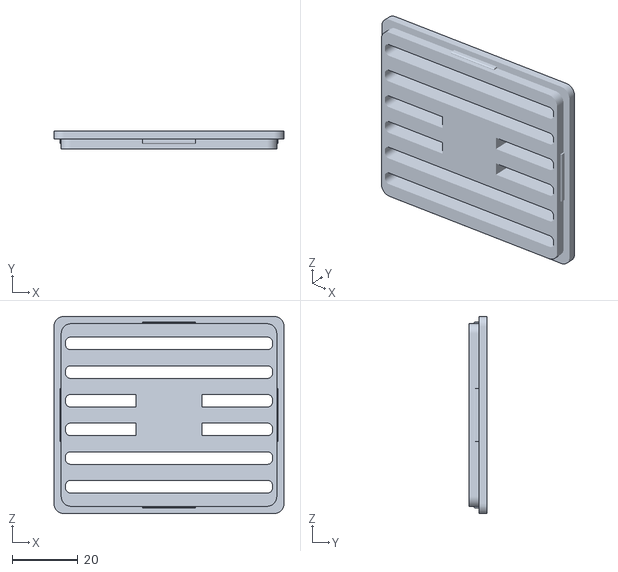
[picture p38: CAD file, 2026-10-24]
firmware/level/3d-print/Deckel.stl
70.0 x 5.50 x 60.0
