hflocki/camper-mqtt/firmware/level/3d-print/Gehäuse.stl

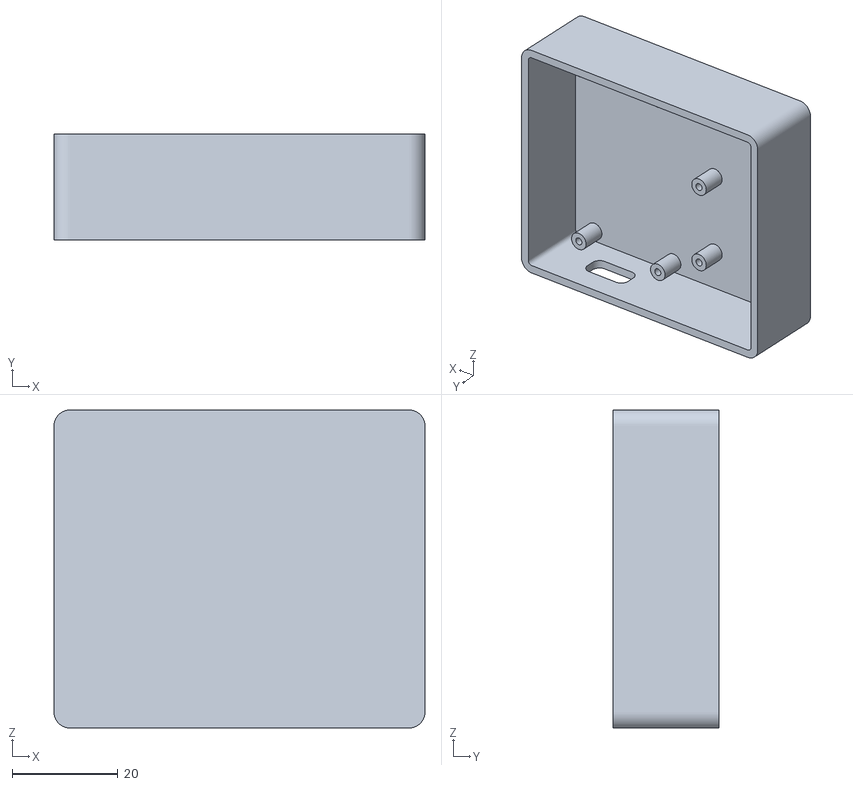
[picture p39: CAD file, 2026-10-24]
firmware/level/3d-print/Gehäuse.stl
70.0 x 20.0 x 60.0
