hflocki/camper-mqtt/firmware/level/3d-print/baseesp32dev.png

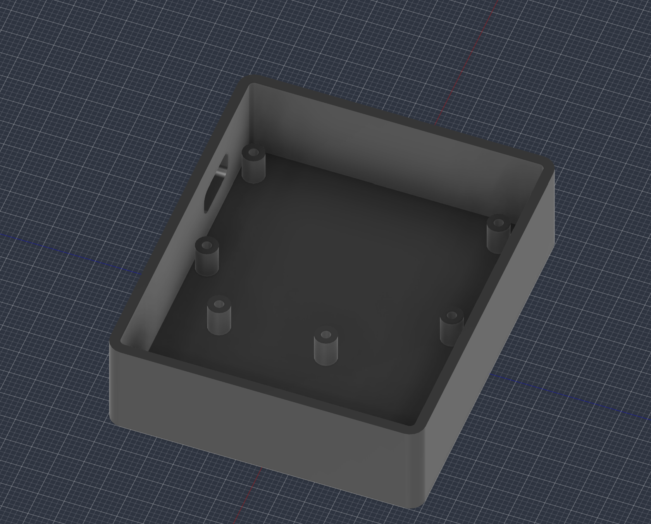
firmware/level/3d-print/baseesp32dev.png
