hflocki/camper-mqtt/firmware/level/3d-print/baseS3-2.png

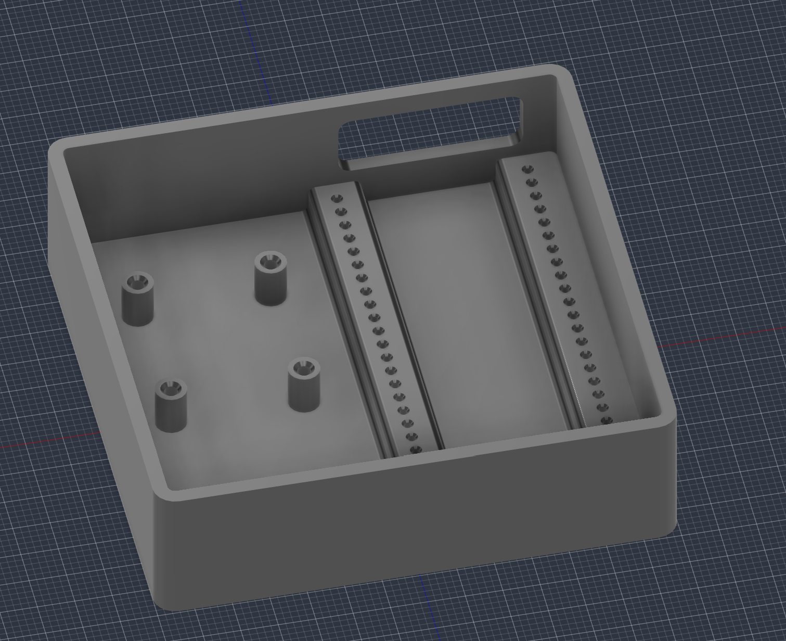
firmware/level/3d-print/baseS3-2.png
