hflocki/camper-mqtt/schaltplan.pdf

## camper-heater LIN v1.0 – Schaltplan

IN | 3

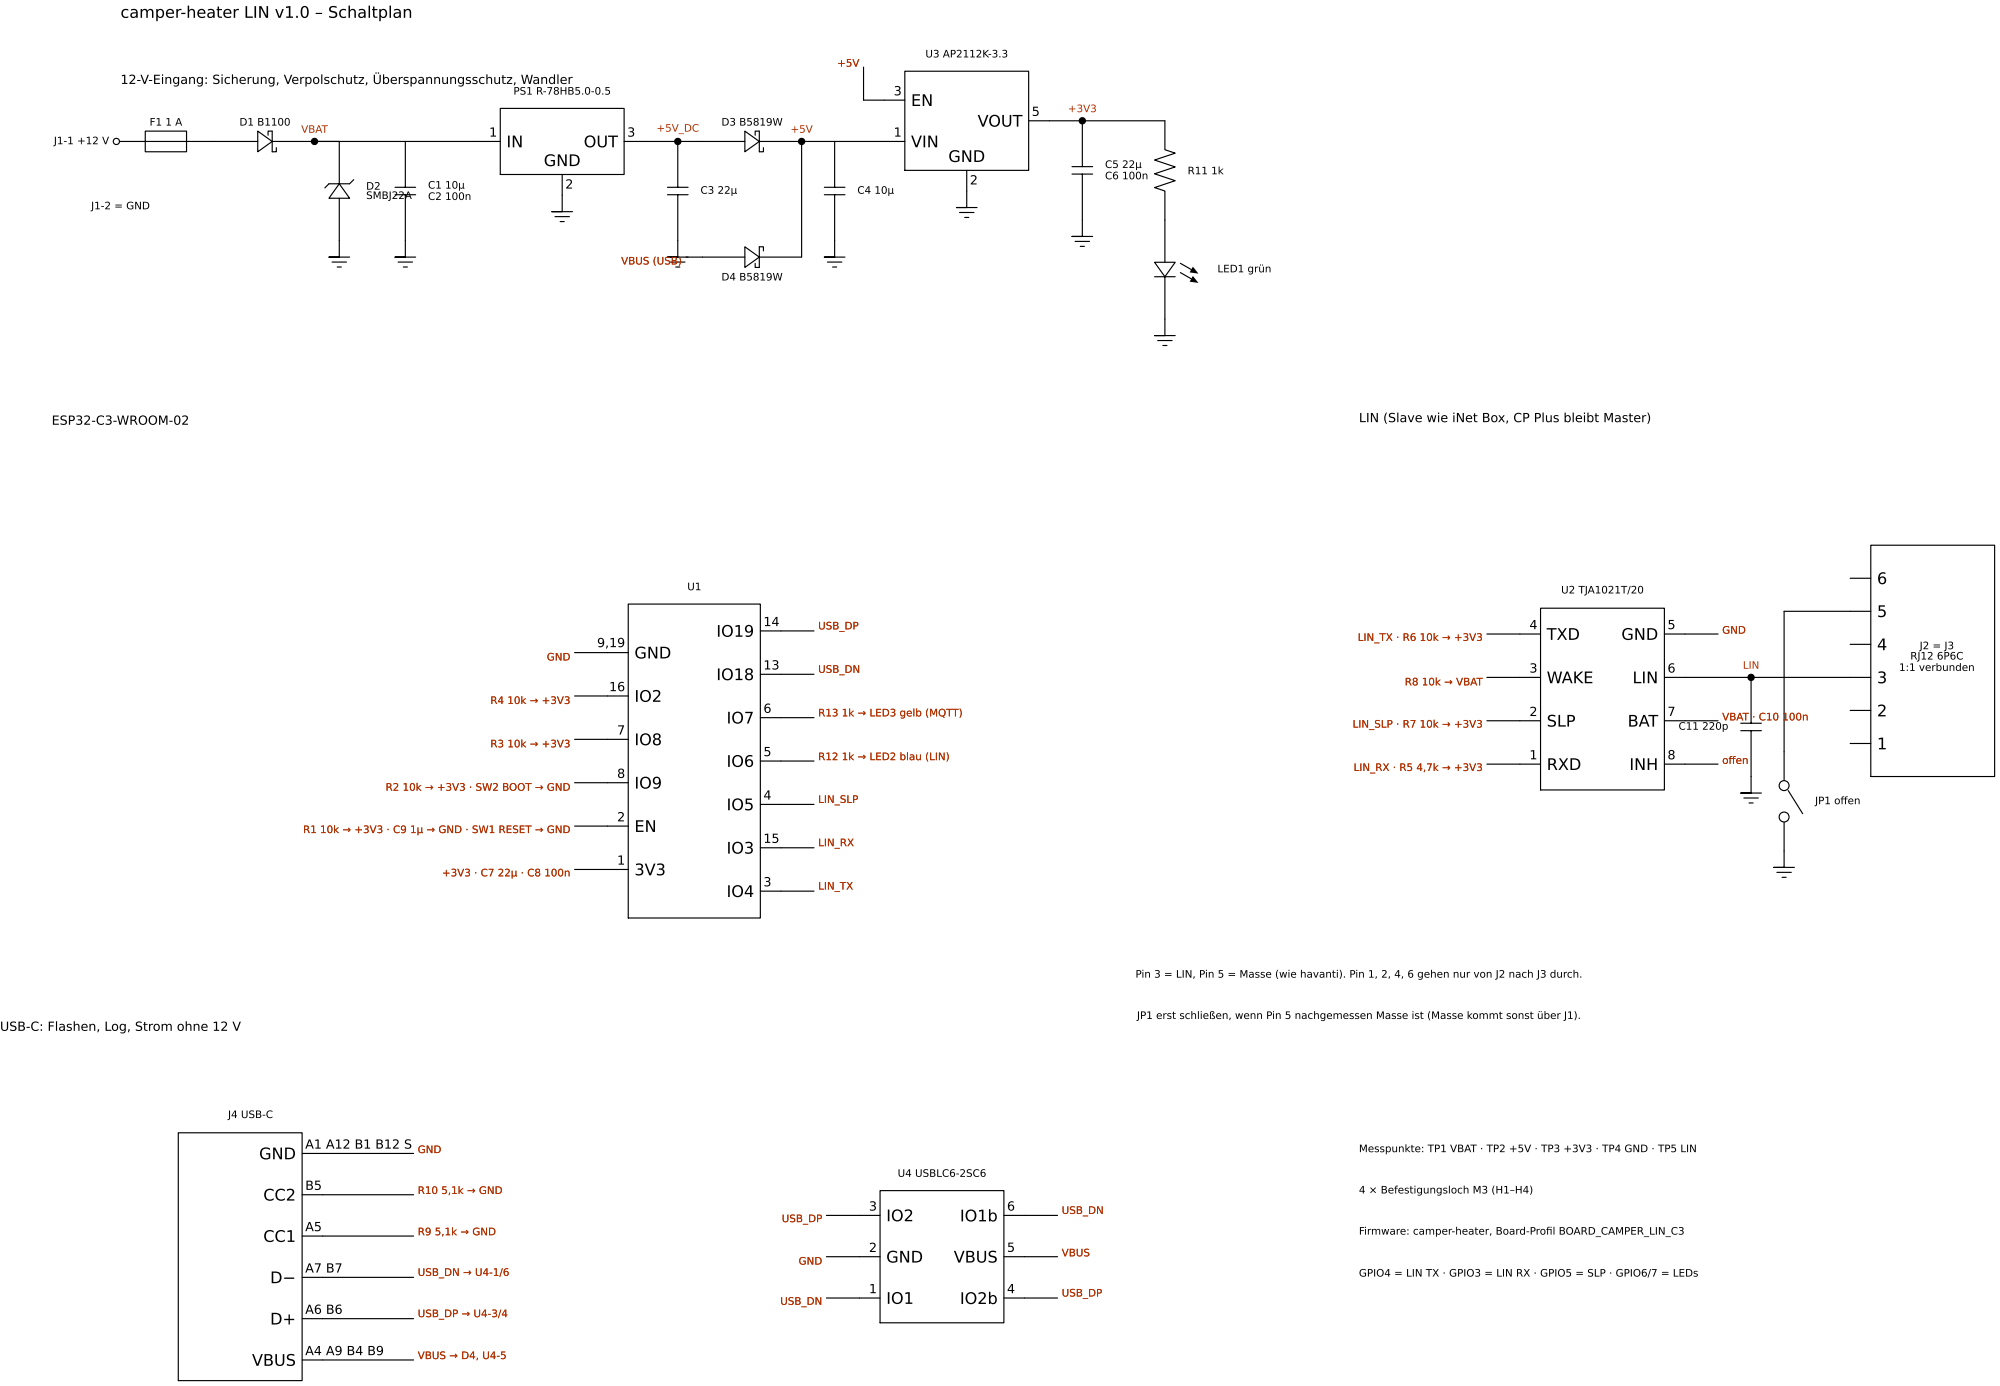
[picture p43: page 1]

12-V-Eingang: Sicherung, Verpolschutz, Überspannungsschutz, Wandler

LIN (Slave wie iNet Box, CP Plus bleibt Master)

R1 10k → +3V3 · C9 1µ +3V3 · C9 1µ → GND · SW1 RESET GND · SW1 RESET → GND

Pin 3 = LIN, Pin 5 = Masse (wie havanti). Pin 1, 2, 4, 6 gehen nur von J2 nach J3 durch.

JP1 erst schließen, wenn Pin 5 nachgemessen Masse ist (Masse kommt sonst über J1).

USB-C: Flashen, Log, Strom ohne 12 V

Messpunkte: TP1 VBAT · TP2 +5V · TP3 +3V3 · TP4 GND · TP5 LIN

Firmware: camper-heater, Board-Profil BOARD_CAMPER_LIN_C3

GPIO4 = LIN TX · GPIO3 = LIN RX · GPIO5 = SLP · GPIO6/7 = LEDs
