hflocki/camper-mqtt/firmware/heater/pcb/kicad/camper-heater-lin.kicad_pcb

## KiCad design firmware/heater/pcb/kicad/camper-heater-lin.kicad_pcb (2026-10-28)

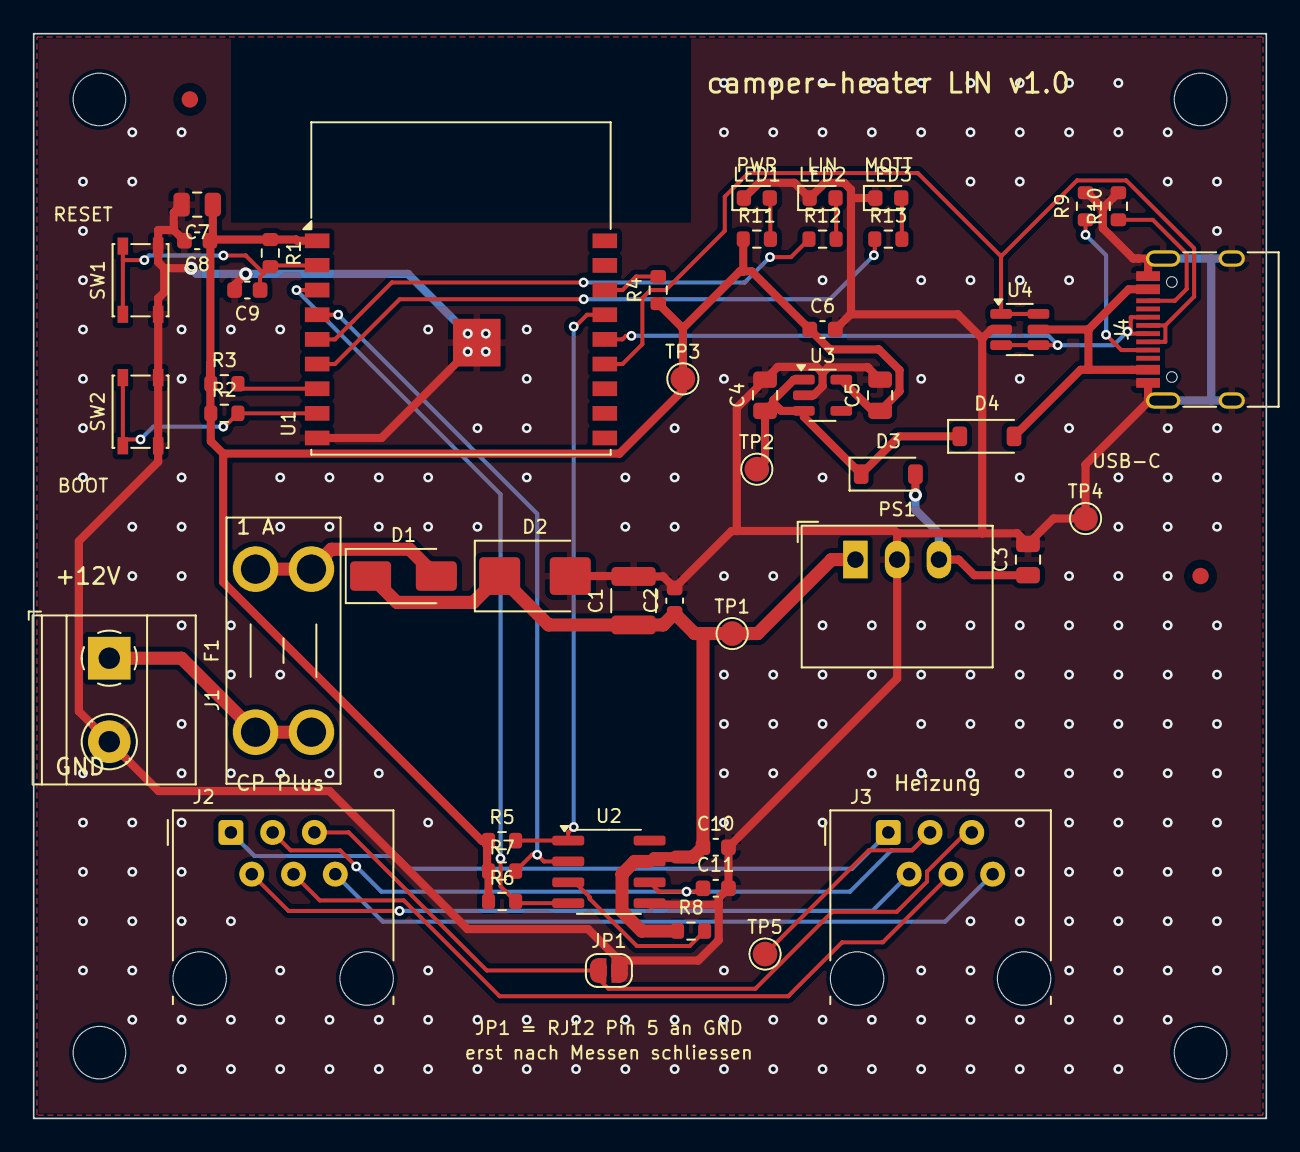
[picture p44: board camper-heater-lin.kicad_pcb from above]

Board: 2 copper layers, 75.0 x 66.0 mm, 55 parts (0 on the bottom side), 31 nets.

Parts:
C1: 10uF 50V; C_1210_3225Metric
C2, C6, C8, C10: 100nF 50V; C_0603_1608Metric
C3, C5, C7: 22uF 10V; C_0805_2012Metric
C4: 10uF 10V; C_0805_2012Metric
C9: 1uF; C_0603_1608Metric
C11: 220pF 50V; C_0603_1608Metric
D1: B1100; D_SMA
D2: SMBJ22A; D_SMB
D3, D4: B5819W; D_SOD-123
F1: Mini-Flachsicherung 1 A; Fuseholder_Blade_Mini_Keystone_3568
FID1, FID2: Fiducial; Fiducial_1mm_Mask2mm
H1, H2, H3, H4: M3; MountingHole_3.2mm_M3
J1: 12V IN; TerminalBlock_Phoenix_MKDS-1,5-2-5.08_1x02_P5.08mm_Horizont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
J2: RJ12 (CP Plus); RJ12_Amphenol_54601-x06_Horizontal
J3: RJ12 (Heizung); RJ12_Amphenol_54601-x06_Horizontal
J4: USB-C; USB_C_Receptacle_HRO_TYPE-C-31-M-12
JP1: RJ12 Pin 5 an GND; SolderJumper-2_P1.3mm_Open_RoundedPad1.0x1.5mm
LED1: grün (Power); LED_0603_1608Metric
LED2: blau (LIN); LED_0603_1608Metric
LED3: gelb (MQTT); LED_0603_1608Metric
PS1: R-78HB5.0-0.5; Converter_DCDC_RECOM_R-78HB-0.5_THT
R1, R2, R3, R4, R6, R7, R8: 10k; R_0603_1608Metric
R5: 4.7k; R_0603_1608Metric
R9, R10: 5.1k; R_0603_1608Metric
R11, R12, R13: 1k; R_0603_1608Metric
SW1: RESET; SW_SPST_PTS810
SW2: BOOT; SW_SPST_PTS810
TP1: VBAT; TestPoint_Pad_D1.5mm
TP2: 5V; TestPoint_Pad_D1.5mm
TP3: 3V3; TestPoint_Pad_D1.5mm
TP4: GND; TestPoint_Pad_D1.5mm
TP5: LIN; TestPoint_Pad_D1.5mm
U1: ESP32-C3-WROOM-02-N4; ESP32-C3-WROOM-02
U2: TJA1021T/20; SOIC-8_3.9x4.9mm_P1.27mm
U3: AP2112K-3.3; SOT-23-5
U4: USBLC6-2SC6; SOT-23-6

Connections:
+3V3: C5.1, C6.1, C7.1, C8.1, R1.1, R2.1, R3.1, R4.1, R5.1, R6.1, R7.1, R11.1, TP3.1, U1.1, U3.5
+5V: C4.1, D3.1, D4.1, TP2.1, U3.1, U3.3
+5V_DC: C3.1, D3.2, PS1.3
CC1: J4.A5, R9.1
CC2: J4.B5, R10.1
EN: C9.1, R1.2, SW1.1, U1.2
GND: C1.2, C2.2, C3.2, C4.2, C5.2, C6.2, C7.2, C8.2, C9.2, C10.2, C11.2, D2.2, J1.2, J4.A1, J4.A12, J4.B1, J4.B12, J4.S1, JP1.2, LED1.1, LED2.1, LED3.1, PS1.2, R9.2, R10.2, SW1.2, SW2.2, TP4.1, U1.9, U1.19, U2.5, U3.2, U4.2
IO2: R4.2, U1.16
IO8: R3.2, U1.7
IO9: R2.2, SW2.1, U1.8
LED1_A: LED1.2, R11.2
LED2_A: LED2.2, R12.2
LED3_A: LED3.2, R13.2
LED_LIN: R12.1, U1.5
LED_MQTT: R13.1, U1.6
LIN: C11.1, J2.3, J3.3, TP5.1, U2.6
LIN_RX: R5.2, U1.15, U2.1
LIN_SLP: R7.2, U1.4, U2.2
LIN_TX: R6.2, U1.3, U2.4
LIN_WAKE: R8.2, U2.3
RJ1: J2.1, J3.1
RJ2: J2.2, J3.2
RJ4: J2.4, J3.4
RJ5: J2.5, J3.5, JP1.1
RJ6: J2.6, J3.6
USB_DN: J4.A7, J4.B7, U1.13, U4.1, U4.6
USB_DP: J4.A6, J4.B6, U1.14, U4.3, U4.4
VBAT: C1.1, C2.1, C10.1, D1.1, D2.1, PS1.1, R8.1, TP1.1, U2.7
VBUS: D4.2, J4.A4, J4.A9, J4.B4, J4.B9, U4.5
VIN_F: D1.2, F1.2
VIN_RAW: F1.1, J1.1
