hflocki/camper-mqtt/firmware/display/camper_display/config.h

#pragma once
#if __has_include("config_local.h")
#include "config_local.h"
#endif
#define FW_NAME                 "display-node"
#define FW_VERSION              "2.16.1"
#define FW_DEVICE               "display"   // device id in the firmware marker (fwcheck.h)
#define WIFI_TRIAL_MS           50000   // a changed WiFi must connect this fast, else the old one returns
#define STATIC_IP_FALLBACK_MS   180000  // static IP, WiFi ok but no MQTT this long -> DHCP until restart
#define DEV_TILE_COLS           4   // sensor tiles per row on Sensoren / Energie / Extra (3 .. 5; 5 = names wrap to two short lines)
#define DEFAULT_WEB_TILES       "water,grey,gas,none,heater,fan,heki,weather,temp,none,bat,none,level,actors,lights,switches"
#define DEFAULT_OV_TILES        "water,grey,gas,heater,level,fan,temp,bat,status"   // overview tiles in order
#define MAX_LINKS               16      // device links on the web page (name + URL)
#define DEFAULT_DISPLAY_NAME    ""                  // name shown in the header (web UI: Einstellungen)
#define DEFAULT_HOSTNAME        "display-node"
#define AP_SSID_PREFIX          "Display-Node-"   // + last 6 hex digits of the MAC
#define DEFAULT_AP_PASSWORD     "display1234"       // min. 8 characters - CHANGE ME
#define DEFAULT_OTA_PASSWORD    "display1234"       // Arduino IDE network port - CHANGE ME
#define WIFI_AP_FALLBACK_MS     60000               // open setup AP after 1 min without WiFi
#define DEFAULT_MQTT_PORT       1883
#define DEFAULT_PREFIX_SELF     "camper/display"
#define DEFAULT_PREFIX_TANK     "camper/tanklevel"
#define DEFAULT_PREFIX_LEVEL    "camper/level"
#define DEFAULT_PREFIX_HEATER   "camper/heater"
#define DEFAULT_PREFIX_FAN      "camper/maxxfan"
#define DEFAULT_PREFIX_TOOLBOX  "camper/toolbox"   // toolbox-node (BLE gateway), roof hatch: <prefix>/rvtech/...
#define DEFAULT_PREFIX_TEMP     "camper/temp"
#define DEFAULT_PREFIX_BATTERY  "camper/battery"
#define BAT_WARN_SOC            20      // warn below this state of charge in % (monitors with current sensor)
#define DEFAULT_WX_LAT          ""      // e.g. "52.52"
#define DEFAULT_WX_LON          ""      // e.g. "13.40"
#define DEFAULT_WX_NAME         ""
#define DEFAULT_RT_TOPIC        "camper/router/mobile"   // mobile signal of the router (RUT956 Data to Server, GSM)
#define DEFAULT_WX_TOPIC        ""      // MQTT topic with the GPS position, e.g. from the router
#define DEFAULT_WARN_WATER      10      // fresh water below this level in %
#define DEFAULT_WARN_GAS        15      // gas bottle below this level in %
#define DEFAULT_WARN_FROST      3       // frost warning below this outside temperature in °C (off by default)
#define DEFAULT_AWNING_GUST     40      // awning out: warn from these gusts (km/h), 0 = off
#define DEFAULT_DEPART_TOPIC    "camper/rut"    // router JSON with GPS.speed (km/h) and GPS.fix_status, "" = off
#define DEFAULT_DOOR_TOPIC      "camper/door"   // door: RUT956 digital input JSON or plain open/closed, "" = none
#define DEFAULT_DEPART_SPEED    5       // driving above this speed in km/h ...
#define DEFAULT_DEPART_SECS     10      // ... for this many seconds
#define DEFAULT_WX_GUST         60      // warn from these gusts (km/h), 0 = off
#define HISTORY_STEP_S          300     // one sample every 5 minutes
#define HISTORY_POINTS          288     // 288 x 5 min = 24 h
#define DEFAULT_WIFI_SSID       ""
#define DEFAULT_WIFI_PASSWORD   ""
#define DEFAULT_STATIC_IP       ""
#define DEFAULT_GATEWAY         ""
#define DEFAULT_SUBNET          "255.255.255.0"
#define DEFAULT_DNS             ""                  // "" = gateway
#define DEFAULT_MQTT_SERVER     ""
#define DEFAULT_MQTT_USER       ""
#define DEFAULT_MQTT_PASSWORD   ""
#define DEFAULT_WEB_USER        "admin" // login only applies once a password is set
#define DEFAULT_WEB_PASSWORD    ""
#define DEFAULT_FAN_PORT        1                   // VanTurtle port 1 = RJ45
#define DEFAULT_FINDER_FILTER   "zigbee2mqtt/#"
#define DEFAULT_PUSHOVER_TOKEN  ""
#define DEFAULT_PUSHOVER_USER   ""
#define PUSHOVER_URL            "https://api.pushover.net/1/messages.json"
#define PUSHOVER_CANCEL_URL     "https://api.pushover.net/1/receipts/cancel_by_tag/"   // + tag + ".json"
#define PUSHOVER_HOST           "api.pushover.net"   // must match PUSHOVER_URL
#define PUSHOVER_STABLE_MS      30000   // a warning must be active this long before it is sent
#define PUSHOVER_RETRIES        5       // attempts per message (no WiFi / server error)
#define PUSHOVER_RETRY_MS       60000
#define PUSHOVER_QUEUE          8
#define MQTT_BUFFER_SIZE        4096                // larger messages are dropped by PubSubClient
#define MQTT_RECONNECT_MS       5000
#define SELF_PUBLISH_MS         60000
#define DEFAULT_NTP_SERVER      "pool.ntp.org"
#define DEFAULT_TZ              "CET-1CEST,M3.5.0,M10.5.0/3"   // Europe/Berlin
#define MAX_PAGES               8
#define MAX_TILES               40
#define LCD_WIDTH               480
#define LCD_HEIGHT              480
#define LCD_BL_PIN              38
#define LCD_SPI_CS              39
#define LCD_SPI_SCK             48
#define LCD_SPI_MOSI            47
#define LCD_DE                  18
#define LCD_VSYNC               17
#define LCD_HSYNC               16
#define LCD_PCLK                21
#define LCD_R0 11
#define LCD_R1 12
#define LCD_R2 13
#define LCD_R3 14
#define LCD_R4 0
#define LCD_G0 8
#define LCD_G1 20
#define LCD_G2 3
#define LCD_G3 46
#define LCD_G4 9
#define LCD_G5 10
#define LCD_B0 4
#define LCD_B1 5
#define LCD_B2 6
#define LCD_B3 7
#define LCD_B4 15
#define LCD_PCLK_HZ             12000000
#define LCD_INIT_TYPE           9
#define LCD_ROTATION            0
#define TOUCH_SDA               19
#define TOUCH_SCL               45
#define TOUCH_I2C_HZ            400000
#define TOUCH_SWAP_XY           0
#define TOUCH_INVERT_X          0
#define TOUCH_INVERT_Y          0
#define DEFAULT_BRIGHTNESS      80      // %
#define DEFAULT_DIM_BRIGHTNESS  10      // % after timeout, 0 = screen off
#define DEFAULT_SCREEN_TIMEOUT  120     // s, 0 = never dim
#define LV_BUF_LINES            48
#define LV_BUF_IN_PSRAM         1       // 0 = internal RAM (slightly faster drawing, but HTTPS / Pushover then lacks memory)
