hflocki/camper-mqtt/firmware/heater/truma_heater/config.h

#pragma once
#include <Arduino.h>
#if __has_include("config_local.h")
#include "config_local.h"
#endif
#if !defined(BOARD_SMARTAVAN) && !defined(BOARD_ESP32_GENERIC) && !defined(BOARD_ESP32S3_GENERIC) && \
    !defined(BOARD_ESP32C3_GENERIC) && !defined(BOARD_ESP32C3_SUPERMINI) && !defined(BOARD_CAMPER_LIN_C3) && \
    !defined(BOARD_ESP32_DEVKIT)
#if CONFIG_IDF_TARGET_ESP32
#define BOARD_ESP32_DEVKIT
#else
#define BOARD_ESP32C3_SUPERMINI
#endif
#endif
#define FW_NAME "heater-node"
#define FW_VERSION "1.6.1"
#define FW_DEVICE "heater"   // device id in the firmware marker (fwcheck.h)
#define WIFI_TRIAL_MS 50000   // a changed WiFi must connect this fast, else the old one returns
#if defined(BOARD_ESP32_DEVKIT)
#define BOARD_NAME "Heater Node (ESP32 DevKit + LIN module)"
#define LIN_UART_NUM UART_NUM_2
#define LIN_TX_PIN 16
#define LIN_RX_PIN 17
#elif defined(BOARD_ESP32S3_GENERIC)
#define BOARD_NAME "ESP32-S3 + LIN module"
#ifndef LIN_UART_NUM
#define LIN_UART_NUM UART_NUM_1
#endif
#ifndef LIN_TX_PIN
#define LIN_TX_PIN 17
#endif
#ifndef LIN_RX_PIN
#define LIN_RX_PIN 18
#endif
#elif defined(BOARD_ESP32C3_GENERIC)
#define BOARD_NAME "ESP32-C3 + LIN module"
#ifndef LIN_UART_NUM
#define LIN_UART_NUM UART_NUM_1
#endif
#ifndef LIN_TX_PIN
#define LIN_TX_PIN 21
#endif
#ifndef LIN_RX_PIN
#define LIN_RX_PIN 20
#endif
#elif defined(BOARD_ESP32C3_SUPERMINI)
#define BOARD_NAME "Heater Node (ESP32-C3 Super Mini)"
#ifndef LIN_UART_NUM
#define LIN_UART_NUM UART_NUM_1
#endif
#ifndef LIN_TX_PIN
#define LIN_TX_PIN 4
#endif
#ifndef LIN_RX_PIN
#define LIN_RX_PIN 3
#endif
#define LIN_LED_PIN 8  // on-board blue LED
#define LED_ACTIVE_LOW true
#define WIFI_TX_POWER_QDBM 34
#elif defined(BOARD_CAMPER_LIN_C3)
#define BOARD_NAME "Heater Node LIN board (ESP32-C3-WROOM-02)"
#ifndef LIN_UART_NUM
#define LIN_UART_NUM UART_NUM_1
#endif
#ifndef LIN_TX_PIN
#define LIN_TX_PIN 4
#endif
#ifndef LIN_RX_PIN
#define LIN_RX_PIN 3
#endif
#define LIN_CS_PIN 5       // TJA1021 SLP_N, 10k pull-up on the board
#ifndef LIN_LED_PIN
#define LIN_LED_PIN 6      // blue LED
#endif
#define MQTT_LED_PIN 7     // yellow LED
#else
#error "No board profile selected (see BOARD SELECTION at the top of config.h)."
#endif
#define LIN_BAUD 9600
#define SERIAL_LOG_ENABLED true
#ifndef LIN_CS_PIN
#define LIN_CS_PIN -1     // driven HIGH to enable the transceiver (TJA1020/1021 SLP/EN)
#endif
#define LIN_FAULT_PIN -1  // active LOW fault output of the transceiver
#ifndef MQTT_LED_PIN
#define MQTT_LED_PIN -1   // on = MQTT connected
#endif
#ifndef LIN_LED_PIN
#define LIN_LED_PIN -1    // flicker = LIN traffic, on = CP Plus polls us
#endif
#ifndef LED_ACTIVE_LOW
#define LED_ACTIVE_LOW false
#endif
#define LIN_OBSERVER_MODE false
#if defined(HEATER_SUPPORTS_BOOST) && HEATER_SUPPORTS_BOOST
#if defined(HEATER_HAS_ELECTRIC) && HEATER_HAS_ELECTRIC
#define DEFAULT_HEATER_MODEL "combi_e"
#else
#define DEFAULT_HEATER_MODEL "combi"
#endif
#elif defined(HEATER_HAS_ELECTRIC) && HEATER_HAS_ELECTRIC
#define DEFAULT_HEATER_MODEL "combi_d_e"
#else
#define DEFAULT_HEATER_MODEL "combi_d"
#endif
#define DECOKE_TARGET_TEMP 30
#define DECOKE_DEFAULT_MINUTES 30
#define DEFAULT_HOSTNAME "heater-node"
#define DEFAULT_AP_PASSWORD "truma1234"  // min. 8 characters
#define DEFAULT_WIFI_SSID ""
#define DEFAULT_WIFI_PASSWORD ""
#define DEFAULT_MQTT_SERVER ""
#define DEFAULT_MQTT_USER ""
#define DEFAULT_MQTT_PASSWORD ""
#define DEFAULT_WEB_USER ""
#define DEFAULT_WEB_PASSWORD ""
#define DEFAULT_MQTT_PORT 1883
#define DEFAULT_MQTT_BASE "camper/heater"
#define DEFAULT_HA_PREFIX "homeassistant"
#define DEFAULT_NTP_SERVER "pool.ntp.org"
#define DEFAULT_TZ "CET-1CEST,M3.5.0,M10.5.0/3"  // Europe/Berlin
#ifndef WIFI_TX_POWER_QDBM
#define WIFI_TX_POWER_QDBM 70
#endif
#define MQTT_PUBLISH_INTERVAL_MS 60000
#define CPPLUS_TIMEOUT_MS 60000
#define CLOCK_RESYNC_INTERVAL_MS (24UL * 3600UL * 1000UL)
