hflocki/camper-mqtt/firmware/tanklevel/camper_tanklevel/config.h

#define CONFIG_H
#include <Arduino.h>
#if __has_include("config_local.h")
#include "config_local.h"
#endif
#define FW_VERSION            "1.9.1"
#define FW_DEVICE             "tanklevel"   // device id in the firmware marker (fwcheck.h)
#define DEFAULT_AP_SSID       "Tanklevel-Node" // Base name; "-XXXXXX" (last 3 MAC bytes) is appended
#define DEFAULT_AP_PASSWORD   "tanklevel1234"    // Test placeholder (min. 8 characters) - change in the web UI
#define DEFAULT_OTA_PASSWORD  "tanklevel1234"    // Test placeholder - change before the first flash
#define DEFAULT_MQTT_SERVER   ""                 // Set in the web UI
#define DEFAULT_MQTT_PORT     1883
#define DEFAULT_WIFI_SSID       ""
#define DEFAULT_WIFI_PASSWORD   ""
#define DEFAULT_MQTT_USER       ""
#define DEFAULT_MQTT_PASSWORD   ""
#define DEFAULT_WEB_USER        ""      // empty = no login
#define DEFAULT_WEB_PASSWORD    ""
#define DEFAULT_MQTT_PREFIX   "camper/tanklevel" // Topics: <prefix>/water/..., <prefix>/grey/..., <prefix>/gas/..., <prefix>/status
#define DEFAULT_TX_POWER      70
#define DEFAULT_AP_ALWAYS     true
#define AP_FALLBACK_MS        60000  // AP-only-as-fallback: start the AP after 60 s without WiFi
#define MQTT_WATER_MS         5000   // Fresh / grey water: periodic publish interval
#define MQTT_GAS_MS           30000  // Gas: periodic publish (also published immediately on new data)
#define WS_UPDATE_MS          1000   // Web UI live update interval
#define WATER_ENABLED         1      // Fresh water level (Votronic tank sender)
#define GREY_ENABLED          0      // Grey water level (second Votronic tank sender) - optional
#define GAS_ENABLED           1      // Gas level (BLE sensor)
#define CONFIG_FILE           "/config.json"
#define OTA_HOSTNAME          "tanklevel-node"
#if CONFIG_IDF_TARGET_ESP32S3
#define ADC_PIN               1      // Fresh water: ADC1_CH0
#define GREY_ADC_PIN          2      // Grey water:  ADC1_CH1
#elif CONFIG_IDF_TARGET_ESP32C3
#ifndef ADC_PIN
#define ADC_PIN               0      // Fresh water: ADC1_CH0
#endif
#ifndef GREY_ADC_PIN
#define GREY_ADC_PIN          1      // Grey water:  ADC1_CH1
#endif
#else
#ifndef ADC_PIN
#define ADC_PIN               34     // Fresh water: ADC1_CH6
#endif
#ifndef GREY_ADC_PIN
#define GREY_ADC_PIN          35     // Grey water:  ADC1_CH7
#endif
#endif
#define ADC_SAMPLES           8      // Oversampling per measurement (reduces ADC noise)
#define SENSOR_UPDATE_MS      1000   // Read the ADCs every second
#define FILTER_WINDOW_SIZE    75     // Moving average: 75 x 1 s = 75 s
#define DEFAULT_TANK_SIZE     100.0f // Fresh water tank capacity in liters (web UI)
#define DEFAULT_GREY_SIZE     90.0f  // Grey water tank capacity in liters (web UI)
#define GREY_TYPE_ELECTRODE   0
#define GREY_TYPE_FL          1
#define GREY_SENSOR_TYPE      GREY_TYPE_ELECTRODE
#define FL_DEFAULT_EMPTY_V    0.10f
#define FL_DEFAULT_FULL_V     2.40f
#define MAX_CALIB_POINTS      15     // Max. number of calibration points per tank
#define SRC_MANUFACTURER      0      // Advertisement: manufacturer specific data (passive)
#define SRC_SERVICE_DATA      1      // Advertisement: service data of a given UUID (passive)
#define COMPANY_ANY           -1     // Accept manufacturer data of any company ID
#define GAS_TYPE_DEFINITION   0      // DIMES / SRG WAVE or any sensor of the GAS SENSOR DEFINITION below
#define GAS_TYPE_MOPEKA       1      // Mopeka Pro family (Pro Check, Pro Check Universal, Pro Plus ...)
#define GAS_TYPE_MOPEKA_STD   2      // Mopeka Standard / Std Check (older model, CC2540 chip)
#define DEFAULT_GAS_TYPE      GAS_TYPE_DEFINITION
#define DEFAULT_MOPEKA_EMPTY_MM  38     // Europe 11 kg bottle
#define DEFAULT_MOPEKA_FULL_MM   366
#define MOPEKA_MIN_QUALITY       2
#define MOPEKA_COMPANY_ID        0x0059 // Nordic Semiconductor (used by all Mopeka Pro sensors)
#define MOPEKA_STD_COMPANY_ID    0x000D // Texas Instruments (Mopeka Standard)
#define DEFAULT_LPG_PROPANE      100
#define SENSOR_MODEL          "DIMES / SRG WAVE"
#define SENSOR_SOURCE         SRC_MANUFACTURER
#define SENSOR_COMPANY_ID     0xFFFF   // SRC_MANUFACTURER only (COMPANY_ANY = any)
#define SENSOR_UUID           ""       // SRC_SERVICE_DATA only: service data UUID
#define LEVEL_OFFSET          2
#define LEVEL_LEN             1        // 1, 2 or 4 bytes
#define LEVEL_BIG_ENDIAN      false
#define LEVEL_FACTOR          1.0f
#define LEVEL_ADD             0.0f
#define BATTERY_ENABLED       true     // false if the sensor does not report a battery level
#define BATTERY_OFFSET        1
#define BATTERY_LEN           1
#define BATTERY_BIG_ENDIAN    false
#define BATTERY_FACTOR        1.0f
#define BATTERY_ADD           0.0f
#define DEFAULT_CAPACITY      22.0f  // Gross bottle volume in liters (web UI)
#define DEFAULT_FILL_STOP_ON  true   // Bottle has a mechanical fill stop (web UI)
#define DEFAULT_FILL_STOP     80.0f  // Fill stop in % (web UI)
#define BLE_SCAN_INTERVAL     160    // 100 ms
#define BLE_SCAN_WINDOW       80     // 50 ms (50 % duty cycle)
#define BLE_MAX_SEEN          30     // Devices kept in the "nearby" list of the web UI
#define BLE_SEEN_TIMEOUT_MS   120000 // Drop devices from that list after 2 min silence
#define BLE_RAW_MAX           32     // Max. bytes kept for the raw data view
#define DATA_TIMEOUT_MS       (30UL * 60UL * 1000UL)
struct CalibPoint {
    float volt;
    float percent;         // Fill level in % (0-100) at this voltage; liters = percent * tank size
};
struct ValueMap {
    bool enabled;
    uint8_t offset;        // Byte offset in the payload
    uint8_t len;           // 1, 2 or 4 bytes (unsigned)
    bool big_endian;
    float factor;
    float add;
};
struct TankConfig {
    float tank_size;       // Tank capacity in liters
    bool filter_active;    // Moving-average filter on/off
    CalibPoint calibTable[MAX_CALIB_POINTS];  // Volt-to-percent table, sorted by voltage
    uint8_t calibCount;
};
struct AppConfig {
    char wifi_ssid[64];
    char wifi_pass[64];
    char ap_ssid[32];
    char ap_pass[32];
    int8_t wifi_tx_power;  // TX power in 0.25 dBm steps (see TX_POWER_OPTIONS)
    bool ap_always;        // true = own AP stays on while connected, false = fallback only
    char mqtt_server[64];
    uint16_t mqtt_port;
    char mqtt_user[32];
    char mqtt_pass[32];
    char mqtt_prefix[32];
    char web_user[32];     // Web UI login, empty = no login
    char web_pass[32];
    bool water_enabled;
    bool grey_enabled;
    bool gas_enabled;
    TankConfig fresh;
    TankConfig grey;
    uint8_t grey_type;     // GREY_TYPE_ELECTRODE or GREY_TYPE_FL
    char sensor_mac[18];   // "AA:BB:CC:DD:EE:FF" (upper case), empty = no sensor
    uint8_t gas_type;      // GAS_TYPE_DEFINITION or GAS_TYPE_MOPEKA
    uint16_t mopeka_empty_mm;  // Mopeka: liquid height of an empty bottle
    uint16_t mopeka_full_mm;   // Mopeka: liquid height of a full bottle
    uint8_t lpg_propane;       // Mopeka Standard: propane share of the gas in % (rest butane)
    float capacity;        // Gross bottle capacity in liters
    bool fill_stop_on;     // Bottle has a mechanical fill stop
    float fill_stop;       // Fill stop in %
};
struct WaterData {
    float raw_voltage;     // Raw voltage from the ADC
    float avg_voltage;     // Filtered voltage
    float liters;          // Calculated content in liters
    float percent;         // Calculated content in % (0-100)
};
struct GasData {
    bool has_data;         // At least one valid reading since boot
    float battery;         // Sensor battery in % (NAN = unknown)
    float raw_level;       // Raw sensor level in % (1:1 value; Mopeka: % between empty and full height)
    float distance_mm;     // Mopeka: measured liquid height in mm (NAN = none)
    float temperature;     // Mopeka: sensor temperature in °C (NAN = none)
    int8_t quality;        // Mopeka: read quality 0-3 (-1 = none)
    float level;           // Level scaled to the fill stop in %
    float content;         // Remaining content in liters
    int ble_rssi;          // Signal strength of the gas sensor
    unsigned long last_update;  // millis() of the last valid reading
    uint32_t updates;      // Counter of valid readings (used to detect new data)
    char ble_state[24];    // Human readable BLE state for the web UI / MQTT
    char raw_hex[BLE_RAW_MAX * 3 + 1];  // Last payload of the configured sensor as hex
    uint32_t adv_count;    // Advertisements received since boot (any device, for diagnosis)
    bool scanning;         // BLE scan is running
};
struct SensorData {
    WaterData water;       // Fresh water
    WaterData grey;        // Grey water
    GasData gas;
    int rssi;              // WiFi signal strength (written by wifi_manager)
    uint32_t wifi_drops;   // WiFi disconnects since boot
    char wifi_reason[32];  // Reason of the last WiFi disconnect
};
extern AppConfig config;
extern SensorData sensorData;
