hflocki/camper-mqtt/firmware/tanklevel/_arduino/camper_tanklevel/camper_tanklevel.ino

/*
 * Camper Tanklevel - fresh water, grey water and gas level on one ESP32
 * ======================================================================
 * Hardware: ESP32-C3 / ESP32
 *   - Fresh water: Votronic analog tank sender on ADC_PIN (ESP32-C3: GPIO0)
 *   - Grey water (optional): second Votronic tank sender on GREY_ADC_PIN (ESP32-C3: GPIO1)
 *   - Gas: BLE gas level sensor, received passively via the built-in Bluetooth LE
 *          (default: Rotarex DIMES / SRG WAVE, see GAS SENSOR DEFINITION in config.h)
 *
 * Values are published via MQTT (Home Assistant discovery) and shown in the web UI.
 */

#include <Arduino.h>
#include <ArduinoOTA.h>
#include <LittleFS.h>
#include <WiFi.h>

#include "config.h"
#include "wifi_manager.h"
#include "safeguard.h"
#include "water_sensor.h"
#include "gas_sensor.h"
#include "mqtt_ha.h"
#include "webserver.h"

AppConfig config;
SensorData sensorData;

static unsigned long lastStatusPrint = 0;

void setupOTA() {
    ArduinoOTA.setHostname(OTA_HOSTNAME);
    ArduinoOTA.setPassword(DEFAULT_OTA_PASSWORD);

    ArduinoOTA.onStart([]() {
        // Filesystem upload over the network replaces config.json too; unmount first
        if (ArduinoOTA.getCommand() != U_FLASH) LittleFS.end();
        String type = (ArduinoOTA.getCommand() == U_FLASH) ? "sketch" : "filesystem";
        Serial.println("[OTA] Start updating " + type);
    });
    ArduinoOTA.onEnd([]() {
        Serial.println("\n[OTA] Update complete!");
        if (ArduinoOTA.getCommand() == U_FLASH) guard::otaDone();
    });
    ArduinoOTA.onProgress([](unsigned int progress, unsigned int total) {
        unsigned int pct = (total > 0) ? (progress * 100U / total) : 0;
        Serial.printf("[OTA] Progress: %u%%\r", pct);
    });
    ArduinoOTA.onError([](ota_error_t error) {
        Serial.printf("[OTA] Error[%u]\n", error);
    });

    ArduinoOTA.begin();
    Serial.println("[OTA] Ready");
}

static void printRead() {
    const WaterData& w = sensorData.water;
    const WaterData& gr = sensorData.grey;
    const GasData& g = sensorData.gas;
    Serial.printf("[READ] Water: %.3f V | %.1f L | %.0f%% | Filter: %s\n",
        w.avg_voltage, w.liters, w.percent, config.fresh.filter_active ? "ON" : "OFF");
    if (config.grey_enabled) {
        Serial.printf("[READ] Grey:  %.3f V | %.1f L | %.0f%% | Filter: %s\n",
            gr.avg_voltage, gr.liters, gr.percent, config.grey.filter_active ? "ON" : "OFF");
    }
    Serial.printf("[READ] Gas:   %.1f%% (raw %.1f%%) | %.1f L | Battery: %.0f%% | BLE: %s\n",
        g.level, g.raw_level, g.content, g.battery, g.ble_state);
}

// WiFi start. A changed WiFi that does not connect is replaced by the previous, working
// one, followed by a restart so the wifi manager starts clean with it (safeguard.h).
static void startWiFi() {
    wifiManagerInit();
    if (!guard::wifiTrialPending()) return;
    if (isConnected()) { guard::wifiTrialOk(); return; }
    String ssid, pass, extra;
    if (!guard::wifiTrialRestore(ssid, pass, extra)) return;
    strlcpy(config.wifi_ssid, ssid.c_str(), sizeof(config.wifi_ssid));
    strlcpy(config.wifi_pass, pass.c_str(), sizeof(config.wifi_pass));
    saveConfig();
    Serial.println("[MAIN] New WiFi failed - previous WiFi restored, restarting");
    delay(200);
    ESP.restart();
}

void setup() {
    Serial.begin(115200);
    Serial.setTimeout(50);  // Do not block the loop while waiting for a line end
    delay(1000);

    Serial.println();
    Serial.println("========================================");
    Serial.println("  Camper Tanklevel v" FW_VERSION);
    Serial.println("========================================");
    Serial.println();

    guard::begin();   // may boot the previous firmware (failed update)
    memset(&sensorData, 0, sizeof(SensorData));

    // Phase 1: load config & mount LittleFS
    webserverInit();

    Serial.printf("[MAIN] Fresh water: %s | Grey water: %s | Gas: %s\n",
        config.water_enabled ? "on" : "off", config.grey_enabled ? "on" : "off",
        config.gas_enabled ? "on" : "off");

    // Phase 2: water tank ADCs
    if (config.water_enabled || config.grey_enabled) waterInit();

    // Phase 3: WiFi (blocking connect or AP fallback)
    startWiFi();

    // Phase 4: Bluetooth LE scanner (after WiFi, both share the radio)
    if (config.gas_enabled) {
        gasInit();
    } else {
        sensorData.gas.battery = NAN;
        strlcpy(sensorData.gas.ble_state, "Deaktiviert", sizeof(sensorData.gas.ble_state));
    }

    // Phase 5: start web server
    webserverStart();

    // Phase 6: OTA & MQTT
    setupOTA();
    mqttInit();

    Serial.printf("[MAIN] Setup done! Heap: %u\n", (unsigned)ESP.getFreeHeap());
}

void loop() {
    wifiManagerLoop();
    guard::loop(isConnected() || config.wifi_ssid[0] == '\0');
    ArduinoOTA.handle();

    if (config.water_enabled || config.grey_enabled) waterLoop();
    if (config.gas_enabled) gasLoop();
    mqttLoop();
    webserverLoop();

    if (Serial.available()) {
        String cmd = Serial.readStringUntil('\n');
        cmd.trim();
        if (cmd == "read") {
            printRead();
        } else if (cmd == "scan") {
            if (config.gas_enabled) gasPrintSeenList();
            else Serial.println("[CMD] Gas sensor is disabled");
        } else if (cmd == "filter") {
            config.fresh.filter_active = !config.fresh.filter_active;
            saveConfig();
            Serial.printf("[CMD] Fresh water filter: %s\n", config.fresh.filter_active ? "ON" : "OFF");
        } else if (cmd == "noauth") {
            // Forgotten web login: switch it off over USB
            config.web_user[0] = '\0';
            config.web_pass[0] = '\0';
            saveConfig();
            Serial.println("[CMD] Web login removed");
        } else if (cmd == "help") {
            Serial.println("[CMD] Commands: read, scan, filter, noauth, help");
        }
    }

    if (millis() - lastStatusPrint > 10000) {
        lastStatusPrint = millis();
        Serial.printf("[STATUS] Water:%.1fL (%.0f%%) Grey:%.1fL Gas:%.1f%% %s Adv:%lu WiFi:%s MQTT:%s Heap:%u\n",
            sensorData.water.liters, sensorData.water.percent, sensorData.grey.liters,
            sensorData.gas.level, sensorData.gas.ble_state,
            (unsigned long)sensorData.gas.adv_count,
            getWiFiStateString().c_str(),
            mqttIsConnected() ? "OK" : "---",
            (unsigned)ESP.getFreeHeap());
    }

    delay(5);
    yield();
}
