hflocki/camper-mqtt/firmware/toolbox/camper_toolbox/config.h

#define CONFIG_H
#include <Arduino.h>
#if __has_include("config_local.h")
#include "config_local.h"
#endif
#define PLUGIN_CARAWATER      0      // Water pump: CaraWater (e.g. ISP 15), BLE connection (counts towards 3)
#define PLUGIN_RVTECH         1      // Roof hatch: RV Tech skylight motor control, BLE connection (counts towards 3)
#define PLUGIN_WCS_FRIDGE     0      // Fridge: WCS compressor fridge, BLE connection (counts towards 3)
#define CT_BLE_PASSIVE  0   // passive plugins (only listen to advertisements); none at the moment
#define CT_BLE_LINKS    (PLUGIN_CARAWATER + PLUGIN_RVTECH + PLUGIN_WCS_FRIDGE)
#define CT_USE_BLE      ((CT_BLE_PASSIVE + CT_BLE_LINKS) > 0)
#define CT_PLUGIN_COUNT (CT_BLE_PASSIVE + CT_BLE_LINKS)
#if CT_BLE_LINKS > 3
#error "At most 3 connecting BLE plugins fit on one ESP32: PLUGIN_CARAWATER + PLUGIN_RVTECH + PLUGIN_WCS_FRIDGE must be 3 or less"
#endif
#if CT_PLUGIN_COUNT > 8
#error "At most 8 plugin instances per device"
#endif
#if CT_PLUGIN_COUNT == 0
#warning "No plugin selected in config.h - the device only offers WiFi, MQTT and the web UI"
#endif
#define FW_VERSION            "1.2.2"
#define FW_DEVICE             "toolbox"   // device id in the firmware marker (fwcheck.h)
#define ENABLE_ARDUINO_OTA    1
#define DEVICE_NAME           "Toolbox Node"      // Name in Home Assistant and in the web UI
#define DEFAULT_AP_SSID       "Toolbox-Node"      // Base name; "-XXXXXX" (last 3 MAC bytes) is appended
#define DEFAULT_AP_PASSWORD   "campertoolbox1234"   // Test placeholder (min. 8 characters) - change in the web UI
#define DEFAULT_OTA_PASSWORD  "campertoolbox1234"   // Test placeholder - change before the first flash
#define DEFAULT_MQTT_SERVER   ""                 // Set in the web UI
#define DEFAULT_MQTT_PORT     1883
#define DEFAULT_WIFI_SSID       ""
#define DEFAULT_WIFI_PASSWORD   ""
#define DEFAULT_MQTT_USER       ""
#define DEFAULT_MQTT_PASSWORD   ""
#define DEFAULT_WEB_USER        ""      // empty = no login
#define DEFAULT_WEB_PASSWORD    ""
#define DEFAULT_MQTT_PREFIX   "camper/toolbox"
#define DEFAULT_TX_POWER      70
#define DEFAULT_AP_ALWAYS     true
#define AP_FALLBACK_MS        60000  // AP-only-as-fallback: start the AP after 60 s without WiFi
#define MQTT_CORE_MS          30000  // Device status / WiFi RSSI publish interval
#define WS_UPDATE_MS          1000   // Web UI live update interval
#define CONFIG_FILE           "/config.json"
#define OTA_HOSTNAME          "toolbox-node"
#define BLE_SCAN_INTERVAL     160    // 100 ms
#define BLE_SCAN_WINDOW       80     // 50 ms (50 % duty cycle)
#define BLE_MAX_SEEN          30     // Devices kept in the "nearby" list of the web UI
#define BLE_SEEN_TIMEOUT_MS   120000 // Drop devices from that list after 2 min silence
#define BLE_RAW_MAX           32     // Max. bytes kept for the raw data view
#define BLE_CONNECT_TIMEOUT   4000   // Connection attempt timeout in ms (non-blocking)
#define BLE_RETRY_MS          10000  // Wait between connection attempts
#define BLE_RETRY_MAX_MS      60000  // Back-off limit while the device is out of range
#define BLE_RELEASE_MS        (30UL * 60UL * 1000UL) // "Release for the app" ends after 30 min (0 = never)
#define PUMP_SERVICE_UUID     "0000ff00-0000-1000-8000-00805f9b34fb"
#define PUMP_NOTIFY_UUID      "0000ff01-0000-1000-8000-00805f9b34fb"
#define PUMP_WRITE_UUID       "0000ff02-0000-1000-8000-00805f9b34fb"
#define PUMP_ALT_SERVICE_UUID "0000fff0-0000-1000-8000-00805f9b34fb"
#define PUMP_ALT_NOTIFY_UUID  "0000fff1-0000-1000-8000-00805f9b34fb"
#define PUMP_ALT_WRITE_UUID   "0000fff2-0000-1000-8000-00805f9b34fb"
#define PUMP_UART_SERVICE_UUID "0000ffe0-0000-1000-8000-00805f9b34fb"
#define PUMP_UART_CHAR_UUID    "0000ffe1-0000-1000-8000-00805f9b34fb"
#define PUMP_OFFLINE_MS       10000  // No status frame for 10 s = pump offline
#define MQTT_PUMP_MS          10000  // Periodic publish (also published on changes)
#define RVTECH_SERVICE_UUID   "0000ffe0-0000-1000-8000-00805f9b34fb"
#define RVTECH_CHAR_UUID      "0000ffe1-0000-1000-8000-00805f9b34fb"
#define RVTECH_TARGET_TIMEOUT_MS 60000 // A sent target counts as "moving" for at most 60 s
#define RVTECH_SEND_WAIT_MS   10000  // A command waits this long for a (re)connection
#define MQTT_RVTECH_MS        30000
#define WCS_SERVICE_UUID      "0000ffe0-0000-1000-8000-00805f9b34fb"
#define WCS_CHAR_UUID         "0000ffe1-0000-1000-8000-00805f9b34fb"
#define WCS_OFFLINE_MS        120000 // No status message for 2 min = fridge offline
#define MQTT_WCS_MS           30000
struct AppConfig {
    char wifi_ssid[64];
    char wifi_pass[64];
    char ap_ssid[32];
    char ap_pass[32];
    int8_t wifi_tx_power;  // TX power in 0.25 dBm steps (see TX_POWER_OPTIONS)
    bool ap_always;        // true = own AP stays on while connected, false = fallback only
    char mqtt_server[64];
    uint16_t mqtt_port;
    char mqtt_user[32];
    char mqtt_pass[32];
    char mqtt_prefix[32];
    char web_user[32];     // Web UI login, empty = no login
    char web_pass[32];
};
struct CoreData {
    int rssi;              // WiFi signal strength (written by wifi_manager)
    uint32_t wifi_drops;   // WiFi disconnects since boot
    char wifi_reason[32];  // Reason of the last WiFi disconnect
};
extern AppConfig config;
extern CoreData coreData;
