hflocki/camper-mqtt/firmware/maxxfan/camper_maxxfan/webserver.cpp

#include "webserver.h"
#include "config.h"
#include "settings.h"
#include "fan_control.h"
#include "wifi_manager.h"
#include "mqtt_ha.h"
#include "system.h"
#include "safeguard.h"
#include "fwcheck.h"
#include "evlog.h"
#include <WiFi.h>
#include <LittleFS.h>
#include <ESPAsyncWebServer.h>
#include <DNSServer.h>
#include <Update.h>
#include <ArduinoJson.h>

namespace {

AsyncWebServer server(80);
DNSServer dns;
bool dnsRunning = false;
bool updateAuthorized = false;
bool fsReady = false;

// Upload kinds, chosen by the file name (see handleUpdateChunk)
enum UploadKind : uint8_t { UP_FIRMWARE, UP_FS_IMAGE, UP_WEBPAGE };
UploadKind upKind = UP_FIRMWARE;
File upFile;
bool upFailed = false;
String upError;   // reason of a failed web page / filesystem upload
const char* WEB_TMP = "/index.html.gz.tmp";
const char* WEB_FILE = "/index.html.gz";

// Shown when the LittleFS image (data/index.html.gz) has not been uploaded yet.
// Keeps the firmware update working, so the device can always be recovered from the browser.
const char FALLBACK_PAGE[] = R"HTML(<!doctype html><html lang="de"><head><meta charset="utf-8">
<meta name="viewport" content="width=device-width,initial-scale=1"><title>MaxxFan Node</title>
<style>body{font-family:system-ui,sans-serif;background:#0f1419;color:#e8f0f8;max-width:520px;margin:40px auto;padding:0 16px}
code{background:#1e2d3d;padding:2px 6px;border-radius:4px}button{padding:10px 16px;margin-top:10px}</style></head><body>
<h2>MaxxFan Node</h2><p>Die Web-Oberfl&auml;che fehlt. Bitte das LittleFS-Image hochladen
(<code>data/index.html.gz</code>, Arduino IDE: <em>Upload LittleFS</em>).</p>
<p>Hier hochladen: <code>data/index.html.gz</code> (Web-Oberfl&auml;che), ein LittleFS-Image oder die Firmware (.bin):</p>
<form method="POST" action="/api/update" enctype="multipart/form-data">
<input type="file" name="fw" accept=".bin,.gz"><br><button>Hochladen</button></form></body></html>)HTML";

bool auth(AsyncWebServerRequest* r) {
  if (settings.webUser.isEmpty()) return true;
  if (r->authenticate(settings.webUser.c_str(), settings.webPass.c_str())) return true;
  r->requestAuthentication();
  return false;
}

String param(AsyncWebServerRequest* r, const char* name, const String& def = "") {
  if (r->hasParam(name, true)) return r->getParam(name, true)->value();
  if (r->hasParam(name))       return r->getParam(name)->value();
  return def;
}

void sendJson(AsyncWebServerRequest* r, JsonDocument& doc, int code = 200) {
  String out;
  serializeJson(doc, out);
  r->send(code, "application/json", out);
}

void sendOk(AsyncWebServerRequest* r, bool ok = true) {
  r->send(ok ? 200 : 400, "application/json", ok ? "{\"ok\":true}" : "{\"ok\":false}");
}

void handleState(AsyncWebServerRequest* r) {
  if (!auth(r)) return;
  JsonDocument d;
  d["fw"]       = FW_VERSION;
  d["expander"] = fan::expanderOk();
  d["sync"]     = fan::syncRunning();
  d["syncPort"] = settings.syncPort;
  JsonArray ports = d["ports"].to<JsonArray>();
  for (uint8_t p = 0; p < 2; p++) {
    JsonObject o = ports.add<JsonObject>();
    o["label"]   = PORT_LABELS[p];
    o["enabled"] = settings.portEnabled[p];
    o["hold"]    = fan::autoHold(p);
    o["led"]     = fan::led(p);
  }
  d["sta"]    = wifimgr::staConnected();
  d["ap"]     = wifimgr::apActive();
  d["ip"]     = wifimgr::ipString();
  d["rssi"]   = wifimgr::rssi();
  d["mqtt"]   = mqttha::connected();
  d["uptime"] = millis() / 1000;
  d["guard"]  = guard::status();
  sendJson(r, d);
}

void handleGetConfig(AsyncWebServerRequest* r) {
  if (!auth(r)) return;
  JsonDocument d;
  d["hostname"] = settings.hostname;
  d["ssid"]     = settings.wifiSsid;
  d["static_ip"] = settings.staticIp;
  d["ip"]       = settings.ip;
  d["gw"]       = settings.gateway;
  d["sn"]       = settings.subnet;
  d["dns"]      = settings.dns;
  d["mhost"]    = settings.mqttHost;
  d["mport"]    = settings.mqttPort;
  d["muser"]    = settings.mqttUser;
  d["prefix"]   = settings.mqttPrefix;
  d["disc"]     = settings.discovery;
  d["wuser"]    = settings.webUser;
  d["p0"]       = settings.portEnabled[0];
  d["p1"]       = settings.portEnabled[1];
  d["pulse"]    = settings.pulseMs;
  d["syncport"] = settings.syncPort;
  d["apssid"]   = wifimgr::apSsid();
  // Passwords are never sent back; empty field in the form = keep
  sendJson(r, d);
}

void handleSetConfig(AsyncWebServerRequest* r) {
  if (!auth(r)) return;
  auto b = [&](const char* n) { return param(r, n) == "1" || param(r, n) == "on" || param(r, n) == "true"; };
  auto keepIfEmpty = [&](const char* n, String& target) { String v = param(r, n); if (v.length()) target = v; };

  String host = param(r, "hostname"); host.trim();
  if (host.length()) settings.hostname = host;

  // WiFi change while connected: keep the working values as fallback (safeguard.h)
  String oldSsid = settings.wifiSsid, oldPass = settings.wifiPass, oldNet = wifimgr::netString();

  settings.wifiSsid = param(r, "ssid"); settings.wifiSsid.trim();
  keepIfEmpty("wpass", settings.wifiPass);
  settings.staticIp = b("static_ip");
  settings.ip      = param(r, "ip");
  settings.gateway = param(r, "gw");
  settings.subnet  = param(r, "sn");
  settings.dns     = param(r, "dns");
  if (wifimgr::staConnected() &&
      (settings.wifiSsid != oldSsid || settings.wifiPass != oldPass || wifimgr::netString() != oldNet)) {
    guard::wifiTrialStart(oldSsid, oldPass, oldNet);
  }

  String ap = param(r, "appass");
  if (ap.length() >= 8) settings.apPass = ap;

  settings.mqttHost = param(r, "mhost"); settings.mqttHost.trim();
  settings.mqttPort = param(r, "mport", String(DEFAULT_MQTT_PORT)).toInt();
  if (settings.mqttPort == 0) settings.mqttPort = DEFAULT_MQTT_PORT;
  settings.mqttUser = param(r, "muser");
  keepIfEmpty("mpass", settings.mqttPass);
  if (settings.mqttUser.isEmpty()) settings.mqttPass = "";
  String prefix = param(r, "prefix"); prefix.trim();
  if (prefix.length()) settings.mqttPrefix = prefix;
  settings.discovery = b("disc");

  settings.webUser = param(r, "wuser"); settings.webUser.trim();
  keepIfEmpty("wpw", settings.webPass);
  if (settings.webUser.isEmpty()) settings.webPass = "";

  settings.portEnabled[0] = b("p0");
  settings.portEnabled[1] = b("p1");
  int pulse = param(r, "pulse", String(DEFAULT_PULSE_MS)).toInt();
  settings.pulseMs = constrain(pulse, 50, 2000);
  settings.syncPort = param(r, "syncport", "1").toInt() == 0 ? 0 : 1;

  settingsSave();
  evlog::add("Einstellungen gespeichert, Neustart");
  sendOk(r);
  requestReboot(1000);
}

void handlePress(AsyncWebServerRequest* r) {
  if (!auth(r)) return;
  int port = param(r, "port", "-1").toInt();
  FanButton btn = fan::buttonFromKey(param(r, "btn"));
  sendOk(r, port >= 0 && port <= 1 && btn != BTN_COUNT && fan::requestPress(port, btn));
}

void handleSpeed(AsyncWebServerRequest* r) {
  if (!auth(r)) return;
  int port = param(r, "port", "-1").toInt();
  sendOk(r, port >= 0 && port <= 1 && fan::requestSpeed(port, param(r, "level", "0").toInt()));
}

void handleLed(AsyncWebServerRequest* r) {
  if (!auth(r)) return;
  int port = param(r, "port", "-1").toInt();
  sendOk(r, port >= 0 && port <= 1 && fan::requestLed(port, param(r, "on") == "1"));
}

void handleUpdateDone(AsyncWebServerRequest* r) {
  if (!auth(r)) return;
  if (!updateAuthorized) { r->send(401, "text/plain", "Login fehlt"); return; }
  if (upKind == UP_WEBPAGE) {
    // Only the web page was replaced: no restart needed
    if (upFailed) r->send(500, "text/plain", "Web-Oberfläche nicht gespeichert: " + upError);
    else r->send(200, "text/plain", "OK web");
    return;
  }
  if (upKind == UP_FS_IMAGE) {
    bool ok = !upFailed && !Update.hasError();
    r->send(ok ? 200 : 500, "text/plain", ok ? "OK" : "Dateisystem-Abbild fehlgeschlagen: " + upError);
    if (ok) requestReboot(1000);
    return;
  }
  // firmware: checked and written by fwcheck
  if (!fwcheck::ok()) { r->send(400, "text/plain", "Update abgelehnt: " + fwcheck::error()); return; }
  guard::otaDone();
  r->send(200, "text/plain", "OK");
  requestReboot(1000);
}

// One upload field for everything, the file name decides:
//   *.gz                         -> replaces the web page (index.html.gz) in LittleFS
//   *littlefs* / *spiffs* (.bin) -> complete LittleFS image (Arduino IDE / mklittlefs)
//   any other .bin               -> firmware
void handleUpdateChunk(AsyncWebServerRequest* r, const String& filename, size_t index,
                       uint8_t* data, size_t len, bool final) {
  if (index == 0) {
    updateAuthorized = settings.webUser.isEmpty() ||
                       r->authenticate(settings.webUser.c_str(), settings.webPass.c_str());
    if (!updateAuthorized) return;
    String n = filename;
    n.toLowerCase();
    upFailed = false;
    if (n.endsWith(".gz"))                                   upKind = UP_WEBPAGE;
    else if (n.indexOf("littlefs") >= 0 || n.indexOf("spiffs") >= 0) upKind = UP_FS_IMAGE;
    else                                                     upKind = UP_FIRMWARE;
    Serial.printf("[ota] web upload (%s): %s\n",
                  upKind == UP_WEBPAGE ? "web page" : upKind == UP_FS_IMAGE ? "filesystem" : "firmware",
                  filename.c_str());
    upError = "";
    if (upKind == UP_WEBPAGE) {
      upFile = fsReady ? LittleFS.open(WEB_TMP, "w") : File();
      if (!upFile) { upFailed = true; upError = "LittleFS nicht beschreibbar"; }
    } else if (upKind == UP_FS_IMAGE) {
      if (fsReady) LittleFS.end();   // the image replaces the whole partition
      fsReady = false;
      if (!Update.begin(UPDATE_SIZE_UNKNOWN, U_SPIFFS)) { upFailed = true; upError = Update.errorString(); }
    } else {
      fwcheck::begin(r->contentLength(), r->hasParam("force"));
    }
  }
  if (!updateAuthorized) return;

  if (upKind == UP_WEBPAGE) {
    if (upFailed) return;
    if (len && upFile.write(data, len) != len) { upFailed = true; upError = "Schreibfehler (Speicher voll?)"; }
    if (final) {
      upFile.close();
      if (!upFailed) {
        LittleFS.remove(WEB_FILE);
        upFailed = !LittleFS.rename(WEB_TMP, WEB_FILE);
      } else {
        LittleFS.remove(WEB_TMP);
      }
      if (upFailed && upError.isEmpty()) upError = "Umbenennen fehlgeschlagen";
      if (upFailed) evlog::add("Web-Oberfläche nicht gespeichert: %s", upError.c_str());
      else evlog::add("Web-Oberfläche ersetzt (%u kB)", (unsigned)((index + len) / 1024));
    }
    return;
  }

  if (upKind == UP_FIRMWARE) {
    fwcheck::chunk(data, len, final);
    return;
  }

  // complete LittleFS image
  if (upFailed) return;
  if (len && Update.write(data, len) != len) { upFailed = true; upError = Update.errorString(); Update.abort(); return; }
  if (final) {
    if (Update.end(true)) evlog::add("Dateisystem-Abbild geschrieben (%u kB), Neustart", (unsigned)((index + len) / 1024));
    else { upFailed = true; upError = Update.errorString(); }
    if (upFailed) evlog::add("Dateisystem-Abbild fehlgeschlagen: %s", upError.c_str());
  }
}

} // namespace

namespace web {

void begin() {
  fsReady = LittleFS.begin(true);   // formats automatically if the mount fails
  if (!fsReady) Serial.println("[web] LittleFS mount failed");

  // Serve ONLY the web page from the filesystem (stored gzip compressed)
  server.on("/", HTTP_GET, [](AsyncWebServerRequest* r) {
    if (!auth(r)) return;
    if (fsReady && LittleFS.exists("/index.html.gz")) {
      AsyncWebServerResponse* resp = r->beginResponse(LittleFS, "/index.html.gz", "text/html");
      resp->addHeader("Content-Encoding", "gzip");
      resp->addHeader("Cache-Control", "no-cache");
      r->send(resp);
    } else if (fsReady && LittleFS.exists("/index.html")) {
      r->send(LittleFS, "/index.html", "text/html");
    } else {
      r->send(200, "text/html", FALLBACK_PAGE);
    }
  });

  server.on("/api/state",  HTTP_GET,  handleState);
  server.on("/api/config", HTTP_GET,  handleGetConfig);
  server.on("/api/config", HTTP_POST, handleSetConfig);
  server.on("/api/press",  HTTP_POST, handlePress);
  server.on("/api/led",    HTTP_POST, handleLed);
  server.on("/api/speed",  HTTP_POST, handleSpeed);
  server.on("/api/close",  HTTP_POST, [](AsyncWebServerRequest* r) {
    if (!auth(r)) return;
    int port = param(r, "port", "-1").toInt();
    sendOk(r, port >= 0 && port <= 1 && fan::requestClose(port));
  });
  server.on("/api/sync",   HTTP_POST, [](AsyncWebServerRequest* r) {
    if (!auth(r)) return;
    sendOk(r, fan::requestSyncOff());
  });
  server.on("/api/reboot", HTTP_POST, [](AsyncWebServerRequest* r) {
    if (!auth(r)) return;
    evlog::add("Neustart über die Web-Oberfläche");
    sendOk(r);
    requestReboot();
  });
  server.on("/api/factory", HTTP_POST, [](AsyncWebServerRequest* r) {
    if (!auth(r)) return;
    settingsFactoryReset();
    sendOk(r);
    requestReboot();
  });
  server.on("/api/update", HTTP_POST, handleUpdateDone, handleUpdateChunk);

  // Firmware info for the update check in the browser, and the event log
  server.on("/api/system", HTTP_GET, [](AsyncWebServerRequest* r) {
    if (!auth(r)) return;
    JsonDocument d;
    fwcheck::info(d["fw"].to<JsonObject>());
    evlog::json(d["log"].to<JsonArray>());
    d["up"] = millis() / 1000;
    sendJson(r, d);
  });

  // Captive portal: redirect everything to the UI while the setup AP is up
  server.onNotFound([](AsyncWebServerRequest* r) {
    if (wifimgr::apActive()) r->redirect("http://" + WiFi.softAPIP().toString() + "/");
    else r->send(404, "text/plain", "Not found");
  });

  server.begin();
  Serial.println("[web] server started");
}

void loop() {
  if (wifimgr::apActive() && !dnsRunning) {
    dns.start(53, "*", WiFi.softAPIP());
    dnsRunning = true;
  } else if (!wifimgr::apActive() && dnsRunning) {
    dns.stop();
    dnsRunning = false;
  }
  if (dnsRunning) dns.processNextRequest();
}

} // namespace web
