hflocki/camper-mqtt/firmware/display/camper_display/weather.cpp

#include "weather.h"
#include "alerts.h"
#include "config.h"
#include "settings.h"
#include "wifi_manager.h"
#include <ArduinoJson.h>
#include <HTTPClient.h>
#include <NetworkClientSecure.h>
#include <freertos/FreeRTOS.h>
#include <freertos/semphr.h>
#include <freertos/task.h>

namespace wx {
namespace {

SemaphoreHandle_t lock = nullptr;

// The UI and the web server read the data before begin() runs, so create the mutex on first use.
void take() {
  if (!lock) lock = xSemaphoreCreateMutex();
  xSemaphoreTake(lock, portMAX_DELAY);
}
void give() { xSemaphoreGive(lock); }
TaskHandle_t task = nullptr;
Data cur;
String lastStatus = "";
float gpsLat = NAN, gpsLon = NAN;       // from the MQTT position topic
volatile bool wakeUp = false;
const uint32_t RETRY_MS = 2UL * 60 * 1000;

const char* const API = "https://api.open-meteo.com/v1/forecast";

// Root certificates of the ESP32 core (Mozilla bundle), also used by notify.cpp
extern const uint8_t x509_crt_bundle_start[] asm("_binary_x509_crt_bundle_start");
extern const uint8_t x509_crt_bundle_end[]   asm("_binary_x509_crt_bundle_end");

String gpsPlace;                        // reverse geocoded name of the GPS position
float placeLat = NAN, placeLon = NAN;   // position gpsPlace belongs to

bool position(float& lat, float& lon, bool& gps) {
  gps = false;
  if (settings.wxTopic.length() && !isnan(gpsLat)) { lat = gpsLat; lon = gpsLon; gps = true; return true; }
  if (settings.wxLat.length() && settings.wxLon.length()) {
    lat = settings.wxLat.toFloat();
    lon = settings.wxLon.toFloat();
    return !(lat == 0 && lon == 0) && fabsf(lat) <= 90 && fabsf(lon) <= 180;
  }
  return false;
}

void setStatus(const String& s) {
  if (s != lastStatus) Serial.println("[wx] " + s);
  take();
  lastStatus = s;
  give();
}

float num(JsonVariantConst v) { return v.is<float>() ? v.as<float>() : NAN; }

bool fetch(float lat, float lon, bool fromGps) {
  char url[512];
  snprintf(url, sizeof(url),
           "%s?latitude=%.4f&longitude=%.4f"
           "&current=temperature_2m,relative_humidity_2m,apparent_temperature,is_day,weather_code,"
           "wind_speed_10m,wind_direction_10m,wind_gusts_10m"
           "&hourly=precipitation,precipitation_probability&forecast_hours=2"
           "&daily=weather_code,temperature_2m_max,temperature_2m_min,precipitation_sum,"
           "precipitation_probability_max,wind_gusts_10m_max,sunrise,sunset&forecast_days=%d&timezone=auto&timeformat=unixtime",
           API, lat, lon, DAYS);
  NetworkClientSecure client;
  client.setCACertBundle(x509_crt_bundle_start, x509_crt_bundle_end - x509_crt_bundle_start);
  HTTPClient http;
  http.setTimeout(10000);
  http.useHTTP10(true);   // no chunked transfer encoding, so the JSON can be parsed straight from the stream
  if (!http.begin(client, url)) { setStatus("Wetter: keine Verbindung"); return false; }
  int code = http.GET();
  if (code != 200) {
    setStatus("Wetter: Fehler " + String(code) + (code < 0 ? " (" + http.errorToString(code) + ")" : String("")));
    http.end();
    return false;
  }
  JsonDocument doc;
  DeserializationError err = deserializeJson(doc, http.getStream());
  http.end();
  if (err) { setStatus(String("Wetter: ") + err.c_str()); return false; }

  Data d;
  JsonObjectConst c = doc["current"];
  d.temp = num(c["temperature_2m"]);
  d.feels = num(c["apparent_temperature"]);
  d.hum = num(c["relative_humidity_2m"]);
  d.wind = num(c["wind_speed_10m"]);
  d.gust = num(c["wind_gusts_10m"]);
  d.dir = c["wind_direction_10m"] | -1;
  d.code = c["weather_code"] | -1;
  d.day = (c["is_day"] | 1) == 1;
  JsonObjectConst h = doc["hourly"];
  // hourly values are for the preceding hour: index 1 is the coming hour
  int hi = h["precipitation"].size() > 1 ? 1 : 0;
  d.rainNext = num(h["precipitation"][hi]);
  d.popNext = num(h["precipitation_probability"][hi]);
  JsonObjectConst dl = doc["daily"];
  for (int i = 0; i < DAYS; i++) {
    d.dCode[i] = dl["weather_code"][i] | -1;
    if (i == 0) { d.sunrise = dl["sunrise"][0] | 0L; d.sunset = dl["sunset"][0] | 0L; }
    d.tMax[i] = num(dl["temperature_2m_max"][i]);
    d.tMin[i] = num(dl["temperature_2m_min"][i]);
    d.rainSum[i] = num(dl["precipitation_sum"][i]);
    d.popMax[i] = num(dl["precipitation_probability_max"][i]);
    d.gustMax[i] = num(dl["wind_gusts_10m_max"][i]);
  }
  d.lat = lat;
  d.lon = lon;
  d.gps = fromGps;
  d.valid = !isnan(d.temp) && d.code >= 0;
  d.at = time(nullptr);
  if (!d.valid) { setStatus("Wetter: unvollständige Antwort"); return false; }
  take();
  cur = d;
  give();
  struct tm tm;
  localtime_r(&d.at, &tm);
  char b[32];
  snprintf(b, sizeof(b), "Stand %02d:%02d", tm.tm_hour, tm.tm_min);
  setStatus(b);
  Serial.printf("[wx] %.1f C, code %d, gusts %.0f km/h (%.3f, %.3f)\n", d.temp, d.code, d.gust, lat, lon);
  return true;
}

// distance in km between two positions (good enough for "moved a bit")
float distKm(float la1, float lo1, float la2, float lo2) {
  float x = (lo2 - lo1) * cosf((la1 + la2) * 0.5f * DEG_TO_RAD);
  float y = la2 - la1;
  return sqrtf(x * x + y * y) * 111.2f;
}

// Place name for a GPS position from OpenStreetMap Nominatim (free, no key). Their usage policy asks for
// an identifying User-Agent and at most one request per second; we ask only after moving more than 5 km.
void reverseGeocode(float lat, float lon) {
  char url[200];
  snprintf(url, sizeof(url),
           "https://nominatim.openstreetmap.org/reverse?format=jsonv2&lat=%.5f&lon=%.5f&zoom=12&accept-language=de",
           lat, lon);
  NetworkClientSecure client;
  client.setCACertBundle(x509_crt_bundle_start, x509_crt_bundle_end - x509_crt_bundle_start);
  HTTPClient http;
  http.setTimeout(10000);
  http.useHTTP10(true);
  http.setUserAgent(FW_NAME "/" FW_VERSION " (ESP32 camper display, weather place name)");
  if (!http.begin(client, url)) return;
  int code = http.GET();
  if (code != 200) {
    Serial.printf("[wx] place lookup failed: %d\n", code);
    http.end();
    placeLat = lat;   // do not retry at once; next try after moving on
    placeLon = lon;
    return;
  }
  JsonDocument filter;
  filter["address"] = true;
  filter["name"] = true;
  JsonDocument doc;
  DeserializationError err = deserializeJson(doc, http.getStream(), DeserializationOption::Filter(filter));
  http.end();
  if (err) return;
  JsonObjectConst a = doc["address"];
  const char* keys[] = {"village", "town", "city", "municipality", "hamlet", "suburb", "county"};
  String name;
  for (const char* k : keys) {
    if (a[k].is<const char*>()) { name = a[k].as<const char*>(); break; }
  }
  if (name.isEmpty() && doc["name"].is<const char*>()) name = doc["name"].as<const char*>();
  take();
  gpsPlace = name;
  placeLat = lat;
  placeLon = lon;
  give();
  Serial.printf("[wx] place: %s\n", name.c_str());
}

void run(void*) {
  uint32_t next = 0;
  for (;;) {
    vTaskDelay(pdMS_TO_TICKS(1000));
    if (!settings.wxOn) { next = 0; continue; }
    if (!wifimgr::staConnected()) continue;
    float lat, lon;
    bool gps;
    if (!position(lat, lon, gps)) {
      setStatus(settings.wxTopic.length() ? "Warte auf Position (MQTT)" : "Kein Standort eingestellt");
      continue;
    }
    Data d = get();
    bool moved = d.valid && !isnan(d.lat) && distKm(d.lat, d.lon, lat, lon) > 5;
    uint32_t now = millis();
    if (!wakeUp && !moved && next && (int32_t)(now - next) < 0) continue;
    wakeUp = false;
    bool ok = fetch(lat, lon, gps);
    if (ok && gps && (isnan(placeLat) || distKm(placeLat, placeLon, lat, lon) > 5)) reverseGeocode(lat, lon);
    uint32_t every = (uint32_t)constrain((int)settings.wxEvery, 10, 180) * 60UL * 1000UL;
    next = millis() + (ok ? every : RETRY_MS);
  }
}

}  // namespace

void begin() {
  if (!lock) lock = xSemaphoreCreateMutex();
  if (task) return;
  xTaskCreatePinnedToCore(run, "wx", 12288, nullptr, 1, &task, 0);
}

void loop() {}

Data get() {
  take();
  Data d = cur;
  give();
  return d;
}

bool enabled() { return settings.wxOn; }

String status() {
  if (!settings.wxOn) return "Wetter aus";
  take();
  String s = lastStatus;
  give();
  return s;
}

void requestUpdate() { wakeUp = true; }

String place() {
  take();
  String s = gpsPlace;
  give();
  return s;
}

namespace {
float toNum(JsonVariantConst v) {
  if (v.is<const char*>()) return String(v.as<const char*>()).toFloat();
  return v.is<float>() ? v.as<float>() : NAN;
}

// Looks for lat/lon in an object and, if not there, in nested objects (max. 3 levels), e.g. the
// Teltonika "Data to Server" format {"TIME":{...},"GPS":{"latitude":..,"longitude":..,"fix_status":1}}.
// Returns false for an object that reports no GPS fix.
bool findPos(JsonObjectConst o, float& lat, float& lon, int depth) {
  float la = NAN, lo = NAN;
  bool noFix = false;
  for (JsonPairConst kv : o) {
    String k = kv.key().c_str();
    k.toLowerCase();
    if (k == "lat" || k == "latitude") la = toNum(kv.value());
    else if (k == "lon" || k == "lng" || k == "long" || k == "longitude") lo = toNum(kv.value());
    else if (k == "fix_status" || k == "fix") noFix = toNum(kv.value()) == 0;
  }
  if (!isnan(la) && !isnan(lo)) {
    if (noFix) return false;
    lat = la;
    lon = lo;
    return true;
  }
  if (depth >= 3) return false;
  for (JsonPairConst kv : o)
    if (kv.value().is<JsonObjectConst>() && findPos(kv.value().as<JsonObjectConst>(), lat, lon, depth + 1)) return true;
  return false;
}
}  // namespace

bool onMessage(const char* topic, const char* payload, unsigned int len) {
  if (settings.wxTopic.isEmpty() || settings.wxTopic != topic) return false;
  String p;
  p.reserve(len);
  for (unsigned i = 0; i < len; i++) p += payload[i];
  float lat = NAN, lon = NAN;
  JsonDocument doc;
  if (!deserializeJson(doc, p) && doc.is<JsonObject>()) {
    // {"lat":..,"lon":..}, {"latitude":..,"longitude":..}, {"LAT":"..","LNG":".."}, nested like the RUT956 ...
    findPos(doc.as<JsonObjectConst>(), lat, lon, 0);
  } else {
    int c = p.indexOf(',');   // "52.52,13.40"
    if (c > 0) { lat = p.substring(0, c).toFloat(); lon = p.substring(c + 1).toFloat(); }
  }
  if (isnan(lat) || isnan(lon) || (lat == 0 && lon == 0) || fabsf(lat) > 90 || fabsf(lon) > 180) return true;
  bool first = isnan(gpsLat);
  gpsLat = lat;
  gpsLon = lon;
  if (first) {
    Serial.printf("[wx] position from %s: %.4f, %.4f\n", topic, lat, lon);
    wakeUp = true;
  }
  return true;
}

const char* icon(int c, bool day) {
  if (c == 0) return day ? "\xEF\x86\x85" : "\xEF\x86\x86";                 // sun / moon
  if (c == 1 || c == 2) return day ? "\xEF\x9B\x84" : "\xEF\x9B\x83";       // cloud-sun / cloud-moon
  if (c == 3) return "\xEF\x83\x82";                                          // cloud
  if (c == 45 || c == 48) return "\xEF\x9D\x9F";                              // smog
  if (c >= 51 && c <= 63) return "\xEF\x9C\xBD";                              // cloud-rain
  if (c == 65 || c == 66 || c == 67 || c == 82) return "\xEF\x9D\x80";        // heavy showers
  if (c >= 71 && c <= 77) return "\xEF\x8B\x9C";                              // snowflake
  if (c == 80 || c == 81) return day ? "\xEF\x9D\x83" : "\xEF\x9C\xBD";       // sun-rain
  if (c == 85 || c == 86) return "\xEF\x8B\x9C";
  if (c >= 95) return "\xEF\x83\xA7";                                         // bolt
  return "\xEF\x83\x82";
}

const char* text(int c) {
  switch (c) {
    case 0: return "Klar";
    case 1: return "Überwiegend klar";
    case 2: return "Teils bewölkt";
    case 3: return "Bewölkt";
    case 45: case 48: return "Nebel";
    case 51: case 53: case 55: return "Nieselregen";
    case 56: case 57: return "Gefrierender Niesel";
    case 61: return "Leichter Regen";
    case 63: return "Regen";
    case 65: return "Starker Regen";
    case 66: case 67: return "Gefrierender Regen";
    case 71: return "Leichter Schnee";
    case 73: return "Schnee";
    case 75: return "Starker Schnee";
    case 77: return "Schneegriesel";
    case 80: return "Regenschauer";
    case 81: return "Kräftige Schauer";
    case 82: return "Heftige Schauer";
    case 85: case 86: return "Schneeschauer";
    case 95: return "Gewitter";
    case 96: case 99: return "Gewitter mit Hagel";
    default: return "--";
  }
}

const char* dirText(int deg) {
  static const char* const d[] = {"N", "NO", "O", "SO", "S", "SW", "W", "NW"};
  if (deg < 0) return "";
  return d[((deg + 22) % 360) / 45];
}

String warning() {
  if (!settings.wxOn) return "";
  Data d = get();
  if (!d.valid || time(nullptr) - d.at > 3 * 3600) return "";   // old data: no warnings
  String w;
  // ends only when the gusts drop wxGustHyst below the limit (no on/off at every update)
  float lim = settings.wxGust;
  if (settings.wxGust > 0 && alerts::latch("gust", !isnan(d.gust) && d.gust >= lim,
                                           isnan(d.gust) || d.gust < lim - settings.wxGustHyst))
    w = "Wind: B\xC3\xB6" "en bis " + String((int)lroundf(d.gust)) + " km/h";
  else if (settings.wxGust == 0) alerts::latch("gust", false, true);
  if (d.code >= 95) {
    if (w.length()) w += "\n";
    w += text(d.code);   // "Gewitter" / "Gewitter mit Hagel"
  }
  return w;
}

bool isDark() {
  time_t now = time(nullptr);
  Data d = get();
  // sun times of today; tomorrow's sunrise is about the same, which is close enough
  if (d.valid && d.sunrise > 0 && d.sunset > 0 && now > 1700000000) {
    struct tm t, r, s;
    localtime_r(&now, &t);
    localtime_r(&d.sunrise, &r);
    localtime_r(&d.sunset, &s);
    int m = t.tm_hour * 60 + t.tm_min, mr = r.tm_hour * 60 + r.tm_min, ms = s.tm_hour * 60 + s.tm_min;
    return m >= ms || m < mr;
  }
  if (now < 1700000000) return true;   // no clock yet: rather light than dark
  struct tm t;
  localtime_r(&now, &t);
  return t.tm_hour >= 18 || t.tm_hour < 7;
}

String json() {
  Data d = get();
  JsonDocument doc;
  doc["on"] = settings.wxOn;
  doc["status"] = status();
  doc["name"] = settings.wxName;
  doc["warn"] = warning();
  if (d.valid) {
    doc["lat"] = d.lat;
    doc["lon"] = d.lon;
    doc["gps"] = d.gps;
    doc["place"] = d.gps ? place() : String("");
  }
  if (d.valid) {
    doc["t"] = d.temp; doc["f"] = d.feels; doc["h"] = d.hum; doc["w"] = d.wind; doc["g"] = d.gust;
    doc["dir"] = dirText(d.dir); doc["c"] = d.code; doc["day"] = d.day; doc["txt"] = text(d.code);
    doc["rn"] = d.rainNext; doc["pn"] = d.popNext; doc["at"] = (long)d.at;
    doc["sr"] = (long)d.sunrise; doc["ss"] = (long)d.sunset;
    JsonArray a = doc["d"].to<JsonArray>();
    for (int i = 0; i < DAYS; i++) {
      JsonObject o = a.add<JsonObject>();
      o["c"] = d.dCode[i]; o["hi"] = d.tMax[i]; o["lo"] = d.tMin[i]; o["r"] = d.rainSum[i]; o["p"] = d.popMax[i];
      o["g"] = d.gustMax[i];
    }
  }
  String out;
  serializeJson(doc, out);
  return out;
}

}  // namespace wx
