hflocki/camper-mqtt/firmware/tanklevel/camper_tanklevel/webserver.cpp

#include "webserver.h"
#include "wifi_manager.h"
#include "gas_sensor.h"
#include "mqtt_ha.h"
#include "safeguard.h"
#include "fwcheck.h"
#include "evlog.h"

#include <WiFi.h>
#include <ESPAsyncWebServer.h>
#include <LittleFS.h>
#include <ArduinoJson.h>
#include <Update.h>

static AsyncWebServer server(80);
static AsyncWebSocket ws("/ws");
static unsigned long lastWsUpdate = 0;

static bool fsReady = false;
static bool restartPending = false;
static unsigned long restartAt = 0;

// ---- Upload (web UI): firmware .bin or the web page index.html.gz --------------
// A complete LittleFS image is NOT accepted here: it would also replace /config.json.
static bool upAuthorized = false;
static bool upWebPage = false;
static bool upFailed = false;
static File upFile;
static const char* WEB_FILE = "/index.html.gz";
static const char* WEB_TMP = "/index.html.gz.tmp";
static volatile bool gasSensorChanged = false;  // MAC changed (set by the async web task, handled in loop())
static volatile bool gasTankChanged = false;    // Bottle size / fill stop changed
static volatile bool configDirty = false;       // Save request from the async web task, handled in loop()

static const size_t MAX_BODY_SIZE = 4096;

static void onWsEvent(AsyncWebSocket* server, AsyncWebSocketClient* client,
                      AwsEventType type, void* arg, uint8_t* data, size_t len);
static void handleApiGetConfig(AsyncWebServerRequest* request);
static void handleApiSaveConfig(AsyncWebServerRequest* request, uint8_t* data, size_t len, size_t index, size_t total);
static void handleApiRestart(AsyncWebServerRequest* request);


// Web UI login (HTTP basic auth). Empty user = no login.
static bool authOk(AsyncWebServerRequest* request) {
    if (config.web_user[0] == '\0') return true;
    return request->authenticate(config.web_user, config.web_pass);
}

static bool auth(AsyncWebServerRequest* request) {
    if (authOk(request)) return true;
    request->requestAuthentication();
    return false;
}

// ============================================================
// Helpers
// ============================================================

// Default table of a Votronic tank electrode (fill level in % per voltage)
static void setElectrodeCalib(TankConfig& t) {
    static const CalibPoint VOTRONIC[] = {
        {0.130f, 0.0f}, {0.137f, 10.0f}, {0.973f, 20.0f}, {1.040f, 30.0f}, {1.350f, 40.0f},
        {1.515f, 50.0f}, {1.770f, 60.0f}, {2.178f, 80.0f}, {2.386f, 100.0f}
    };
    t.calibCount = 0;
    for (uint8_t i = 0; i < sizeof(VOTRONIC) / sizeof(VOTRONIC[0]); i++) t.calibTable[i] = VOTRONIC[i];
    t.calibCount = sizeof(VOTRONIC) / sizeof(VOTRONIC[0]);
}

// Linear two-point table of a Votronic Tank-Sensor FL (placeholder until empty/full are taught)
static void setFlCalib(TankConfig& t) {
    t.calibCount = 0;
    t.calibTable[0] = {FL_DEFAULT_EMPTY_V, 0.0f};
    t.calibTable[1] = {FL_DEFAULT_FULL_V, 100.0f};
    t.calibCount = 2;
}

static void setTypeCalib(TankConfig& t, uint8_t type) {
    if (type == GREY_TYPE_FL) setFlCalib(t);
    else setElectrodeCalib(t);
}

static void setDefaultTank(TankConfig& t, float size) {
    t.tank_size = size;
    t.filter_active = true;
    setElectrodeCalib(t);
}

static void setDefaults() {
    strlcpy(config.ap_ssid, defaultApSsid(), sizeof(config.ap_ssid));
    strlcpy(config.ap_pass, DEFAULT_AP_PASSWORD, sizeof(config.ap_pass));
    config.wifi_tx_power = DEFAULT_TX_POWER;
    config.ap_always = DEFAULT_AP_ALWAYS;
    strlcpy(config.wifi_ssid, DEFAULT_WIFI_SSID, sizeof(config.wifi_ssid));
    strlcpy(config.wifi_pass, DEFAULT_WIFI_PASSWORD, sizeof(config.wifi_pass));
    strlcpy(config.mqtt_server, DEFAULT_MQTT_SERVER, sizeof(config.mqtt_server));
    config.mqtt_port = DEFAULT_MQTT_PORT;
    strlcpy(config.mqtt_user, DEFAULT_MQTT_USER, sizeof(config.mqtt_user));
    strlcpy(config.mqtt_pass, DEFAULT_MQTT_PASSWORD, sizeof(config.mqtt_pass));
    strlcpy(config.mqtt_prefix, DEFAULT_MQTT_PREFIX, sizeof(config.mqtt_prefix));
    strlcpy(config.web_user, DEFAULT_WEB_USER, sizeof(config.web_user));
    strlcpy(config.web_pass, DEFAULT_WEB_PASSWORD, sizeof(config.web_pass));

    config.water_enabled = (WATER_ENABLED != 0);
    config.grey_enabled = (GREY_ENABLED != 0);
    config.gas_enabled = (GAS_ENABLED != 0);

    // Water tanks
    setDefaultTank(config.fresh, DEFAULT_TANK_SIZE);
    setDefaultTank(config.grey, DEFAULT_GREY_SIZE);
    config.grey_type = GREY_SENSOR_TYPE;
    setTypeCalib(config.grey, config.grey_type);

    // Gas
    memset(config.sensor_mac, 0, sizeof(config.sensor_mac));
    config.gas_type = DEFAULT_GAS_TYPE;
    config.mopeka_empty_mm = DEFAULT_MOPEKA_EMPTY_MM;
    config.mopeka_full_mm = DEFAULT_MOPEKA_FULL_MM;
    config.lpg_propane = DEFAULT_LPG_PROPANE;
    config.capacity = DEFAULT_CAPACITY;
    config.fill_stop_on = DEFAULT_FILL_STOP_ON;
    config.fill_stop = DEFAULT_FILL_STOP;
}

static bool isNumber(JsonVariantConst v) {
    return v.is<float>() || v.is<int>();
}

// Parses a JSON calibration array into a local table, sorted by voltage.
// Returns true only if at least 2 valid points were found.
static bool parseCalib(JsonArrayConst arr, CalibPoint* out, uint8_t& count) {
    count = 0;
    for (JsonObjectConst item : arr) {
        if (count >= MAX_CALIB_POINTS) break;
        if (!item["v"].is<float>() || !item["l"].is<float>()) continue;

        CalibPoint p;
        p.volt = item["v"].as<float>();
        p.percent = item["l"].as<float>();

        // Insertion sort by voltage
        int pos = count;
        while (pos > 0 && out[pos - 1].volt > p.volt) {
            out[pos] = out[pos - 1];
            pos--;
        }
        out[pos] = p;
        count++;
    }
    return count >= 2;
}

// Copies the table first and sets the count last, so the sensor loop never sees a half-written table
static void applyCalib(TankConfig& t, const CalibPoint* tbl, uint8_t count) {
    t.calibCount = 0;
    for (uint8_t i = 0; i < count; i++) t.calibTable[i] = tbl[i];
    t.calibCount = count;
}

// JSON keys of a tank: fresh water uses "tank_size", "filter_active", "calib" (compatible with
// older configs), grey water the same keys with the prefix "grey_".
static String tankKey(const char* prefix, const char* key) {
    return String(prefix) + key;
}

// Writes tank size, filter and table. "l" holds the fill level in % (key kept for compatibility)
static void tankToJson(JsonDocument& doc, const char* prefix, const TankConfig& t) {
    doc[tankKey(prefix, "tank_size")] = t.tank_size;
    doc[tankKey(prefix, "filter_active")] = t.filter_active;
    JsonArray arr = doc[tankKey(prefix, "calib")].to<JsonArray>();
    for (int i = 0; i < t.calibCount; i++) {
        JsonObject item = arr.add<JsonObject>();
        item["v"] = t.calibTable[i].volt;
        item["l"] = t.calibTable[i].percent;
    }
}

// Reads a stored tank; invalid or missing values keep the defaults
static void tankFromJson(JsonDocument& doc, const char* prefix, TankConfig& t) {
    JsonVariant f = doc[tankKey(prefix, "filter_active")];
    if (f.is<bool>()) t.filter_active = f.as<bool>();
    JsonVariant s = doc[tankKey(prefix, "tank_size")];
    if (s.is<float>() || s.is<int>()) {
        float size = s.as<float>();
        if (size >= 1.0f && size <= 5000.0f) t.tank_size = size;
    }
    CalibPoint tmp[MAX_CALIB_POINTS];
    uint8_t tmpCount = 0;
    if (parseCalib(doc[tankKey(prefix, "calib")].as<JsonArrayConst>(), tmp, tmpCount)) {
        applyCalib(t, tmp, tmpCount);
    }
}

// Validated tank update from the web UI
struct TankUpdate {
    bool hasCalib = false;
    CalibPoint calib[MAX_CALIB_POINTS];
    uint8_t calibCount = 0;
    bool hasSize = false;
    float size = 0.0f;
    bool hasFilter = false;
    bool filter = false;
};

// Returns an error message or nullptr if the values are valid
static const char* validateTank(JsonDocument& doc, const char* prefix, TankUpdate& u) {
    JsonVariant c = doc[tankKey(prefix, "calib")];
    u.hasCalib = !c.isNull();
    if (u.hasCalib && !parseCalib(c.as<JsonArrayConst>(), u.calib, u.calibCount)) {
        return "At least 2 valid calibration points required";
    }
    JsonVariant s = doc[tankKey(prefix, "tank_size")];
    u.hasSize = isNumber(s);
    u.size = u.hasSize ? s.as<float>() : 0.0f;
    if (u.hasSize && (u.size < 1.0f || u.size > 5000.0f)) return "Tank size must be 1-5000 L";
    JsonVariant f = doc[tankKey(prefix, "filter_active")];
    u.hasFilter = f.is<bool>();
    u.filter = u.hasFilter ? f.as<bool>() : false;
    return nullptr;
}

static void applyTank(TankConfig& t, const TankUpdate& u) {
    if (u.hasSize) t.tank_size = u.size;
    if (u.hasFilter) t.filter_active = u.filter;
    if (u.hasCalib) applyCalib(t, u.calib, u.calibCount);
}

// Normalizes "aa-bb-cc-dd-ee-ff" / "aabbccddeeff" / "AA:BB:..." to "AA:BB:CC:DD:EE:FF".
// Empty input is valid (= no sensor). Returns false on invalid input.
static bool normalizeMac(const char* in, char* out, size_t size) {
    char hex[13];
    int n = 0;
    for (const char* p = in; *p; p++) {
        if (*p == ':' || *p == '-' || *p == ' ') continue;
        if (!isxdigit((unsigned char)*p) || n >= 12) return false;
        hex[n++] = toupper((unsigned char)*p);
    }
    if (n == 0) { out[0] = '\0'; return true; }
    if (n != 12 || size < 18) return false;
    for (int i = 0; i < 6; i++) {
        out[i * 3] = hex[i * 2];
        out[i * 3 + 1] = hex[i * 2 + 1];
        out[i * 3 + 2] = (i < 5) ? ':' : '\0';
    }
    return true;
}

static void copyIfPresent(JsonDocument& doc, const char* key, char* dest, size_t size, bool skipEmpty) {
    if (doc[key].isNull()) return;
    const char* v = doc[key].as<const char*>();
    if (!v) return;
    if (skipEmpty && v[0] == '\0') return;
    strlcpy(dest, v, size);
}

static void sendError(AsyncWebServerRequest* request, const char* msg) {
    request->send(400, "application/json", String("{\"error\":\"") + msg + "\"}");
}

// ============================================================
// Setup / loop
// ============================================================

void webserverInit() {
    fsReady = LittleFS.begin(true);
    if (!fsReady) {
        Serial.println("[Web] LittleFS mount failed - running with defaults");
    }

    // Always load the config (falls back to defaults if the filesystem is unavailable)
    loadConfig();

    ws.onEvent(onWsEvent);
    // Browsers send the basic auth credentials of the page along with the WebSocket upgrade
    ws.handleHandshake([](AsyncWebServerRequest* request) { return authOk(request); });
    server.addHandler(&ws);

    // Serve ONLY index.html. Serving the whole filesystem would expose /config.json
    // (WiFi and MQTT credentials) to everybody in the network.
    // The web UI is stored gzip compressed (about 1/4 of the size): loads much faster,
    // because WiFi runs in modem sleep for the Bluetooth coexistence.
    server.on("/", HTTP_GET, [](AsyncWebServerRequest* request) {
        if (!auth(request)) return;
        if (fsReady && LittleFS.exists("/index.html.gz")) {
            AsyncWebServerResponse* response = request->beginResponse(LittleFS, "/index.html.gz", "text/html");
            response->addHeader("Content-Encoding", "gzip");
            response->addHeader("Cache-Control", "no-cache");
            request->send(response);
        } else if (fsReady && LittleFS.exists("/index.html")) {
            request->send(LittleFS, "/index.html", "text/html");   // Uncompressed (older filesystem image)
        } else {
            request->send(200, "text/html",
                "<h1>Tanklevel Node</h1><p>Web page missing. Upload <code>data/index.html.gz</code> "
                "or a firmware (.bin):</p><form method=POST action=/api/update enctype=multipart/form-data>"
                "<input type=file name=f accept='.bin,.gz'> <button>Upload</button></form>");
        }
    });

    server.on("/api/config", HTTP_GET, handleApiGetConfig);
    server.on("/api/config", HTTP_POST, [](AsyncWebServerRequest* request) {}, NULL,
              [](AsyncWebServerRequest* request, uint8_t* data, size_t len, size_t index, size_t total) {
                  // Checked per chunk: the body handler runs before the request handler
                  if (!authOk(request)) {
                      if (index + len == total) request->requestAuthentication();
                      return;
                  }
                  handleApiSaveConfig(request, data, len, index, total);
              });
    // Firmware (.bin) or web page (.gz) upload; the file name decides
    server.on("/api/update", HTTP_POST,
        [](AsyncWebServerRequest* request) {
            if (!auth(request)) return;
            if (!upAuthorized) { request->send(401, "text/plain", "Login fehlt"); return; }
            if (upWebPage) {
                if (upFailed) request->send(500, "text/plain", "Web-Oberfläche nicht gespeichert (LittleFS voll oder nicht bereit)");
                else request->send(200, "text/plain", "OK web");
                return;
            }
            // firmware: checked and written by fwcheck
            if (!fwcheck::ok()) { request->send(400, "text/plain", "Update abgelehnt: " + fwcheck::error()); return; }
            guard::otaDone();
            request->send(200, "text/plain", "OK");
            restartPending = true;
            restartAt = millis() + 1000;
        },
        [](AsyncWebServerRequest* request, const String& filename, size_t index, uint8_t* data, size_t len, bool final) {
            if (index == 0) {
                upAuthorized = authOk(request);
                if (!upAuthorized) return;
                String n = filename;
                n.toLowerCase();
                upWebPage = n.endsWith(".gz");
                upFailed = false;
                Serial.printf("[OTA] Web upload (%s): %s\n", upWebPage ? "web page" : "firmware", filename.c_str());
                if (upWebPage) {
                    upFile = fsReady ? LittleFS.open(WEB_TMP, "w") : File();
                    if (!upFile) upFailed = true;
                } else {
                    fwcheck::begin(request->contentLength(), request->hasParam("force"));
                }
            }
            if (!upAuthorized) return;
            if (upWebPage) {
                if (upFailed) return;
                if (len && upFile.write(data, len) != len) upFailed = true;
                if (final) {
                    upFile.close();
                    if (!upFailed) { LittleFS.remove(WEB_FILE); upFailed = !LittleFS.rename(WEB_TMP, WEB_FILE); }
                    else LittleFS.remove(WEB_TMP);
                    if (upFailed) evlog::add("Web-Oberfläche nicht gespeichert");
                    else evlog::add("Web-Oberfläche ersetzt (%u kB)", (unsigned)((index + len) / 1024));
                }
                return;
            }
            fwcheck::chunk(data, len, final);
        });

    server.on("/api/restart", HTTP_POST, handleApiRestart);

    // Firmware info for the update check in the browser, and the event log
    server.on("/api/system", HTTP_GET, [](AsyncWebServerRequest* request) {
        if (!auth(request)) return;
        JsonDocument d;
        fwcheck::info(d["fw"].to<JsonObject>());
        evlog::json(d["log"].to<JsonArray>());
        d["up"] = millis() / 1000;
        String out;
        serializeJson(d, out);
        request->send(200, "application/json", out);
    });

    // Toggle the smoothing filter (state-changing endpoint, so POST instead of GET).
    // /api/filter = fresh water, /api/filter?tank=grey = grey water
    server.on("/api/filter", HTTP_POST, [](AsyncWebServerRequest* request) {
        if (!auth(request)) return;
        bool isGrey = request->hasParam("tank") && request->getParam("tank")->value() == "grey";
        TankConfig& t = isGrey ? config.grey : config.fresh;
        t.filter_active = !t.filter_active;
        configDirty = true;
        request->send(200, "application/json",
            String("{\"filter\":\"") + (t.filter_active ? "ON" : "OFF") + "\"}");
    });

    // Nearby BLE devices (for picking the gas sensor MAC in the web UI)
    server.on("/api/scan", HTTP_GET, [](AsyncWebServerRequest* request) {
        if (!auth(request)) return;
        JsonDocument doc;
        JsonArray arr = doc["devices"].to<JsonArray>();
        if (config.gas_enabled) gasFillSeenList(arr);
        String response;
        serializeJson(doc, response);
        request->send(200, "application/json", response);
    });
}

void webserverStart() {
    server.begin();
    Serial.println("[Web] Server started on port 80");
}

void webserverLoop() {
    ws.cleanupClients(2);

    if (configDirty) {
        configDirty = false;
        saveConfig();
    }

    // Gas settings changed in the web UI
    if (gasSensorChanged) {
        gasSensorChanged = false;
        gasTankChanged = false;
        gasReset();             // Other sensor: forget the old readings
        mqttRequestDiscovery(); // Mopeka has additional entities
    } else if (gasTankChanged) {
        gasTankChanged = false;
        gasRecalculate();       // Same sensor: recalculate level/content from the last raw value
    }

    // Deferred restart: the HTTP response can be sent before the chip resets
    if (restartPending && millis() >= restartAt) {
        ESP.restart();
    }

    if (millis() - lastWsUpdate > WS_UPDATE_MS) {
        lastWsUpdate = millis();
        if (ws.count() > 0) {
            wsSendSensorData();
        }
    }
}

void wsSendSensorData() {
    JsonDocument doc;
    const WaterData& w = sensorData.water;
    const GasData& g = sensorData.gas;

    JsonObject wo = doc["water"].to<JsonObject>();
    wo["voltage"] = round(w.avg_voltage * 1000.0f) / 1000.0f;
    wo["liters"] = round(w.liters * 10.0f) / 10.0f;
    wo["percent"] = round(w.percent);
    wo["filter"] = config.fresh.filter_active;

    const WaterData& gr = sensorData.grey;
    JsonObject gro = doc["grey"].to<JsonObject>();
    gro["voltage"] = round(gr.avg_voltage * 1000.0f) / 1000.0f;
    gro["liters"] = round(gr.liters * 10.0f) / 10.0f;
    gro["percent"] = round(gr.percent);
    gro["filter"] = config.grey.filter_active;

    JsonObject go = doc["gas"].to<JsonObject>();
    go["has_data"] = g.has_data;
    go["level"] = round(g.level * 10.0f) / 10.0f;
    go["raw"] = round(g.raw_level * 10.0f) / 10.0f;
    go["content"] = round(g.content * 10.0f) / 10.0f;
    if (isnan(g.battery)) go["battery"] = nullptr;
    else go["battery"] = round(g.battery);
    go["ble_rssi"] = g.ble_rssi;
    go["ble_state"] = (const char*)g.ble_state;
    go["age"] = g.has_data ? (long)((millis() - g.last_update) / 1000) : -1;
    go["type"] = config.gas_type;
    if (isnan(g.distance_mm)) go["mm"] = nullptr; else go["mm"] = (int)roundf(g.distance_mm);
    if (isnan(g.temperature)) go["temp"] = nullptr; else go["temp"] = (int)roundf(g.temperature);
    if (g.quality < 0) go["quality"] = nullptr; else go["quality"] = g.quality;
    go["raw_hex"] = (const char*)g.raw_hex;
    go["adv_count"] = g.adv_count;
    go["scanning"] = g.scanning;

    doc["rssi"] = sensorData.rssi;
    doc["uptime"] = millis() / 1000;
    doc["wifi_drops"] = sensorData.wifi_drops;
    doc["wifi_reason"] = (const char*)sensorData.wifi_reason;
    doc["wifi"] = getWiFiStateString();
    doc["mqtt"] = mqttIsConnected();

    static char buffer[1280];   // static: keeps it off the stack
    size_t len = serializeJson(doc, buffer, sizeof(buffer));
    if (len == 0 || len >= sizeof(buffer)) return;
    ws.textAll(buffer, len);
}

static void onWsEvent(AsyncWebSocket* server, AsyncWebSocketClient* client,
                      AwsEventType type, void* arg, uint8_t* data, size_t len) {
    if (type == WS_EVT_CONNECT) {
        wsSendSensorData();
    }
}

// ============================================================
// REST API
// ============================================================

static void handleApiGetConfig(AsyncWebServerRequest* request) {
    if (!auth(request)) return;
    JsonDocument doc;

    // Passwords are never sent back to the browser
    doc["wifi_ssid"] = (const char*)config.wifi_ssid;
    doc["ap_ssid"] = (const char*)config.ap_ssid;
    doc["wifi_pass_set"] = strlen(config.wifi_pass) > 0;
    doc["wifi_tx_power"] = config.wifi_tx_power;
    doc["ap_always"] = config.ap_always;
    doc["reset_reason"] = resetReasonString();
    doc["guard"] = guard::status();
    doc["mqtt_server"] = (const char*)config.mqtt_server;
    doc["mqtt_port"] = config.mqtt_port;
    doc["mqtt_user"] = (const char*)config.mqtt_user;
    doc["mqtt_pass_set"] = strlen(config.mqtt_pass) > 0;
    doc["mqtt_prefix"] = (const char*)config.mqtt_prefix;
    doc["web_user"] = (const char*)config.web_user;
    doc["web_pass_set"] = strlen(config.web_pass) > 0;
    doc["version"] = FW_VERSION;
    doc["water_enabled"] = config.water_enabled;
    doc["grey_enabled"] = config.grey_enabled;
    doc["gas_enabled"] = config.gas_enabled;

    // Water tanks
    tankToJson(doc, "", config.fresh);
    tankToJson(doc, "grey_", config.grey);
    doc["grey_type"] = config.grey_type;

    // Gas
    doc["sensor_mac"] = (const char*)config.sensor_mac;
    doc["capacity"] = config.capacity;
    doc["fill_stop_on"] = config.fill_stop_on;
    doc["fill_stop"] = config.fill_stop;
    doc["gas_type"] = config.gas_type;
    doc["mopeka_empty_mm"] = config.mopeka_empty_mm;
    doc["mopeka_full_mm"] = config.mopeka_full_mm;
    doc["lpg_propane"] = config.lpg_propane;

    // Compile-time gas sensor definition (read-only in the web UI)
    JsonObject def = doc["sensor_def"].to<JsonObject>();
    def["model"] = SENSOR_MODEL;
    def["source"] = SENSOR_SOURCE;
    if (SENSOR_COMPANY_ID >= 0) {
        char buf[7];
        snprintf(buf, sizeof(buf), "%04X", (unsigned)SENSOR_COMPANY_ID);
        def["company"] = (const char*)buf;
    }
    def["uuid"] = SENSOR_UUID;
    def["level_offset"] = LEVEL_OFFSET;
    def["level_len"] = LEVEL_LEN;
    def["battery"] = BATTERY_ENABLED;
    def["battery_offset"] = BATTERY_OFFSET;
    def["battery_len"] = BATTERY_LEN;

    String response;
    serializeJson(doc, response);
    request->send(200, "application/json", response);
}

static void handleApiSaveConfig(AsyncWebServerRequest* request, uint8_t* data, size_t len, size_t index, size_t total) {
    static String body;
    static bool rejected = false;

    if (index == 0) {
        body = "";
        rejected = (total > MAX_BODY_SIZE);
    }
    if (rejected) {
        if (index + len == total) {
            request->send(413, "application/json", "{\"error\":\"Body too large\"}");
        }
        return;
    }

    body += String((char*)data, len);

    if (index + len != total) return;

    JsonDocument doc;
    DeserializationError err = deserializeJson(doc, body);
    body = "";

    if (err) {
        sendError(request, "Invalid JSON");
        return;
    }

    // ---- Validate everything first, before anything is changed ----

    // The access point password needs at least 8 characters (WPA2)
    if (doc["ap_pass"].is<const char*>()) {
        size_t apLen = strlen(doc["ap_pass"].as<const char*>());
        if (apLen > 0 && apLen < 8) { sendError(request, "AP password needs at least 8 characters"); return; }
    }
    bool hasTx = doc["wifi_tx_power"].is<int>();
    if (hasTx && !isValidTxPower(doc["wifi_tx_power"].as<int>())) { sendError(request, "Invalid TX power"); return; }

    // A login needs a password: either sent now or already stored
    if (doc["web_user"].is<const char*>() && doc["web_user"].as<const char*>()[0]) {
        const char* wp = doc["web_pass"] | "";
        if (wp[0] == '\0' && config.web_pass[0] == '\0') { sendError(request, "Login needs a password"); return; }
    }

    // Water tanks (static: two tables are too big for the async web task stack)
    static TankUpdate freshUpd, greyUpd;
    freshUpd = TankUpdate();
    greyUpd = TankUpdate();
    const char* tankErr = validateTank(doc, "", freshUpd);
    if (!tankErr) tankErr = validateTank(doc, "grey_", greyUpd);
    if (tankErr) { sendError(request, tankErr); return; }

    bool hasGreyType = doc["grey_type"].is<int>();
    int newGreyType = hasGreyType ? doc["grey_type"].as<int>() : 0;
    if (hasGreyType && newGreyType != GREY_TYPE_ELECTRODE && newGreyType != GREY_TYPE_FL) {
        sendError(request, "Unknown grey water sender type"); return;
    }

    // Gas
    bool hasMac = doc["sensor_mac"].is<const char*>();
    char newMac[18] = "";
    if (hasMac && !normalizeMac(doc["sensor_mac"].as<const char*>(), newMac, sizeof(newMac))) {
        sendError(request, "Invalid MAC address"); return;
    }

    bool hasCap = isNumber(doc["capacity"]);
    float newCap = hasCap ? doc["capacity"].as<float>() : 0.0f;
    if (hasCap && (newCap < 0.5f || newCap > 1000.0f)) { sendError(request, "Capacity must be 0.5-1000"); return; }

    bool hasStop = isNumber(doc["fill_stop"]);
    float newStop = hasStop ? doc["fill_stop"].as<float>() : 0.0f;
    if (hasStop && (newStop < 1.0f || newStop > 100.0f)) { sendError(request, "Fill stop must be 1-100 %"); return; }

    bool hasStopOn = doc["fill_stop_on"].is<bool>();
    bool newStopOn = hasStopOn ? doc["fill_stop_on"].as<bool>() : false;

    bool hasGasType = doc["gas_type"].is<int>();
    int newGasType = hasGasType ? doc["gas_type"].as<int>() : 0;
    if (hasGasType && newGasType != GAS_TYPE_DEFINITION && newGasType != GAS_TYPE_MOPEKA &&
        newGasType != GAS_TYPE_MOPEKA_STD) {
        sendError(request, "Unknown gas sensor type"); return;
    }
    bool hasProp = doc["lpg_propane"].is<int>();
    int newProp = hasProp ? doc["lpg_propane"].as<int>() : 0;
    if (hasProp && (newProp < 0 || newProp > 100)) { sendError(request, "Propane share must be 0-100 %"); return; }
    bool hasMm = isNumber(doc["mopeka_empty_mm"]) || isNumber(doc["mopeka_full_mm"]);
    int newEmpty = doc["mopeka_empty_mm"] | (int)config.mopeka_empty_mm;
    int newFull = doc["mopeka_full_mm"] | (int)config.mopeka_full_mm;
    if (hasMm && (newEmpty < 0 || newFull > 2000 || newFull <= newEmpty + 10)) {
        sendError(request, "Mopeka: full height must be above empty height (0-2000 mm)"); return;
    }

    // ---- Apply ----

    // Empty values clear SSID/server/user; empty passwords are ignored (= keep the stored one)
    // WiFi change while connected: keep the working values as fallback (safeguard.h)
    if (isConnected()) {
        const char* newSsid = doc["wifi_ssid"].is<const char*>() ? doc["wifi_ssid"].as<const char*>() : config.wifi_ssid;
        const char* newPass = config.wifi_pass;
        if (doc["wifi_pass"].is<const char*>() && doc["wifi_pass"].as<const char*>()[0]) newPass = doc["wifi_pass"].as<const char*>();
        if (strcmp(newSsid, config.wifi_ssid) != 0 || strcmp(newPass, config.wifi_pass) != 0) {
            guard::wifiTrialStart(config.wifi_ssid, config.wifi_pass);
        }
    }
    copyIfPresent(doc, "wifi_ssid",   config.wifi_ssid,   sizeof(config.wifi_ssid),   false);
    copyIfPresent(doc, "wifi_pass",   config.wifi_pass,   sizeof(config.wifi_pass),   true);
    copyIfPresent(doc, "ap_ssid",     config.ap_ssid,     sizeof(config.ap_ssid),     true);
    copyIfPresent(doc, "ap_pass",     config.ap_pass,     sizeof(config.ap_pass),     true);
    copyIfPresent(doc, "mqtt_server", config.mqtt_server, sizeof(config.mqtt_server), false);
    copyIfPresent(doc, "mqtt_user",   config.mqtt_user,   sizeof(config.mqtt_user),   false);
    copyIfPresent(doc, "mqtt_pass",   config.mqtt_pass,   sizeof(config.mqtt_pass),   true);
    copyIfPresent(doc, "mqtt_prefix", config.mqtt_prefix, sizeof(config.mqtt_prefix), true);
    copyIfPresent(doc, "web_user",    config.web_user,    sizeof(config.web_user),    false);
    copyIfPresent(doc, "web_pass",    config.web_pass,    sizeof(config.web_pass),    true);
    if (config.web_user[0] == '\0') config.web_pass[0] = '\0';   // No user = login off

    // WiFi TX power and AP mode take effect after the restart triggered by the web UI
    if (hasTx) config.wifi_tx_power = (int8_t)doc["wifi_tx_power"].as<int>();
    if (doc["ap_always"].is<bool>()) config.ap_always = doc["ap_always"].as<bool>();

    if (doc["mqtt_port"].is<int>()) {
        int port = doc["mqtt_port"].as<int>();
        config.mqtt_port = (port > 0 && port <= 65535) ? (uint16_t)port : DEFAULT_MQTT_PORT;
    }

    // Enabling/disabling a sensor takes effect after a restart (the web UI restarts the device)
    if (doc["water_enabled"].is<bool>()) config.water_enabled = doc["water_enabled"].as<bool>();
    if (doc["grey_enabled"].is<bool>())  config.grey_enabled = doc["grey_enabled"].as<bool>();
    if (doc["gas_enabled"].is<bool>())   config.gas_enabled = doc["gas_enabled"].as<bool>();

    applyTank(config.fresh, freshUpd);
    // Another sender type: load its default table (unless a table was sent along)
    if (hasGreyType && newGreyType != config.grey_type) {
        config.grey_type = (uint8_t)newGreyType;
        if (!greyUpd.hasCalib) setTypeCalib(config.grey, config.grey_type);
    }
    applyTank(config.grey, greyUpd);

    if (hasMac && strcmp(newMac, config.sensor_mac) != 0) {
        strlcpy(config.sensor_mac, newMac, sizeof(config.sensor_mac));
        gasSensorChanged = true;
    }
    if (hasGasType && newGasType != config.gas_type) {
        config.gas_type = (uint8_t)newGasType;
        gasSensorChanged = true;
    }
    if (hasProp && newProp != config.lpg_propane) {
        config.lpg_propane = (uint8_t)newProp;
        gasSensorChanged = true;   // heights measured with the old mix are not valid any more
    }
    if (hasMm && (newEmpty != config.mopeka_empty_mm || newFull != config.mopeka_full_mm)) {
        config.mopeka_empty_mm = (uint16_t)newEmpty;
        config.mopeka_full_mm = (uint16_t)newFull;
        gasTankChanged = true;
    }
    if (hasCap && newCap != config.capacity)           { config.capacity = newCap;       gasTankChanged = true; }
    if (hasStopOn && newStopOn != config.fill_stop_on) { config.fill_stop_on = newStopOn; gasTankChanged = true; }
    if (hasStop && newStop != config.fill_stop)        { config.fill_stop = newStop;     gasTankChanged = true; }

    saveConfig();
    evlog::add("Einstellungen gespeichert");
    request->send(200, "application/json", "{\"status\":\"ok\"}");
}

static void handleApiRestart(AsyncWebServerRequest* request) {
    if (!auth(request)) return;
    evlog::add("Neustart über die Web-Oberfläche");
    request->send(200, "application/json", "{\"status\":\"restarting\"}");
    // Do not block the async web task: restart from webserverLoop() instead
    restartPending = true;
    restartAt = millis() + 500;
}

// ============================================================
// Persistence
// ============================================================

void loadConfig() {
    setDefaults();

    if (!fsReady) return;

    if (!LittleFS.exists(CONFIG_FILE)) {
        saveConfig();
        return;
    }

    File file = LittleFS.open(CONFIG_FILE, "r");
    if (!file) return;

    JsonDocument doc;
    DeserializationError err = deserializeJson(doc, file);
    file.close();
    if (err) {
        Serial.printf("[Config] Parse error (%s) - using defaults\n", err.c_str());
        return;
    }

    strlcpy(config.wifi_ssid,   doc["wifi_ssid"]   | DEFAULT_WIFI_SSID,     sizeof(config.wifi_ssid));
    strlcpy(config.wifi_pass,   doc["wifi_pass"]   | DEFAULT_WIFI_PASSWORD, sizeof(config.wifi_pass));
    strlcpy(config.ap_ssid,     doc["ap_ssid"]     | defaultApSsid(),     sizeof(config.ap_ssid));
    strlcpy(config.ap_pass,     doc["ap_pass"]     | DEFAULT_AP_PASSWORD, sizeof(config.ap_pass));
    int tx = doc["wifi_tx_power"] | DEFAULT_TX_POWER;
    config.wifi_tx_power = isValidTxPower(tx) ? (int8_t)tx : DEFAULT_TX_POWER;
    config.ap_always = doc["ap_always"] | DEFAULT_AP_ALWAYS;
    strlcpy(config.mqtt_server, doc["mqtt_server"] | DEFAULT_MQTT_SERVER, sizeof(config.mqtt_server));
    config.mqtt_port = doc["mqtt_port"] | DEFAULT_MQTT_PORT;
    strlcpy(config.mqtt_user,   doc["mqtt_user"]   | DEFAULT_MQTT_USER,     sizeof(config.mqtt_user));
    strlcpy(config.mqtt_pass,   doc["mqtt_pass"]   | DEFAULT_MQTT_PASSWORD, sizeof(config.mqtt_pass));
    strlcpy(config.mqtt_prefix, doc["mqtt_prefix"] | DEFAULT_MQTT_PREFIX, sizeof(config.mqtt_prefix));
    strlcpy(config.web_user,    doc["web_user"]    | DEFAULT_WEB_USER,      sizeof(config.web_user));
    strlcpy(config.web_pass,    doc["web_pass"]    | DEFAULT_WEB_PASSWORD,  sizeof(config.web_pass));
    if (config.web_user[0] == '\0') config.web_pass[0] = '\0';

    config.water_enabled = doc["water_enabled"] | (WATER_ENABLED != 0);
    config.grey_enabled = doc["grey_enabled"] | (GREY_ENABLED != 0);
    config.gas_enabled = doc["gas_enabled"] | (GAS_ENABLED != 0);

    // Water tanks (factory values are kept for anything missing or invalid)
    tankFromJson(doc, "", config.fresh);
    int greyType = doc["grey_type"] | GREY_SENSOR_TYPE;
    config.grey_type = (greyType == GREY_TYPE_FL) ? GREY_TYPE_FL : GREY_TYPE_ELECTRODE;
    setTypeCalib(config.grey, config.grey_type);   // Default table of this type, replaced by a stored one
    tankFromJson(doc, "grey_", config.grey);

    // Gas
    char mac[18];
    if (normalizeMac(doc["sensor_mac"] | "", mac, sizeof(mac))) {
        strlcpy(config.sensor_mac, mac, sizeof(config.sensor_mac));
    }
    float cap = doc["capacity"] | DEFAULT_CAPACITY;
    config.capacity = (cap >= 0.5f && cap <= 1000.0f) ? cap : DEFAULT_CAPACITY;
    config.fill_stop_on = doc["fill_stop_on"] | DEFAULT_FILL_STOP_ON;
    float stop = doc["fill_stop"] | DEFAULT_FILL_STOP;
    config.fill_stop = (stop >= 1.0f && stop <= 100.0f) ? stop : DEFAULT_FILL_STOP;
    int gt = doc["gas_type"] | DEFAULT_GAS_TYPE;
    config.gas_type = (gt == GAS_TYPE_MOPEKA || gt == GAS_TYPE_MOPEKA_STD) ? (uint8_t)gt : GAS_TYPE_DEFINITION;
    int lp = doc["lpg_propane"] | DEFAULT_LPG_PROPANE;
    config.lpg_propane = (lp >= 0 && lp <= 100) ? (uint8_t)lp : DEFAULT_LPG_PROPANE;
    int me = doc["mopeka_empty_mm"] | DEFAULT_MOPEKA_EMPTY_MM;
    int mf = doc["mopeka_full_mm"] | DEFAULT_MOPEKA_FULL_MM;
    if (me >= 0 && mf <= 2000 && mf > me + 10) {
        config.mopeka_empty_mm = (uint16_t)me;
        config.mopeka_full_mm = (uint16_t)mf;
    }
}

void saveConfig() {
    if (!fsReady) return;

    JsonDocument doc;
    doc["wifi_ssid"] = (const char*)config.wifi_ssid;
    doc["wifi_pass"] = (const char*)config.wifi_pass;
    doc["ap_ssid"] = (const char*)config.ap_ssid;
    doc["ap_pass"] = (const char*)config.ap_pass;
    doc["wifi_tx_power"] = config.wifi_tx_power;
    doc["ap_always"] = config.ap_always;
    doc["mqtt_server"] = (const char*)config.mqtt_server;
    doc["mqtt_port"] = config.mqtt_port;
    doc["mqtt_user"] = (const char*)config.mqtt_user;
    doc["mqtt_pass"] = (const char*)config.mqtt_pass;
    doc["mqtt_prefix"] = (const char*)config.mqtt_prefix;
    doc["web_user"] = (const char*)config.web_user;
    doc["web_pass"] = (const char*)config.web_pass;

    doc["water_enabled"] = config.water_enabled;
    doc["grey_enabled"] = config.grey_enabled;
    doc["gas_enabled"] = config.gas_enabled;

    // Water tanks
    tankToJson(doc, "", config.fresh);
    tankToJson(doc, "grey_", config.grey);
    doc["grey_type"] = config.grey_type;

    // Gas
    doc["sensor_mac"] = (const char*)config.sensor_mac;
    doc["capacity"] = config.capacity;
    doc["fill_stop_on"] = config.fill_stop_on;
    doc["fill_stop"] = config.fill_stop;
    doc["gas_type"] = config.gas_type;
    doc["mopeka_empty_mm"] = config.mopeka_empty_mm;
    doc["mopeka_full_mm"] = config.mopeka_full_mm;
    doc["lpg_propane"] = config.lpg_propane;

    // Write to a temp file first so a power loss cannot leave a half-written config
    const char* tmpPath = "/config.tmp";
    File file = LittleFS.open(tmpPath, "w");
    if (!file) {
        Serial.println("[Config] Cannot open temp file for writing");
        return;
    }
    size_t written = serializeJsonPretty(doc, file);
    file.close();

    if (written == 0) {
        LittleFS.remove(tmpPath);
        Serial.println("[Config] Write failed");
        return;
    }

    LittleFS.remove(CONFIG_FILE);
    if (!LittleFS.rename(tmpPath, CONFIG_FILE)) {
        Serial.println("[Config] Rename failed");
    }
}
