hflocki/camper-mqtt/firmware/emulator/camper_emulator/emu.cpp

#include "emu.h"

#include <math.h>
#include <time.h>
#include <algorithm>
#include <vector>
#include <map>

#ifndef EMU_HOST_TEST
#include <LittleFS.h>
#include <freertos/FreeRTOS.h>
#include <freertos/semphr.h>
#endif

// ============================================================
// Field table
// ============================================================
// Every value and setting of every emulated device is one field. The web UI is built
// from this table (GET /api/emu/schema), emu.json stores the values by key, and the
// builders below read them by key. Values are kept as text: numbers as typed, bools as
// ON / OFF, enums as one of the options.

enum FType : uint8_t { T_NUM, T_TEXT, T_BOOL, T_ENUM };

enum : uint8_t {
    FL_SET   = 1,    // setting (tank size, wheelbase ...), not a measured value
    FL_TOPIC = 2,    // a topic: changing it deletes the old retained topics
    FL_OPT   = 4,    // number that may be empty (e.g. "no alarm limit")
    FL_ADV   = 8,    // shown under "more" in the web UI
};

struct FieldDef {
    const char* key;     // unique key (web UI, emu.json)
    uint8_t dev;
    const char* group;   // heading inside the device card ("" = top)
    FType type;
    uint8_t flags;
    const char* label;
    const char* unit;
    float min, max, step;
    uint8_t dec;         // decimals when published
    float noise;         // +- random amplitude while noise is on (0 = none)
    const char* def;     // example value
    const char* opts;    // enum: "a,b,c" or "value=label,..."
};

#define NUM(k, d, g, fl, lbl, u, mn, mx, st, dc, nz, df) {k, d, g, T_NUM, fl, lbl, u, mn, mx, st, dc, nz, df, ""}
#define TXT(k, d, g, fl, lbl, df)                      {k, d, g, T_TEXT, fl, lbl, "", 0, 0, 0, 0, 0, df, ""}
#define BOOLF(k, d, g, fl, lbl, df)                    {k, d, g, T_BOOL, fl, lbl, "", 0, 0, 0, 0, 0, df, ""}
#define ENUMF(k, d, g, fl, lbl, df, op)                {k, d, g, T_ENUM, fl, lbl, "", 0, 0, 0, 0, 0, df, op}

// Temperature sensor slot n of camper-temp
#define TEMP_SLOT(n, on, id, name, t, lo, hi)                                                        \
    BOOLF("t" #n "_on", D_TEMP, "Sensor " #n, 0, "Sensor vorhanden", on),                           \
    TXT("t" #n "_id", D_TEMP, "Sensor " #n, FL_SET | FL_TOPIC, "ID (Topic)", id),                   \
    TXT("t" #n "_name", D_TEMP, "Sensor " #n, FL_SET, "Name", name),                                 \
    NUM("t" #n "_t", D_TEMP, "Sensor " #n, 0, "Temperatur", "°C", -40, 60, 0.1, 2, 0.1, t),         \
    BOOLF("t" #n "_ok", D_TEMP, "Sensor " #n, 0, "Sensor antwortet", "ON"),                         \
    NUM("t" #n "_lo", D_TEMP, "Sensor " #n, FL_SET | FL_OPT, "Alarm unter", "°C", -40, 60, 0.5, 1, 0, lo), \
    NUM("t" #n "_hi", D_TEMP, "Sensor " #n, FL_SET | FL_OPT, "Alarm über", "°C", -40, 60, 0.5, 1, 0, hi)

// Battery slot n of camper-battery
#define BAT_SLOT(n, on, id, name, type, soc, v, a, cap)                                              \
    BOOLF("b" #n "_on", D_BATTERY, "Batterie " #n, 0, "Batterie vorhanden", on),                    \
    TXT("b" #n "_id", D_BATTERY, "Batterie " #n, FL_SET | FL_TOPIC, "ID (Topic)", id),              \
    TXT("b" #n "_name", D_BATTERY, "Batterie " #n, FL_SET, "Name", name),                            \
    ENUMF("b" #n "_type", D_BATTERY, "Batterie " #n, FL_SET, "Typ", type, "1=Daly,2=Ective,3=BM2 (ohne Strom)"), \
    BOOLF("b" #n "_ok", D_BATTERY, "Batterie " #n, 0, "BMS antwortet", "ON"),                       \
    NUM("b" #n "_soc", D_BATTERY, "Batterie " #n, 0, "Ladezustand", "%", 0, 100, 1, 0, 0, soc),     \
    NUM("b" #n "_v", D_BATTERY, "Batterie " #n, 0, "Spannung", "V", 10, 15, 0.01, 2, 0.01, v),      \
    NUM("b" #n "_a", D_BATTERY, "Batterie " #n, 0, "Strom (+ = Laden)", "A", -100, 100, 0.1, 2, 0.2, a), \
    NUM("b" #n "_cap", D_BATTERY, "Batterie " #n, FL_SET, "Kapazität", "Ah", 10, 600, 10, 0, 0, cap), \
    NUM("b" #n "_temp", D_BATTERY, "Batterie " #n, FL_ADV, "Temperatur (Daly)", "°C", -20, 60, 0.5, 1, 0, "18"), \
    NUM("b" #n "_cyc", D_BATTERY, "Batterie " #n, FL_ADV, "Ladezyklen (Daly)", "", 0, 9999, 1, 0, 0, "42"), \
    BOOLF("b" #n "_prob", D_BATTERY, "Batterie " #n, FL_ADV, "BMS meldet Fehler", "OFF"),           \
    TXT("b" #n "_pt", D_BATTERY, "Batterie " #n, FL_ADV, "Fehlertext", "Zellspannung zu niedrig")

// Zigbee door / window contact slot n
#define ZB_CONTACT(n, on, ieee, name, open)                                                          \
    BOOLF("c" #n "_on", D_ZIGBEE, "Kontakt " #n, 0, "Kontakt vorhanden", on),                       \
    TXT("c" #n "_ieee", D_ZIGBEE, "Kontakt " #n, FL_SET | FL_TOPIC, "IEEE-Adresse", ieee),          \
    TXT("c" #n "_name", D_ZIGBEE, "Kontakt " #n, FL_SET, "Name (nur hier)", name),                   \
    BOOLF("c" #n "_open", D_ZIGBEE, "Kontakt " #n, 0, "Offen", open),                               \
    NUM("c" #n "_bat", D_ZIGBEE, "Kontakt " #n, FL_ADV, "Batterie", "%", 0, 100, 1, 0, 0, "90")

// Zigbee climate sensor slot n
#define ZB_CLIMATE(n, on, ieee, name, t, h)                                                          \
    BOOLF("k" #n "_on", D_ZIGBEE, "Klimasensor " #n, 0, "Sensor vorhanden", on),                    \
    TXT("k" #n "_ieee", D_ZIGBEE, "Klimasensor " #n, FL_SET | FL_TOPIC, "IEEE-Adresse", ieee),      \
    TXT("k" #n "_name", D_ZIGBEE, "Klimasensor " #n, FL_SET, "Name (nur hier)", name),               \
    NUM("k" #n "_t", D_ZIGBEE, "Klimasensor " #n, 0, "Temperatur", "°C", -40, 60, 0.1, 2, 0.1, t),  \
    NUM("k" #n "_h", D_ZIGBEE, "Klimasensor " #n, 0, "Luftfeuchte", "%", 0, 100, 1, 1, 0.5, h),     \
    NUM("k" #n "_bat", D_ZIGBEE, "Klimasensor " #n, FL_ADV, "Batterie", "%", 0, 100, 1, 0, 0, "85")

static const FieldDef FIELDS[] = {
    // ---- tanks (camper-tanklevel) ----
    TXT("tk_pre", D_TANK, "", FL_SET | FL_TOPIC | FL_ADV, "Basis-Topic", "camper/tanklevel"),
    NUM("w_pct", D_TANK, "Frischwasser", 0, "Füllstand", "%", 0, 100, 1, 0, 0.6, "62"),
    NUM("w_cap", D_TANK, "Frischwasser", FL_SET, "Tankgröße", "l", 10, 300, 5, 0, 0, "100"),
    BOOLF("w_filter", D_TANK, "Frischwasser", FL_ADV, "Glättung aktiv", "ON"),
    BOOLF("g_on", D_TANK, "Grauwasser", 0, "Grauwasser eingeschaltet", "ON"),
    NUM("g_pct", D_TANK, "Grauwasser", 0, "Füllstand", "%", 0, 100, 1, 0, 0.6, "35"),
    NUM("g_cap", D_TANK, "Grauwasser", FL_SET, "Tankgröße", "l", 10, 300, 5, 0, 0, "80"),
    BOOLF("g_filter", D_TANK, "Grauwasser", FL_ADV, "Glättung aktiv", "ON"),
    NUM("gas_pct", D_TANK, "Gas", 0, "Füllstand", "%", 0, 100, 1, 0, 0.4, "71"),
    NUM("gas_kg", D_TANK, "Gas", FL_SET, "Flasche (Füllmenge)", "kg", 1, 33, 0.5, 1, 0, "11"),
    ENUMF("gas_state", D_TANK, "Gas", 0, "Sensor", "OK", "OK,Kein Signal,Sensorfehler"),
    NUM("gas_bat", D_TANK, "Gas", FL_ADV, "Akku Sensor", "%", 0, 100, 1, 0, 0, "87"),
    NUM("gas_rssi", D_TANK, "Gas", FL_ADV, "Bluetooth-Signal", "dBm", -110, -30, 1, 0, 3, "-72"),

    // ---- level sensor (camper-level) ----
    TXT("lv_pre", D_LEVEL, "", FL_SET | FL_TOPIC | FL_ADV, "Basis-Topic", "camper/level"),
    NUM("pitch", D_LEVEL, "", 0, "Längsneigung (vorne höher +)", "°", -15, 15, 0.1, 1, 0.05, "0.4"),
    NUM("roll", D_LEVEL, "", 0, "Querneigung (links höher +)", "°", -15, 15, 0.1, 1, 0.05, "-0.3"),
    NUM("tol", D_LEVEL, "", FL_SET, "Toleranz", "°", 0.1, 5, 0.1, 1, 0, "0.5"),
    ENUMF("lv_sensor", D_LEVEL, "", 0, "Sensor", "OK", "OK,ERROR"),
    BOOLF("lv_tare", D_LEVEL, "", FL_ADV, "Nullpunkt gesetzt", "OFF"),
    NUM("wb", D_LEVEL, "Fahrzeug", FL_SET | FL_ADV, "Radstand", "m", 2, 6, 0.05, 2, 0, "3.5"),
    NUM("tw", D_LEVEL, "Fahrzeug", FL_SET | FL_ADV, "Spurweite", "m", 1.2, 2.4, 0.05, 2, 0, "1.7"),

    // ---- heater (camper-heater, Truma) ----
    TXT("ht_pre", D_HEATER, "", FL_SET | FL_TOPIC | FL_ADV, "Basis-Topic", "camper/heater"),
    BOOLF("alive", D_HEATER, "", 0, "CP Plus verbunden", "ON"),
    ENUMF("hvac", D_HEATER, "Raum", 0, "Raumheizung", "heat", "heat=An,off=Aus"),
    NUM("room", D_HEATER, "Raum", 0, "Raumtemperatur", "°C", -10, 40, 0.1, 1, 0.1, "19.5"),
    NUM("setp", D_HEATER, "Raum", 0, "Solltemperatur", "°C", 5, 30, 0.5, 1, 0, "21"),
    ENUMF("fan", D_HEATER, "Raum", 0, "Lüfterstufe", "eco", "eco,high,boost"),
    BOOLF("ht_dyn", D_HEATER, "Raum", FL_SET, "Raumtemperatur folgt der Heizung", "ON"),
    ENUMF("wmode", D_HEATER, "Warmwasser", 0, "Warmwasser", "off", "off=Aus,eco=Eco 40 °C,high=Hot 60 °C,boost=Boost"),
    NUM("water", D_HEATER, "Warmwasser", 0, "Wassertemperatur", "°C", 0, 80, 1, 1, 0, "38"),
    NUM("ht_err", D_HEATER, "Diagnose", 0, "Fehlercode (0 = keiner)", "", 0, 999, 1, 0, 0, "0"),
    BOOLF("decoke", D_HEATER, "Diagnose", FL_ADV, "Freibrennen", "OFF"),
    NUM("decoke_rem", D_HEATER, "Diagnose", FL_ADV, "Freibrennen Rest", "min", 0, 120, 1, 0, 0, "0"),

    // ---- roof fan (camper-maxxfan) ----
    TXT("mf_pre", D_FAN, "", FL_SET | FL_TOPIC | FL_ADV, "Basis-Topic", "camper/maxxfan"),
    BOOLF("mf_exp", D_FAN, "", FL_ADV, "Port-Expander erreichbar", "ON"),
    BOOLF("p1_on", D_FAN, "Anschluss p1", FL_SET, "Lüfter angeschlossen", "ON"),
    NUM("p1_speed", D_FAN, "Anschluss p1", 0, "Stufe (nur hier, 0 = Haube zu)", "", 0, 10, 1, 0, 0, "0"),
    BOOLF("p1_hold", D_FAN, "Anschluss p1", 0, "Auto-Halten", "OFF"),
    BOOLF("p1_led", D_FAN, "Anschluss p1", 0, "LED", "OFF"),
    BOOLF("p2_on", D_FAN, "Anschluss p2", FL_SET, "Lüfter angeschlossen", "OFF"),
    NUM("p2_speed", D_FAN, "Anschluss p2", 0, "Stufe (nur hier, 0 = Haube zu)", "", 0, 10, 1, 0, 0, "0"),
    BOOLF("p2_hold", D_FAN, "Anschluss p2", 0, "Auto-Halten", "OFF"),
    BOOLF("p2_led", D_FAN, "Anschluss p2", 0, "LED", "OFF"),

    // ---- temperatures (camper-temp) ----
    TXT("tp_pre", D_TEMP, "", FL_SET | FL_TOPIC | FL_ADV, "Basis-Topic", "camper/temp"),
    TEMP_SLOT(1, "ON", "fridge", "Kühlschrank", "5.0", "", "8"),
    TEMP_SLOT(2, "ON", "freezer", "Gefrierfach", "-17.0", "", "-12"),
    TEMP_SLOT(3, "OFF", "interior", "Innenraum", "20.0", "5", ""),
    TEMP_SLOT(4, "OFF", "outside", "Außen", "8.0", "", ""),

    // ---- batteries (camper-battery) ----
    TXT("bt_pre", D_BATTERY, "", FL_SET | FL_TOPIC | FL_ADV, "Basis-Topic", "camper/battery"),
    BAT_SLOT(1, "ON", "house", "Bordbatterie", "2", "78", "13.25", "-4.2", "100"),
    BAT_SLOT(2, "OFF", "starter", "Starterbatterie", "3", "90", "12.70", "0", "70"),

    // ---- toolbox (camper-toolbox, roof hatch over the plugin rvtech) ----
    TXT("tb_pre", D_TOOLBOX, "", FL_SET | FL_TOPIC | FL_ADV, "Basis-Topic", "camper/toolbox"),
    BOOLF("rv_on", D_TOOLBOX, "Dachhaube (Heki)", FL_SET, "Dachhaube gekoppelt", "ON"),
    BOOLF("rv_conn", D_TOOLBOX, "Dachhaube (Heki)", 0, "Bluetooth verbunden", "ON"),
    NUM("rv_pos", D_TOOLBOX, "Dachhaube (Heki)", 0, "Position (102 = Lüften)", "", 0, 102, 1, 0, 0, "0"),
    NUM("rv_tgt", D_TOOLBOX, "Dachhaube (Heki)", FL_ADV, "Ziel (fährt dorthin)", "", 0, 102, 1, 0, 0, "0"),
    NUM("rv_speed", D_TOOLBOX, "Dachhaube (Heki)", FL_SET | FL_ADV, "Geschwindigkeit", "%/s", 1, 50, 1, 0, 0, "5"),

    // ---- router (RUT956 "Data to Server") ----
    TXT("rut_t", D_ROUTER, "Topics", FL_SET | FL_TOPIC | FL_ADV, "GPS (JSON)", "camper/rut"),
    TXT("door_t", D_ROUTER, "Topics", FL_SET | FL_TOPIC | FL_ADV, "Tür (Digital-Eingang)", "camper/door"),
    TXT("mob_t", D_ROUTER, "Topics", FL_SET | FL_TOPIC | FL_ADV, "Mobilfunk", "camper/router/mobile"),
    TXT("awn_t", D_ROUTER, "Topics", FL_SET | FL_ADV, "Markisen-Befehl des Displays (Szenario Abfahrt)", "camper/display/cmd/awning"),
    NUM("spd", D_ROUTER, "GPS", 0, "Geschwindigkeit", "km/h", 0, 160, 1, 1, 0, "0"),
    BOOLF("fix", D_ROUTER, "GPS", 0, "GPS-Fix", "ON"),
    NUM("lat", D_ROUTER, "GPS", FL_ADV, "Breite", "°", -90, 90, 0.0001, 6, 0, "51.000000"),
    NUM("lon", D_ROUTER, "GPS", FL_ADV, "Länge", "°", -180, 180, 0.0001, 6, 0, "10.000000"),
    NUM("alt", D_ROUTER, "GPS", FL_ADV, "Höhe", "m", -100, 4000, 1, 1, 0, "200"),
    NUM("sats", D_ROUTER, "GPS", FL_ADV, "Satelliten", "", 0, 30, 1, 0, 0, "9"),
    ENUMF("door", D_ROUTER, "Tür", 0, "Tür", "close", "close=Zu,open=Offen"),
    BOOLF("mob_on", D_ROUTER, "Mobilfunk", FL_SET, "Mobilfunk senden", "ON"),
    NUM("rsrp", D_ROUTER, "Mobilfunk", 0, "RSRP", "dBm", -140, -44, 1, 0, 3, "-92"),
    NUM("rssi", D_ROUTER, "Mobilfunk", FL_ADV, "RSSI", "dBm", -110, -40, 1, 0, 2, "-65"),
    ENUMF("net", D_ROUTER, "Mobilfunk", 0, "Netz", "LTE", "5G,LTE,3G,2G"),
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
