hflocki/camper-mqtt/(commit log)

2026-10-13 Update gas level sensor link in README
2026-10-13 Fix link formatting for gas level sensor in README
2026-10-14 Refactor MQTT topic handling and rendering logic
    Refactor MQTT handling for water and gas topics to support combined device status. Update rendering logic to change page order.
2026-10-14 add gray water sensor
2026-10-15 Update config.example.h with sensor definitions
    Added configuration options for sensors in RoadBuddy.
2026-10-15 Refactor roadbuddy.ino for sensor handling and display
2026-10-15 Refactor sensor handling and update display logic
2026-10-22 Initial release: VanTurtle MaxxFan control via MQTT (Arduino, ESP32-C3)
    Claude-Session: https://claude.ai/code/session_014RMk98fAHPMn5ym1ahe8j4
2026-10-22 ESP32-S3 support, WiFi diagnostics, TX power and AP fallback option
    - ADC pins are selected per chip: C3 GPIO0/1, S3 GPIO1/2 (GPIO0 has no
    ADC on the S3), classic ESP32 GPIO34/35. New PlatformIO env esp32-s3.
    - Web UI (tab WiFi): uptime, reason of the last reset (brownout, crash,
    watchdog ...), WiFi drop counter and the last disconnect reason.
    Disconnect reasons are also logged on the serial monitor.
    - TX power selectable in the web UI (8.5 - 19.5 dBm, default 17.5).
    - "Access point always on" can be switched off: the AP then only starts
    as fallback after 60 s without WiFi, for a more stable connection.
    Claude-Session: https://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
2026-10-23 Unify camper devices: topics, alarms, web login, CI
2026-10-24 Add camper-level (fork of klehnst level sensor)
2026-10-24 tanklevel: support Mopeka Pro gas sensors
2026-10-24 tanklevel: support Mopeka Standard (Std Check) sensors
2026-10-24 battery: BLE gateway for Daly BMS and Ective BM X
2026-10-25 roadbuddy: temperature pages from camper-temp
2026-10-25 maxxfan: close lid, set speed from the top; display: close button
2026-10-26 battery: AtomS3 Lite with status LED, CI build for ESP32-S3
2026-10-26 battery: BM2 battery monitor, firmware and web page upload via web UI
2026-10-26 battery: BM2 battery state, hide values the BM2 cannot measure
2026-10-26 battery page on Road Buddy, battery warnings and card on display
2026-10-26 display: battery page, Pushover error details
2026-10-26 display: 3x3 overview tiles, display name in header, LVGL buffers in PSRAM for HTTPS, wake only on new warnings, wake button on web page
2026-10-26 display: validate static IP, DHCP fallback without MQTT, DHCP button, static IP defaults in config_local.h
2026-10-26 display: renamable fixed pages, home button in header
2026-10-26 battery: read the BM2 from its broadcast, connection only as fallback
2026-10-26 device template with copy script and guide
2026-10-26 display: device links page on the web page
2026-10-27 heater: heater model selection (web UI, MQTT, HA), live switch
2026-10-27 docs: clickable mockups of all device web pages
2026-10-28 heater: own PCB (ESP32-C3, TJA1021, fused 12 V input) with PCBWay files
2026-10-28 display 2.2.0: choose sensors/batteries and icons for the overview tiles, weather via HTTPS
2026-10-28 display 2.3.0: screen always turns off after the timeout, warnings wake it only if enabled, screen-off buttons
2026-10-28 heater: keep own PCB files local, remove from repo
2026-10-28 display 2.4.1: compact battery cards so three fit on the page
2026-10-29 heater 1.3.0: LIN bus diagnosis in log and web UI, raw dump
2026-10-29 display 2.8.0: own Zigbee and Bluetooth sensors; omg: OpenMQTTGateway BLE gateway via PlatformIO
2026-10-31 display: light page and tile, sensors on the light page, settings in groups
2026-10-31 display: switch page, two spare pages, page icons, all sensor pages selectable
2026-11-01 display: gas bottle and water tank drawings that fill up, no tile gradient, pitch shown as P
2026-11-01 display: colour icon circles, large/small battery and temperature tiles, segment bar, signal bars, runtime clock, sunrise/sunset
2026-11-02 display, roadbuddy: level page as top view with wedges per wheel (display v2.9.11, roadbuddy v1.2.0)
    Claude-Session: https://claude.ai/code/session_014ypCkRjjQmMjihQkPhR4cD
2026-11-02 common: add devinfo, publish <prefix>/info on all devices
2026-11-02 display: device list, built-in limit warnings with hysteresis, push quiet time; tools: MQTT simulator and recorder
2026-11-02 display: selectable outdoor sensor, awning switch with gust warning
2026-11-02 level: default I2C pins SDA 2 / SCL 1 (v2.1.2); display: name truma as heater (v2.9.17)
2026-11-02 emulator: test device that emulates the built-in devices, router and Zigbee with a web UI
2026-11-02 display: system page shows the network devices first, then QR code and brightness, then the display info
2026-11-02 emulator: stream the device schema in small chunks so the device list loads with all broker connections up (v1.0.1)
2026-11-03 repo: drop the _arduino folder level, sketches now live in firmware/<device>/<sketch>
2026-11-03 repo: fix CI paths after the folder move, drop PlatformIO, add pack_web.py; display: remove left-over devices from the broker; tools: clean.py; maxxfan, tanklevel, level: firmware marker, upload chec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
2026-11-03 all devices: firmware marker with upload checks, event log and rollback after a failed update (temp on ESP8266: checks and log only)
2026-11-03 omg: fix build with OMG v1.8.1 (no platform_packages), status LED off
2026-11-03 toolbox: move camper_toolbox into the repo (v1.0.0, safe update, event log, rollback, info topic); display: name toolbox in the device list
2026-11-03 toolbox: web UI in the look of the other devices (v1.0.1)
2026-11-04 docs: README in English with README.de.md, why section, quick start
2026-11-04 heater: ESP32 DevKit profile (TX 16 / RX 17), default board per chip, ESP32 release build
2026-11-04 web: shared camper theme for all device pages (synced block), SVG tab icons
2026-11-04 heater: web UI from web/index.html (embedded), shared camper design
2026-11-04 display: contacts and climate sensors as small tiles (4 per row)
2026-11-04 display: sensor pages as tile grid (3 per row on phones), design draft under docs/mockups/design
2026-11-04 emulator: Python tool with local web page under tools/emulator, ESP32 firmware removed
2026-11-04 display: own tile layout for the web home (slots per group), separate from the panel
2026-11-05 Rename project to VanNode (docs, comments, template, repo links)
    Device web pages and the shared theme keep the old name in a CSS comment for now,
    so no device needs a release just for the rename.
    Claude-Session: https://claude.ai/code/session_014ypCkSJAoYes35iuDiwGfD
2026-11-07 Device names <device>-node: hostname, setup WiFi, device name, release files
    MQTT topics (camper/...), Home Assistant node ids and the firmware marker stay
    unchanged, so existing installs keep working. Mockups and design draft follow.
    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
2026-11-07 mockups: regenerate display mockup (button text)
    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
2026-11-07 CI: bundle release (tag bundle-v<version>) with the firmware files from .github/bundle.txt
    Builds every device and attaches the listed .bin files, the packed web pages and a
    version table to one release.
    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
2026-11-07 toolbox 1.2.1: plugin updates for pump, roof hatch and fridge
    - pump: third GATT layout FFE0/FFE1, running from status bit 4, pressure from psi x 10,
    status frames of other pumps accepted (own command echo skipped)
    - roof hatch: telegram reassembly also finds P_a=NNN after junk in a line
    - fridge: empty UUID fields mean the BLE UART bridge FFE0/FFE1
    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
2026-11-07 VanNode symbol on all web pages and on the wall panel
    - web pages of all devices, display, Road Buddy update page and emulator: favicon and
    the symbol left of the page title (shared blocks vannode.css / vannode-icon.html)
    - wall panel: symbol left of the page title in the header (also on the warning banner)
    and in the middle of the QR code on the system page
    - tools/logo/make_logo.py also builds the web blocks and the panel images
    Versions: display 2.16.0, heater 1.6.1, maxxfan 1.8.1, battery 1.5.1, tanklevel 1.9.1,
    temp 1.4.1, level 2.4.1, toolbox 1.2.2, roadbuddy 1.5.2
    Claude-Session: https://claude.ai/code/session_014ypCkSJAoYe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
